Morfey1974/HVAC_CleanRoom_Project/Docs/WhatsApp Image 2026-07-08 at 12.15.31 (1).jpeg

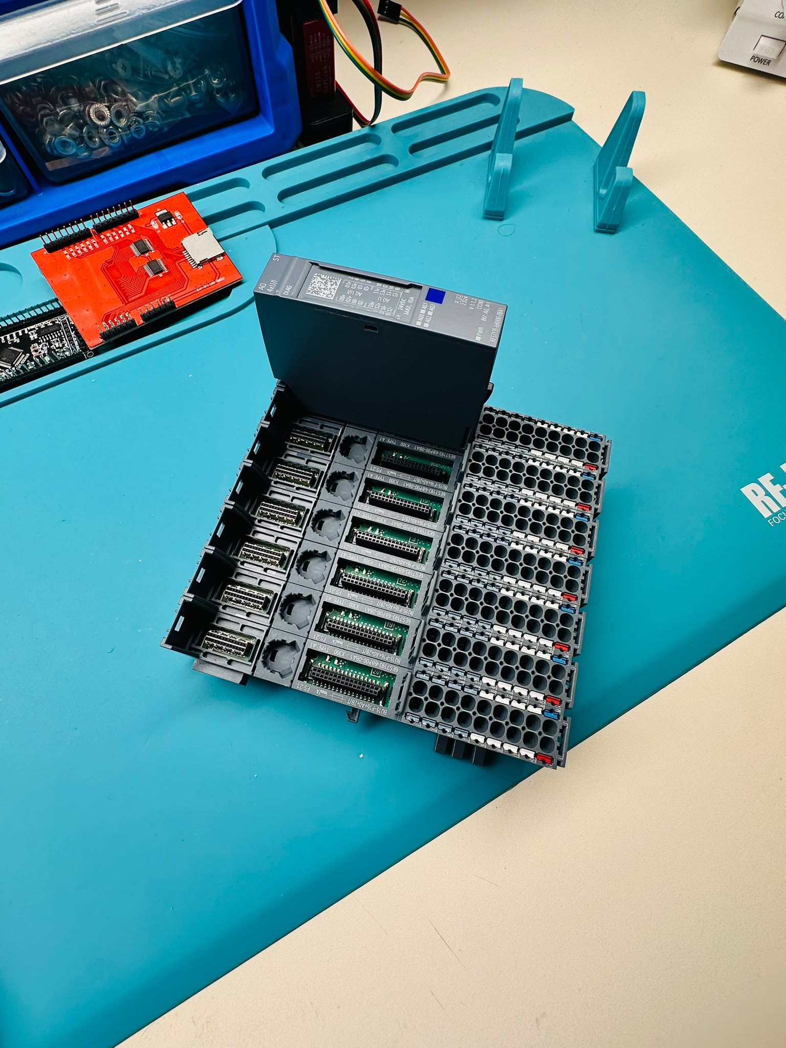
Docs/WhatsApp Image 2026-07-08 at 12.15.31 (1).jpeg
