Morfey1974/HVAC_CleanRoom_Project/Firmware_MainPLC/HANDOFF_модульная_система.md

# Резюме чата: модульная система I/O для HVAC / здания

**Дата:** 2025–2026 (чат в проекте Industrial Door PLC)  
**Цель документа:** передать контекст в новый проект модульной системы датчиков.

---

## 1. Общая идея

- **Головной PLC** — на базе платы контроллера дверей DCM (**STM32H723**, Ethernet RMII, CAN, RS-485, 24 V DC). Из схемы убрать всё, что связано с дверями (замки, светофоры, DI/DO дверей, ALARM). Остаётся «каркас» МК + связь.
- **Контроллер дверей** — отдельный узел, данные на головной PLC по **CAN** (уже есть в системе дверей).
- **Модули I/O** — **собственная разработка и бренд**, не Wago/Siemens.
- **Монтаж:** кабель с объекта (AWG22/24) **напрямую на клеммы модуля** на DIN-рейке — **без** промежуточных клеммников «модуль → ряд клемм на рейке» (как на фото шкафа Siemens S7-1500).
- **Модули в цепочке** («паровозик») на DIN, боковые разъёмы plug-and-play.
- **Пуск за 2–3 часа** техником без языков программирования — через **своё приложение** (визуальная карта, привязка модулей/комнат, уставки). На этапе схем это только **требования к железу** (discovery, один logical device на поезд).

---

## 2. Архитектура поезда

```
[ Головной PLC (STM32H723) ] ←—— 1 кабель на поезд ——→ [ M-GW Шлюз ]
                                                            │ внутр. RS-485
                                        [Slice]—[Slice]—…—[ M-END ]
                                         4 клеммы поля
```

- **M-GW (шлюз)** — единственная точка связи поезда с PLC; master внутренней шины; **без DIP-адресов** для техника.
- **M-SLC-* (slice)** — полевые клеммы + внутренняя шина; **не** Ethernet/Modbus наружу.
- **M-END** — конец поезда, терминатор 120 Ω, проход 24 V.
- До **~100 точек** на объект → несколько поездов (**8–12 slice** на поезд — ориентир).

---

## 3. Ключевое решение по модулям датчиков

### Не делаем M-SLC-AI8-420 (16 клемм на 4 датчика)

### Делаем: **один модуль — один полевой прибор** (4 провода)

Пример: **Rotronic HF13x** (T + RH):

| Клемма | Сигнал |
|---|---|
| 1 | +24 VDC |
| 2 | GND |
| 3 | OUT1 — влажность (4–20 mA) |
| 4 | OUT2 — температура (4–20 mA) |

- **2 аналоговых входа AI** на модуль (не 8 AI на 8 датчиков).
- **Правило монтажа:** **один провод — одна клемма**, без пучков и без нескольких жил в одном винте.
- Ширина корпуса — на усмотрение заказчика (~4 mm на клемму DIN); допускается **один ряд** или **двухэтажные клеммы** (2×2); опционально вариант на **2 датчика** в двухэтажном корпусе — габариты не в ТЗ на схемы.
- Базовое обозначение: **M-SLC-AI2-420** (или M-SLC-TH1).

---

## 4. Связь

### PLC ↔ шлюз (M-GW)

**Рекомендация:** **Ethernet, Modbus TCP** — один IP на поезд, один logical slave = весь поезд.  
При ~10 поездах на объект — предпочтительно Ethernet, а не 10 UART.

**Альтернатива:** RS-485 Modbus RTU, **один адрес на поезд**, RJ-45 с **задокументированной** распиновкой.

На **STM32H723** (CubeMX): **UART4** (PC10/11, DE PA15) и **USART3** (PD8/9) — для RS-485 это **2 независимые линии** (= 2 поезда). UART vs USART **не важно** — оба подходят для 8N1. В проекте дверей UART4 = IDP-485, USART3 = отладка — при HVAC переназначить.

### Внутри поезда (шлюз ↔ slice)

- **RS-485**, 115200, 8N1.
- Боковой разъём: +24V, GND, BUS+/BUS−, CHAIN (автонумерация слота).
- Slice: тип в EEPROM, **без** настройки адреса техником.

---

## 5. Электрика slice (для ТЗ на схемы)

- Гальваническая развязка поля (ориентир ≥1500 V RMS — уточнить в схеме).
- 4–20 mA: шунт / analog front-end, 16-bit ADC, обрыв / перегруз.
- Питание датчика +24 V с модуля — указать max ток.
- MCU на slice: опционально (может быть только front-end под управлением шлюза — решение фрилансера).

---

## 6. Номенклатура (этап 1 для фрилансера)

| Модуль | Назначение |
|---|---|
| **M-GW** | Шлюз поезда |
| **M-SLC-AI2-420** | 4 клеммы, 2×4–20 mA, 1 датчик T+RH |
| **M-END** | Конец шины |
| Позже | AI1-010, AO, DO, дисплей у комнаты |

---

## 7. ТЗ на схемы — что сдать фрилансеру

**В scope:** принципиальные схемы PDF + САПР, BOM, распиновка разъёмов, пояснительная записка, черновик карты регистров Modbus на поезд, расчёт 24 V.

**Вне scope:** PCB, корпуса, прошивка, приложение, головной PLC.

**Приёмка:** M-GW + M-SLC-AI2-420 + M-END полностью; единый боковой разъём; ERC чистый.

---

## 8. Отклонённые / уточнённые варианты

- ❌ Процессор + Modbus в **каждом** slice — дороже; для масштаба лучше **шлюз + slice**.
- ❌ AI8 с общими шинами +24/GND на одной клемме — **не по регламенту монтажа** заказчика.
- ❌ Сравнение с ET200/Wago как целевая продукция — только как референс идеи «клеммы на модуле»; настройка TIA неприемлема.
- ✅ Убрать провода PLC → клеммники → поле (как на фото шкафа Siemens).

---

## 9. Референсы в проекте дверей (Industrial Door PLC)

- Схема головного контроллера: `Documentation/Schematic_Industrial-door-controller-Master_2025-06-02.pdf`
- MCU: STM32H723
- RS-485 дверей (IDP-485): UART4, отдельный протокол от Modbus модулей I/O
- CAN: контроллер дверей

---

## 10. Открытые вопросы для нового чата

1. Ethernet vs RS-485 к шлюзам — финальный выбор.
2. MCU на slice или только analog front-end.
3. Распиновка RJ-45 (Ethernet vs полевой RS-485).
4. Карта регистров Modbus и протокол discovery.
5. Корпуса и точный тип клемм (заказчик).
6. Прошивка M-GW и приложение пуска.

---

## 11. Диаграмма целевой системы

```
        [ Ethernet / RS-485 вверх ]
                  │
        [ Головной PLC STM32H723 ]
           CAN          │ Modbus/Eth (несколько поездов)
              │         │
    [ PLC Doors ]   [ M-GW ]—[Slice]—[Slice]—[END]
                    [ M-GW ]—[Slice]—…
```

---

*Конец резюме. Продолжение: ТЗ для фрилансера, карта регистров, выбор Ethernet к шлюзам.*
