Morfey1974/HVAC_CleanRoom_Project/HANDOFF_HVAC.md

# HANDOFF: Проект HVAC_CleanRoom

**Актуализация:** 2026-10-02 (по фактическому состоянию репозитория).

## 1. Суть проекта
Распределенная система климат-контроля чистых помещений: Главный ПЛК, локомотивы (концентраторы), хаб дисплеев, вагоны (модули I/O), панели оператора. Связь — CAN/FDCAN.

## 2. Аппаратная часть (Analog_Modul_AI — вагон)
*   **МК:** STM32G0B1RBT6 (не F042 — устаревшая запись).
*   **CAN:** FDCAN2, 50 кбит/с, пины PC2 (RX), PC3 (TX).
*   **АЦП:** ADS1220 по SPI1 — PA5 SCK, PA6 MISO, PA7 MOSI; CS = PA4 (`STM_CS`); DRDY = PC4 (`STM_DRDY`, EXTI). SPI: 8 bit, CPHA = 2 Edge.
*   **Питание / поле:** 24 VDC, шина с CAN_H/CAN_L (детали в Docs / схемах Modul_AI).
*   **Статус:** проект CubeMX + HAL-каркас есть; драйвер ADS1220 и прикладной протокол CAN — впереди.

## 3. Остальные узлы (факт по репозиторию)
| Узел | МК | Статус |
|---|-----|---|
| Firmware_MainPLC | STM32H723ZGT6 | Есть: FreeRTOS, ETH+LwIP, FDCAN1–3, USB CDC, RS485-задачи |
| Firmware_Locomotive | STM32G0B1RBT6 | Каркас: FDCAN1+FDCAN2 @ 50 кбит/с |
| Firmware_HUB_Displays | STM32G0B1RBT6 | Каркас: FDCAN1+FDCAN2 @ 50 кбит/с |
| Firmware_Displays (TFT5) | STM32H723 | Legacy-панель SSD1963 |
| Analog_Modul_AO / DI / DO | — | Папки пустые |
| Shared_Libs | — | Пусто |
| Web_Interface | — | Пусто |

**Docs:** схемы HUB/AI/Main, `MainPLC_Hardware_Spec.md`, 3D (Modul HUB Display, Modul_AI, Modul_Lokomotiv), даташиты TFT 4.3" и 10.1", сметы.

## 4. Структура (Monorepo)
`Docs/`, `Shared_Libs/`, `Firmware_Wagons/`, `Firmware_Locomotive/`, `Firmware_HUB_Displays/`, `Firmware_MainPLC/`, `Firmware_Displays/`, `Web_Interface/`.

С 2026-10-04 у каждого модуля две части — два отдельных проекта CubeIDE: `<модуль>/Application` (основная прошивка) и `<модуль>/Bootloader` (загрузчик, пока пусто). Модули: `Firmware_MainPLC`, `Firmware_Locomotive`, `Firmware_HUB_Displays`, `Firmware_Displays/Display_TFT4.3` (проект «STM32H723ZGT6 with TFT5 SSD1963»), `Firmware_Wagons/Analog_Modul_AI|Analog_Modul_AO|Digital_Modul_DI|Digital_Modul_DO`. Имена проектов в CubeIDE не менялись. Общее для загрузчиков: `Shared_Libs/fwupd` (протокол обновления, заголовок прошивки, CRC32), `Shared_Libs/boot_core/stm32g0|stm32h7` (ядро загрузчика по типу чипа). Shared_Libs подключён в проектах как `${workspace_loc:/HVAC_CleanRoom_Project/Shared_Libs}` — от переноса не зависит.

CubeIDE: Hierarchical Presentation.

## 5. Следующие шаги
1. **`Shared_Libs/hvac_can.h`** — общий формат кадров (подключён в include paths Loco / AI / HUB / Displays). Сделано: кадр 0x301 «измерение AI» (влажность и температура ×0.01, байт статуса: обрыв/перегруз каналов, нет ответа АЦП, «нет связи» от локомотива; счётчик). Путь (с 2026-10-04): AI CAN2 → Loco CAN1 → Loco CAN2 → **MainPLC CAN1 → MainPLC CAN2** → HUB CAN2 → HUB CAN1 → дисплей CAN1. MainPLC: шлюз `plc_can.c` (пересылка 0x301, свой NO_LINK при молчании локомотива 2 с), веб-страница `plc_web.c` на http://192.168.1.50 (`/api/ai` — JSON). Двери (с 2026-10-04): MainPLC — Modbus RTU Master на RS-485 (UART4, DE=PA15, 115200 8N1), `plc_modbus.c` опрашивает DCM SuperPharm (адрес 1, ф-ция 0x02, адр. 0, кол-во 5, раз в 500 мс, таймаут 300 мс, 3 неответа → нет связи); кадр 0x310 (байт 0 — маска «закрыта», байт 1 — статус 0x80 «нет связи») раз в 500 мс в CAN2 → HUB → дисплей (блок «ДВЕРИ» в шапке справа). Временно на старой плате ПЛК — HSI вместо HSE (нет кварца). ETH-буферы — в D2 SRAM через `eth_dma_insert.ld` (второй -T для Debug, т.к. MMT-шаблон перегенерируется), куча lwIP с 0x30005000. Дальше — адресация и типы модулей.
2. **Analog_Modul_AI** — драйвер ADS1220 (SPI + DRDY), публикация измерений по CAN.
3. **Выровнять битрейт MainPLC FDCAN** с полевой сетью 50 кбит/с (сейчас в IOC номинал выглядит незавершённым).
4. **CAN-загрузчики (решения 2026-10-02; принцип и план обновления «одной кнопкой» приняты 2026-10-04 — `Docs/Firmware_Update_Concept.md`: главное хранилище — комп, на ПЛК копия текущих версий; сначала идентификация, потом обновление; новые/заменённые модули — автоматически, работающие — только по команде; молчание модуля не повод для прошивки; из OpenBLT — только идеи):**
   - Каждый модуль (Loco, HUB, AI/AO/DI/DO, дисплеи) заводски прошивается через ST-LINK **только загрузчиком**; экспериментальные прошивки модулей удаляются, в папке каждого модуля — свой загрузчик.
   - Загрузчик несёт данные модуля: **тип модуля** (зашит при сборке, у каждого вида платы свой), UID чипа, версию загрузчика, версию/CRC рабочей прошивки. Пины ID задают только позицию в цепочке, не тип.
   - Рабочие прошивки модулей хранит Главный ПЛК и рассылает по CAN (транзит через Loco/HUB) согласно типу и присвоенному ID.
   - Состояния модуля: «новый, без рабочей прошивки» и «есть прошивка, требуется обновление».
   - **Замена модуля:** ПЛК обнаруживает новый/заменённый модуль; пустому — заливает прошивку; если прошивка есть — проверяет версию и целостность (CRC), устаревшую или битую — перезаливает.
   - Эксперимент MainPLC (когда придёт плата): идентификация всех подключённых модулей → присвоение ID → рассылка прошивок → вывод T/RH с HF523 на дисплей.
   - Загрузчики, протокол идентификации/адресации и обновления, хранение прошивок в ПЛК — пишутся **сразу как боевые заготовки** (общие модули в Shared_Libs, без хаков), чтобы перейти в рабочий код без переделок. Экспериментальная часть — только прикладная логика T/RH.
   - **Этап 1 (код готов 2026-10-04, ждёт проверки на железе):** протокол `Shared_Libs/fwupd/` (fwupd_proto.h, fwupd_app.c — часть рабочей прошивки), ядро загрузчика G0 `Shared_Libs/boot_core/stm32g0/`. Локомотив: проект `Firmware_Locomotive/Bootloader` (16 КБ, 0x08000000, -Os), рабочая прошивка с 0x08004000 и заголовком HVFW на +0x100, метаданные 0x0801F800. MainPLC: `plc_fwupd.c` (перекличка и обновление по CAN1). Этап 1 проверен на железе 2026-10-04 (встроенный образ потом удалён).
   - **Обновление по Ethernet (код готов 2026-10-05, ждёт проверки на железе):** MainPLC: `plc_w25q.c` (W25Q128 по OCTOSPI1, одна линия), `plc_fwstore.c` (на тип модуля 1 МБ = два места по 512 КБ: дескриптор "FWST" 4 КБ + образ; роли текущая/новая/резервная; загрузка всегда в не-текущее место; перевод новая→текущая после удачного обновления всех модулей), `plc_fwupd.c` (авто — образом «текущая»; ручной запуск по типу — «новая», режимы «с другой версией» / «все»; журнал 32 события), `plc_web.c` (HTTP: `GET /api/fw/status?log=N`, `POST /api/fw/upload?size=&crc=` потоком в W25Q, `POST /api/fw/run?type=&mode=`, `POST /api/fw/cancel`). Приложение Web_Interface: таблица `FirmwareFiles` (миграция Firmware), разбор .bin/.elf (заголовок HVFW, дополнение до 8 байт 0xFF, CRC32), `FirmwareController` (/api/firmware, роли Engineer/Admin), `PlcFirmwareClient` (адрес из «Система → Общие → IP-адрес ПЛК», запросы к ПЛК по одному), `PlcFirmwareLogPoller` (журнал ПЛК → журнал действий, каждые 5 с), вкладка «Система → Прошивки». Отладка в CubeIDE: Live Expressions `g_plc_fwupd`.
   - **Будущее (после проверки Ethernet на MainPLC, вместе с веб-конфигуратором):** ID модулей должны совпадать с нумерацией в веб-конфигураторе. Конфигурация уходит в ПЛК, ПЛК обходит цепочку и присваивает ID по ней; несовпадения (тип не тот, модуля нет, лишний модуль, дубль номера) — сообщения с описанием проблемы в веб и на дисплей. Сейчас — только задел: формат ID и обход цепочки проектировать так, чтобы ID можно было брать из конфигурации, а не только по порядку.
5. Заполнить AO / DI / DO и Web_Interface по мере готовности железа.
6. **Web_Interface: реальные T/RH в комнатах (код готов 2026-10-05, ждёт проверки на стенде).** Библиотека: у датчиков список выходов (величина, сигнал, диапазон, ед.) — `LibraryItem.OutputsJson`, миграция SensorOutputs. Проект: канал модуля привязывается к оборудованию-датчику и номеру его выхода (`ModuleChannelDto.EquipmentId/Output`, редактор каналов в «Модулях» и на схеме). Источник данных «Система → Общие»: симулятор или «ПЛК по Ethernet» — `PlcLiveLink.cs` (`PlcLinkRouter`, `PlcLiveReader`: раз в 1 с `GET /api/ai`, раз в 5 с перечитывает режим и проводку активного на объекте проекта). Сейчас ПЛК отдаёт одно измерение AI: влажность → `<ID первого AI>.CH1`, температура → `.CH2`; аварии plcOffline/locoNoLink/aiNoAnswer/aiAdcFault/displayBusOff/channelBroken. «Мониторинг»: полоса состояния цепочки (ПЛК, локомотив, AI, измерение, передано на дисплей) и карточки комнат (значения датчиков комнаты против уставки/допуска; демо-мнемосхема только у DEMO-001). Дальше: редактор мнемосхем HMI, единые коды типов модулей приложения и прошивки.
7. **Конфигурация в ПЛК (код готов 2026-10-05, ждёт проверки на стенде).** Приложение собирает из проекта файл HCFG (модули + каналы с сигналом и диапазоном датчика) и заливает в ПЛК (раздел проекта «Выгрузка в ПЛК», только активный на объекте проект). ПЛК 1.1: plc_cfg.c — хранение в W25Q 0x0000–0x7FFF (две копии), рассылка 0x330 модулям, приём 0x331, проверка цепочки, /api/cfg, /api/cfg/status, события журнала 14–17. Локомотив 1.1 пересылает 0x330/0x331. AI 1.1 принимает тип сигнала (выкл / 4-20 / 0-20 мА) и диапазон канала, шлёт статус раз в 1 с; по умолчанию как раньше (CH1 0..100, CH2 0..50, 4-20 мА). Подробно — Docs/Firmware_Update_Concept.md, раздел 5.
8. **Загрузчики всех модулей, номера по цепочке, откат (код готов 2026-10-05, ждёт проверки на стенде).** Новые проекты CubeIDE: `Analog_Modul_AI_Bootloader`, `Firmware_HUB_Displays_Bootloader`, `Display_TFT4.3_Bootloader` (H7, без .ioc; ядро `Shared_Libs/boot_core/stm32h7`). Рабочие прошивки: AI (тип 5) и HUB (тип 3) с 0x08004000, дисплей (тип 4) с 0x08020000 (VTOR 0x08020400). ПЛК 1.2: обновление по обеим шинам (CAN1 — локомотив, CAN2 — HUB и дисплеи), `plc_id.c` — обход цепочки ID и номера из конфигурации, проверка мест в `plc_cfg.c` (нет / другой тип / лишний / вне цепочки), кадр 0x352 итога для дисплеев, `POST /api/id/walk`, `POST /api/fw/rollback?type=`. Локомотив 1.2 и HUB 1.1 пересылают кадры обновления и ID. Дисплей 1.1 показывает свой номер и первую проблему цепочки. Приложение: «Выгрузка в ПЛК» — колонка «Плата», лишние модули, кнопка «Найти модули»; «Прошивки» — кнопка «Откатить». Выходы ID считаются активными высоким уровнем — проверить на стенде. Подробно — Docs/Firmware_Update_Concept.md.
9. **Линия 3 на CAN3 и мастер дверей (ПЛК 1.4, 2026-10-06, прошит, стенд 1–2 линий в норме).** CAN3 (FDCAN3, настройки MX без изменений) — линия ID 3 (выход PE1 `MODUL_ID_OUT_BUS`): обход, номера, обновление прошивок, CFG_SET по линии модуля (`PlcCan_LineBus`). Кадры AI, 0x310 и 0x352 ПЛК шлёт в CAN2 и CAN3 (AI не возвращается в шину, откуда пришёл). Обмен с мастером дверей описан в `Shared_Libs/hvac_can.h`: 0x320 состояние (мастер → ПЛК, 500 мс), 0x321 команда, 0x322 ответ, 0x323 «ПЛК жив» (1 с). Пока приходит 0x320, двери для дисплеев берутся из него, иначе по Modbus. ПЛК: `GET /api/can3`, `POST /api/can3/send?id=&data=`, `POST /api/doors/cmd?cmd=&mask=`. Приложение: «Система → CAN3 и двери». Протокол мастера — предложение со стороны HVAC, сверить при подключении платы мастера. Повторная отправка CAN в MX выключена на всех трёх шинах (кадр без подтверждения теряется). Вагоны прямо на шине без головы конфигуратор пока не допускает; локомотив, у которого оба CAN на одной шине, зациклит кадры.
10. **Редактор HMI и ИИ-помощник (решения 2026-10-07, Docs/Web_Interface_Plan.md §5.7).** Плоский вид со склейкой секций установки, комнаты — плитки в ряд, 3D — отдельный просмотр позже. Отдельная библиотека HMI (черновик/утверждён, версии, копия в проекте), первое наполнение по NanoMotion. Облачный помощник (Gemini через ключ Google AI Studio, запасной — Cursor) разбирает документы в таблицу предложений; связь с редактором — общий словарь видов оборудования. Этапы 1–7 в плане. Этапы 1–2 сделаны (2026-10-07): таблицы HmiElements/HmiScreens (миграция Hmi), `HmiService`/`HmiController`, начальное наполнение в DbSeeder (14 элементов NanoMotion, экраны «AC-1» и «Комнаты» у неархивного DEMO-001); интерфейс — «Библиотека HMI» (`pages/Hmi`), «Экраны HMI» в проекте (`HmiScreensPage`, палитра, перетаскивание, привязка сигналов, обновление из библиотеки), показ в «Мониторинге» (`hmi/AhuView`, `hmi/RoomTiles`, `hmi/arts`). Дальше этап 3: приём документов и настройки ИИ (поле ключа Gemini).
