Morfey1974/HVAC_CleanRoom_Project/Docs/Сертификация/QAData_21CFR_Part11_RU.md

# FDA Title 21 CFR Part 11  
Электронные записи; электронные подписи

Источник: www.qadata.co.za  
Перевод презентации QAData (38 слайдов)

---

## Слайд 1. Введение

**FDA Title 21 CFR Part 11: Electronic Records; Electronic Signatures; Final Rule (1997)**

Первоначальный выпуск правила:

- громкие замечания по итогам аудитов;
- жалобы отрасли на лишние затраты и требования без практической пользы;
- путаница в смежных отраслях: изделия медицинского назначения, биологические препараты.

В итоге выпустили руководящий документ.

---

## Слайд 2. Введение

**Guidance for Industry, Part 11, Electronic Records; Electronic Signatures — Scope and Application (2003)**

Этого оказалось недостаточно, потому что:

- это руководство, а не закон;
- отражает лишь «текущую позицию» FDA;
- многим в отрасли, хотя и понравился более узкий охват, казалось, что в отдельных местах руководство 2003 года противоречит требованиям Окончательного правила 1997 года.

---

## Слайд 3. Введение

**Guidance for Industry Computerized Systems Used in Clinical Investigations (2007)**

Дополнительное руководство:

- дополняет предыдущие документы;
- определяет охват CFR Part 11 и случаи, когда оно применяется.

---

## Слайд 4. Предыстория

- 21 CFR Part 11 занимает 36 страниц, из них только 3 — сам текст правила, остальные 33 — преамбула с комментариями FDA на отзывы отрасли.
- В Part 11 всего 19 требований. Часть из них специфична именно для Part 11, остальные — более общие требования одного или нескольких правил FDA.
- В этой презентации перечислены самые важные требования и даны пояснения по внедрению.

---

## Слайд 5. Когда применяется? Новый, узкий охват

По новому узкому охвату руководства Part 11 применяется, если:

- запись требуется исходным правилом (predicate rule), например электронные протоколы серии по 21 CFR Part 211 и электронные записи обучения по 21 CFR Part 58;
- электронные записи используются, чтобы показать соответствие исходному правилу, например электронные записи обучения для соответствия 21 CFR Part 211.

*(Исходное правило = все остальные разделы 21 CFR.)*

---

## Слайд 6. Когда применяется?

1. Когда электронные записи используются вместо бумаги.
2. Когда люди делают распечатки, но по-прежнему опираются на электронные записи в компьютере, чтобы выполнять регулируемые действия.
3. Записи, подаваемые в FDA по исходным правилам (даже если такие записи прямо не названы в правилах ведомства) в электронном виде.
4. Электронные подписи, которые должны быть равнозначны рукописным подписям, инициалам и иным обычным подписаниям, требуемым исходными правилами.

---

## Слайд 7. Когда применяется?

Пункты 1, 3 и 4 очевидны; пояснения нужны к пункту 2.

«Когда люди делают распечатки, но по-прежнему опираются на электронные записи в компьютере, чтобы выполнять регулируемые действия.»

**Регулируемое действие** — любое действие, которое требуется правилом FDA.

---

## Слайд 8. Пошаговая схема

1. Проверить, требуется ли запись исходным правилом или используется, чтобы показать соответствие исходному правилу.
2. Затем определить, попадает ли запись под новый узкий охват.

Главный критерий: ведётся ли запись в электронном виде вместо бумаги, либо ведётся и в электронном виде, и на бумаге, но люди опираются на электронную запись, чтобы выполнять регулируемые действия.

---

## Слайд 9. Пошаговая схема

Правило действует на все шаги: от сбора данных до их оценки.

3. Наконец, оценить риск критичности записей Part 11 и зафиксировать результат.
4. По итогам внедрить соответствующие меры контроля Part 11.

---

## Слайд 10. Требования CFR Part 11 (1–19)

### Валидация системы — 11.10(a)

Валидация должна включать и функции конкретного приложения, и функции, связанные с Part 11: электронный журнал аудита и электронные подписи. Рекомендуемые проверки:

- **Ограниченный и разрешённый доступ к системе.** Вводить верные и неверные пароли и смотреть, ведёт ли система себя как задумано.
- **Ограниченный доступ к отдельным задачам и правам.** Пытаться получить доступ к задачам в рамках прав, выданных администратором, и проверять, что система ведёт себя по спецификации.
- **Журнал аудита, формируемый компьютером.** Выполнить действия, которые по спецификации должны попасть в электронный журнал. Записать действия вручную и сравнить с журналом, который сформировал компьютер.

---

## Слайд 11. Требования CFR Part 11 (1–19)

### Валидация системы — 11.10(a), продолжение

- **Точные и полные копии.** Посчитать результаты из исходных данных по заданному набору параметров оценки (например, события интегратора хроматограммы, таблицы калибровки и т. п.). Сохранить исходные данные, итоговые результаты и параметры оценки на носителе. Выключить компьютер. Включить снова и повторить те же действия по данным с носителя. Результаты должны совпасть с первоначальной оценкой.
- **Привязка подписей к записям.** Подписать файл данных электронной подписью. Проверить устройство системы и убедиться, что между электронной подписью и файлом есть явная связь. Например, в связи должны быть печатное имя или однозначная ссылка на подписавшего, дата и время, а также смысл подписи.

---

## Слайд 12. Требования CFR Part 11 (1–19)

### Точные и полные копии — 11.10(b) и 11.10(c)

«Должны быть процедуры, позволяющие получать точные и полные копии записей как в удобочитаемом для человека виде, так и в электронном виде, пригодном для проверки, просмотра и копирования ведомством. При вопросах о возможности ведомства выполнить такой просмотр и копирование электронных записей следует обращаться в ведомство.»

---

## Слайд 13. Требования CFR Part 11 (1–19)

### Точный и быстрый поиск — 11.10(c)

«Записи должны быть защищены так, чтобы их можно было точно и быстро извлечь на протяжении всего срока хранения.»

- Ведомство хочет иметь возможность проследить итоговые результаты до исходных данных теми же средствами, которыми пользовался оператор, когда эти данные создавались.

Учитывая, что в ряде случаев записи нужно хранить десять и более лет, а срок жизни компьютеров и программ гораздо короче, по этому пункту можно ожидать затруднений.

---

## Слайд 14. Требования CFR Part 11 (1–19)

### Ограниченный доступ — 11.10(d)

«Должны быть процедуры, ограничивающие доступ к системе только уполномоченными пользователями.»

- Ограниченный доступ обеспечивается физическими и/или логическими мерами защиты.
- У большинства компаний такие процедуры уже есть. Для логической защиты пользователи обычно входят в систему по идентификатору и паролю. Для зон высокого риска (например, центры обработки данных с сетевыми серверами и резервными копиями) дополнительно к логической защите рекомендуются физические меры: замки или пропуска. Эти процедуры должны быть хорошо описаны и провалидированы.

---

## Слайд 15. Требования CFR Part 11 (1–19)

### Независимый от пользователя компьютерный журнал аудита с меткой времени — 11.10(e)

«Должны быть процедуры применения защищённых, формируемых компьютером журналов аудита с меткой времени, чтобы независимо фиксировать дату и время действий оператора, которые создают, изменяют или удаляют электронные записи. Изменения не должны скрывать ранее записанную информацию. Такая документация журнала должна храниться не меньше, чем сами соответствующие электронные записи, и быть доступна ведомству для просмотра и копирования.»

Этот пункт вызывал много вопросов и обсуждений. Сложность в основном в том, как его внедрять, особенно какие подробности записывать.

---

## Слайд 16. Требования CFR Part 11 (1–19)

### Журнал аудита — 11.10(e), продолжение

- Главное слово — **«независимо»**: независимо от оператора. Цель — обеспечить и доказать целостность данных.
- Если данные изменены, компьютер должен записать, *что* изменено и *кто* это сделал. Функция журнала должна быть встроена в программу; она особенно важна для критичных компьютерных процессов с ручным участием оператора.

---

## Слайд 17. Требования CFR Part 11 (1–19)

### Операционные проверки системы — 11.10(f)

«Должны быть процедуры применения операционных проверок системы, чтобы при необходимости обеспечивать разрешённую последовательность шагов и событий.»

---

## Слайд 18. Требования CFR Part 11 (1–19)

### Проверки полномочий — 11.10(g)

«Должны быть процедуры применения проверок полномочий, чтобы только уполномоченные лица могли пользоваться системой, электронно подписывать запись, получать доступ к устройству ввода или вывода, изменять запись или выполнять текущую операцию.»

- Проверки полномочий нужны, чтобы обеспечить «подлинность, целостность и конфиденциальность» электронных записей и чтобы подписант не мог «легко отказаться от подписанной записи как от неподлинной».

---

## Слайд 19. Требования CFR Part 11 (1–19)

### Проверки полномочий — 11.10(g), продолжение

- Нужны и процедурные, и технические меры. Должны быть процедуры назначения доступа к системам и разрешённых задач конкретным лицам; система должна уметь проверить, что данное лицо вправе выполнить запрошенную функцию.
- Проверки полномочий применяются, когда человек пытается:
  - войти в систему;
  - выполнить выбранные разрешённые задачи;
  - изменить запись;
  - электронно подписать запись.

---

## Слайд 20. Требования CFR Part 11 (1–19)

### Проверки устройств — 11.10(h)

«Должны быть процедуры применения проверок устройств (например, терминала), чтобы при необходимости подтверждать достоверность источника ввода данных или операционной команды.»

- Требование относится к автоматическому определению идентификации и местоположения оборудования или другой компьютерной системы. Пример: система, управляющая прибором, должна автоматически распознать оборудование как допустимое устройство ввода по серийному номеру. Если номер не заведён в базе компьютера, прибор нельзя использовать как устройство ввода.
- Проверки устройств нужны не всегда, а только «где уместно».

---

## Слайд 21. Требования CFR Part 11 (1–19)

### Квалификация персонала — 11.10(i)

«Должны быть процедуры, подтверждающие, что лица, которые разрабатывают, сопровождают или используют системы электронных записей и электронных подписей, имеют образование, подготовку и опыт для своих задач.»

- Квалификация персонала — требование GxP, а не специфичное для Part 11. Нужны процедуры описания задач и квалификации, анализа пробелов и плана устранения тех пробелов, которые можно закрыть. Пункт относится и к пользователям, и к разработчикам систем, и к тем, кто поддерживает любые компьютерные системы, включая сетевую инфраструктуру.
- Также относится к третьим сторонам, например внешним подрядчикам, сопровождающим ИТ-инфраструктуру.

---

## Слайд 22. Требования CFR Part 11 (1–19)

### Персональная ответственность — 11.10(j)

«Должны быть процедуры установления и соблюдения письменных политик, по которым лица несут ответственность за действия, совершённые под их электронными подписями, чтобы удерживать от подделки записей и подписей.»

- Процедуры должны доводить до сотрудников, что электронная подпись означает то же, что рукописная. Содержание процедур следует доносить на обучении и контролировать.
- Рекомендуется, чтобы сотрудники подписывали заявление вроде: «Я понимаю, что электронные подписи имеют юридическую силу и равнозначны рукописным.»

---

## Слайд 23. Требования CFR Part 11 (1–19)

### Контроль документации на систему — 11.10(k)

«Должны быть процедуры надлежащего контроля документации на системы, включая: (1) достаточный контроль распространения, доступа и использования документации по эксплуатации и обслуживанию системы; (2) процедуры управления ревизиями и изменениями, чтобы вести журнал, фиксирующий во времени разработку и изменение документации на систему.»

---

## Слайд 24. Требования CFR Part 11 (1–19)

### Контроль документации на систему — 11.10(k), продолжение

- Документация на систему включает все документы жизненного цикла: планирование валидации, оценку поставщика, проектную документацию и спецификации, записи установки, процедуры и протоколы эксплуатации и испытаний, управление изменениями, процедуры обеспечения безопасности системы и подлинности оператора. Вся документация должна проходить утверждённое управление изменениями и контроль ревизий. Нужны меры, чтобы всегда использовалась самая свежая версия документа.

---

## Слайд 25. Требования CFR Part 11 (1–19)

### Цифровые подписи для открытых систем — 11.30

«Лица, которые используют открытые системы для создания, изменения, ведения или передачи электронных записей, должны применять процедуры и меры контроля, обеспечивающие подлинность, целостность и, где уместно, конфиденциальность электронных записей от момента создания до момента получения. Такие процедуры и меры должны включать, где уместно, те же, что для закрытых систем, а также дополнительные меры: шифрование документов и применение подходящих стандартов цифровой подписи, чтобы при необходимости обеспечить подлинность, целостность и конфиденциальность записи.»

---

## Слайд 26. Требования CFR Part 11 (1–19)

### Цифровые подписи для открытых систем — 11.30, продолжение

- Для этого нужна программа шифрования документов, а иногда — оборудование и программа для формирования цифровых подписей. Обычно компьютерные системы в фармацевтике — закрытые, цифровые подписи им не нужны. Пример открытой системы: аналитические данные контрактной лаборатории передаются заказчику через общественный интернет.
- Примеры использования открытых систем описаны в презентации 5.

---

## Слайд 27. Требования CFR Part 11 (1–19)

### Требования к подписанным электронным записям — 11.50

«(a) Подписанные электронные записи должны содержать сведения, связанные с подписанием, которые ясно указывают всё следующее:

(1) печатное имя подписавшего;  
(2) дату и время выполнения подписи;  
(3) смысл подписи (например, проверка, утверждение, ответственность или авторство).

(b) Сведения из пунктов (a)(1), (a)(2) и (a)(3) подлежат тем же мерам контроля, что и электронные записи, и должны входить в любой удобочитаемый вид электронной записи (экран или распечатка).»

---

## Слайд 28. Требования CFR Part 11 (1–19)

### Связь записей с подписями — 11.70

«Электронные подписи и рукописные подписи, поставленные к электронным записям, должны быть связаны с соответствующими электронными записями так, чтобы подписи нельзя было обычными средствами вырезать, скопировать или иначе перенести для подделки электронной записи.»

- Главная цель — связать электронные подписи с соответствующими электронными записями и с подписавшим.
- Система должна узнавать подписавшего по идентификатору и паролю; процедуры и технические меры должны обеспечивать уникальную идентификацию подписавшего.

---

## Слайд 29. Требования CFR Part 11 (1–19)

### Связь записей с подписями — 11.70, продолжение

- Нужны не только процедуры, но и изменение поведения при работе с идентификаторами и паролями.
- Табу на передачу пароля коллеге обычно слабее, чем на обучение подделывать рукописную подпись. По Part 11 последствия те же.
- Программа также должна распознавать любое изменение уже подписанной записи. Обычно это делается связью электронной подписи с электронным журналом аудита.

---

## Слайд 30. Требования CFR Part 11 (1–19)

### Общие требования к электронным подписям — 11.100

«(a) Каждая электронная подпись должна быть уникальна для одного лица и не должна повторно использоваться или передаваться кому-либо ещё.

(b) Прежде чем организация создаст, назначит, подтвердит или иным образом санкционирует электронную подпись лица или любой её элемент, организация должна проверить личность этого лица.

(c) Лица, использующие электронные подписи, должны до начала использования или в момент начала использования письменно подтвердить ведомству, что электронные подписи в их системе, применяемые 20 августа 1997 года или позднее, предназначены быть юридически равнозначными обычным рукописным подписям.

---

## Слайд 31. Требования CFR Part 11 (1–19)

### Общие требования к электронным подписям — 11.100, продолжение

(1) Подтверждение подаётся на бумаге и подписывается обычной рукописной подписью в Office of Regional Operations (HFC-100), 5600 Fishers Lane, Rockville, MD 20857.

(2) Лица, использующие электронные подписи, должны по запросу ведомства предоставить дополнительное подтверждение или показания, что конкретная электронная подпись юридически равнозначна рукописной подписи данного лица.»

---

## Слайд 32. Требования CFR Part 11 (1–19)

### Состав и контроль электронных подписей — 11.200

«(a) Электронные подписи, не основанные на биометрии, должны:

(1) использовать не менее двух различных компонентов идентификации, например код идентификации и пароль.

(i) Если лицо выполняет серию подписаний в течение одного непрерывного периода контролируемого доступа к системе, первое подписание выполняется всеми компонентами электронной подписи; последующие — не менее чем одним компонентом, который может выполнить и предназначен только для этого лица.

---

## Слайд 33. Требования CFR Part 11 (1–19)

### Состав и контроль электронных подписей — 11.200, продолжение

«…(ii) Если лицо выполняет одно или несколько подписаний не в течение одного непрерывного периода контролируемого доступа, каждое подписание выполняется всеми компонентами электронной подписи.

(2) Использоваться только подлинными владельцами; и

(3) Управляться и выполняться так, чтобы попытка использовать электронную подпись лица кем-либо, кроме подлинного владельца, требовала сговора двух или более лиц.

(b) Электронные подписи на основе биометрии должны быть устроены так, чтобы ими не мог воспользоваться никто, кроме подлинных владельцев.»

---

## Слайд 34. Требования CFR Part 11 (1–19)

### Контроль кодов идентификации и паролей — 11.300

Лица, использующие электронные подписи на основе кодов идентификации в сочетании с паролями, должны применять меры контроля их безопасности и целостности. Такие меры включают:

(a) поддержание уникальности каждой пары «код идентификации + пароль», чтобы ни у двух лиц не было одинаковой комбинации;

(b) периодическую проверку, отзыв или смену выданных кодов и паролей (например, при истечении срока пароля).

---

## Слайд 35. Требования CFR Part 11 (1–19)

### Контроль кодов идентификации и паролей — 11.300, продолжение

(c) процедуры действий при утрате: электронно отзывать утерянные, украденные, пропавшие или иным образом скомпрометированные токены, карты и другие устройства, которые несут или генерируют код идентификации или пароль, и выдавать временные или постоянные замены при строгом контроле;

(d) защитные меры транзакций, чтобы предотвращать несанкционированное использование паролей и/или кодов идентификации и немедленно, в срочном порядке сообщать о любых попытках такого использования службе безопасности системы и, где уместно, руководству организации.

---

## Слайд 36. Требования CFR Part 11 (1–19)

### Контроль кодов идентификации и паролей — 11.300, продолжение

(e) первоначальные и периодические испытания устройств (токенов, карт и т. п.), которые несут или генерируют код идентификации или пароль, чтобы убедиться, что они работают правильно и не изменены без разрешения.»

---

## Слайд 37. 21 CFR Part 11 — кратко

- Внедрение правила об электронных подписях и записях будет иметь серьёзные последствия.
- Рекомендуется идти по шагам, см. файл `CFR PART 11_stepbystep.pdf`.

---

## Слайд 38.

*(пустой / конец презентации)*
