Morfey1974/HVAC_CleanRoom_Project/.agent/rules/project-structure.md

---
trigger: always_on
---
# Структура проекта HVAC

Соблюдай следующую иерархию папок:
- `Firmware_MainPLC` — главный контроллер (ПЛК).
- `Firmware_Locomotive` — головной блок управления.
- `Firmware_Wagons` — модули и периферия (например, датчики).
- `Firmware_Displays` — экраны (панели оператора).
- `Shared_Libs` — общие библиотеки.
- `Web_Interface` — веб-часть.
- `Docs` — документация.

У каждого модуля две части: `<модуль>/Application` (основная прошивка) и `<модуль>/Bootloader` (загрузчик). Общее ядро загрузчика — `Shared_Libs/boot_core/<тип чипа>`, протокол обновления — `Shared_Libs/fwupd`.

Строго размещай изменения только в нужной папке.
