Morfey1974/HVAC_CleanRoom_Project/Docs/ТЗ.docx

ПОЖАЛУЙСТА НАПИШИТЕ МНЕ НА

ЭЛЕКТРОННАЯ ПОЧТА

didodmytro@ukr.net

ОБЩИЕ ТРЕБОВАНИЯ К СИСТЕМЕ

Система предназначена для приема данных от первичных преобразователей аналоговых сигналов, их обработки и передачи в систему управления более высокого уровня. Кроме того, система должна обеспечивать минимально достаточный интерфейс человек-машина для работы, что обеспечит работу базовых функций системы (отображая значения входных значений каждого из основных преобразователей в реальном времени) без участия системы управления более высокого уровня.

Система должна включать:

- Главный контроллер

- аналоговые входные модули

- Модуль интерфейса человек-машина.

Система должна поддерживать работу до 32 аналоговых входных модулей.

ТРЕБОВАНИЯ К АНАЛОГОВЫМ ВХОДНЫМ МОДУЛЯМ

Каждый из аналоговых входных модулей должен быть независимым функциональным устройством с собственным микроконтроллером и обеспечивать приём, нормализацию, преобразование аналоговых сигналов в цифровую форму, обработку полученных данных и передачу результатов измерений на главный контроллер.

Каждый из аналоговых входных модулей должен выполнять следующие функции:

- обработка сигналов от первичных измерительных преобразователей со стандартизированными выходными сигналами тока (4...20 мА) и напряжения (0...10 В), а также от термопар типов K и J и сопротивляющих термометров Pt100, Pt1000 и 50M;

- измерения с основной сниженной ошибкой для всех аналоговых входов не более ±0,5 % от верхнего предела диапазона измерений;

- обмен данными с главным контроллером через гальванически изолированный интерфейс CAN.

Каждый аналоговый входный модуль должен питаться от главного контроллера.

Выбор типа входного сигнала должен осуществляться с установкой перемычек конфигурации на плате модуля.

ТРЕБОВАНИЯ К ГЛАВНОМУ КОНТРОЛЛЕРУ

Главный контроллер должен выполнять следующие функции:

- Питание всех аналоговых входных модулей, входящих в систему, с гальванической изоляцией от основных силовых цепей главного контроллера.

- обмен данными со всеми аналоговыми входными модулями, включёнными в систему, через гальванически изолированный интерфейс CAN.

- Обмен данными с системой управления более высокого уровня с использованием гальванически изолированного интерфейса RS485 (аппаратный уровень).

- обмен данными с интерфейсом человек-машина.

Главный контроллер должен питаться от внешнего питания постоянного тока с номинальным значением 24 В. Главный контроллер должен оставаться в рабочем состоянии при изменении напряжения питания в диапазоне от 18 до 36 В без ухудшения нормализованных технических характеристик. Необходимо обеспечить защиту от переключения полярности и защиту от перенапряжения в цепи питания.

Аппаратное обеспечение главного контроллера не должно создавать дополнительные ошибки в результатах измерений аналоговых входных модулей.

ТРЕБОВАНИЯ К ПРОЕКТУ

- проект должен быть выполнен с использованием EasyEDA CAD.

- проект должен быть оптимизирован для производства печатной платы и её последующего монтажа в компании https://jlcpcb.com

- все компоненты, используемые в проекте, должны быть доступны для покупки на/или https://jlcpcb.com и /или https://www.lcsc.com

- Все компоненты, используемые в проекте, должны иметь баланс на складе поставщика не менее 5000 единиц на момент завершения проекта.
