Morfey1974/HVAC_CleanRoom_Project/Docs/Display TFT10.1/1.png

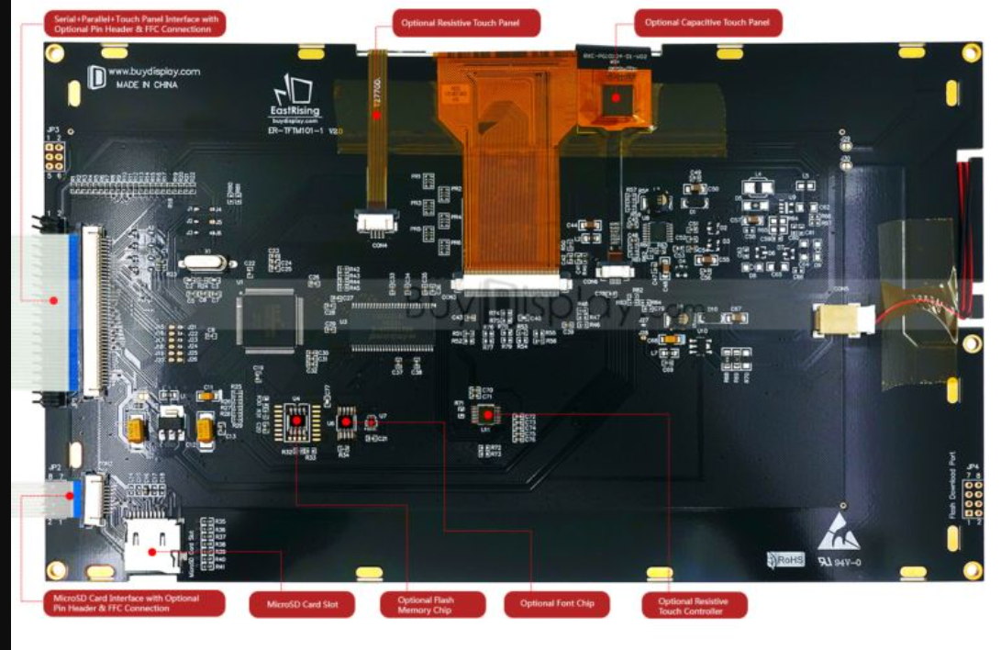
Docs/Display TFT10.1/1.png
