Morfey1974/HVAC_CleanRoom_Project/Docs/Display TFT10.1/_con40_p0.png

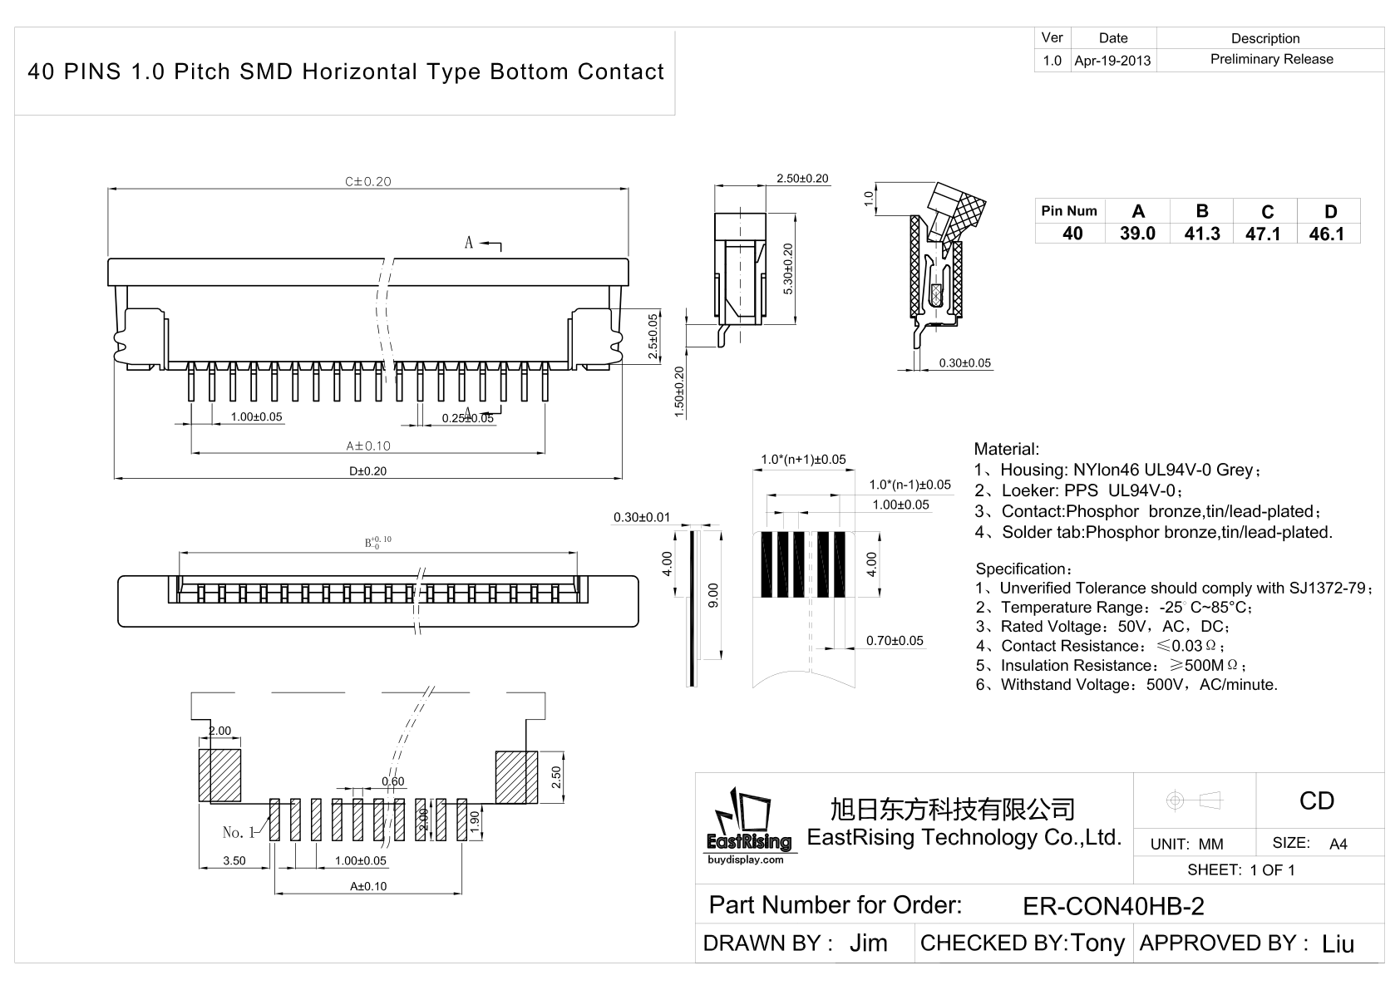
Docs/Display TFT10.1/_con40_p0.png
