Morfey1974/HVAC_CleanRoom_Project/Docs/page-1.jpg

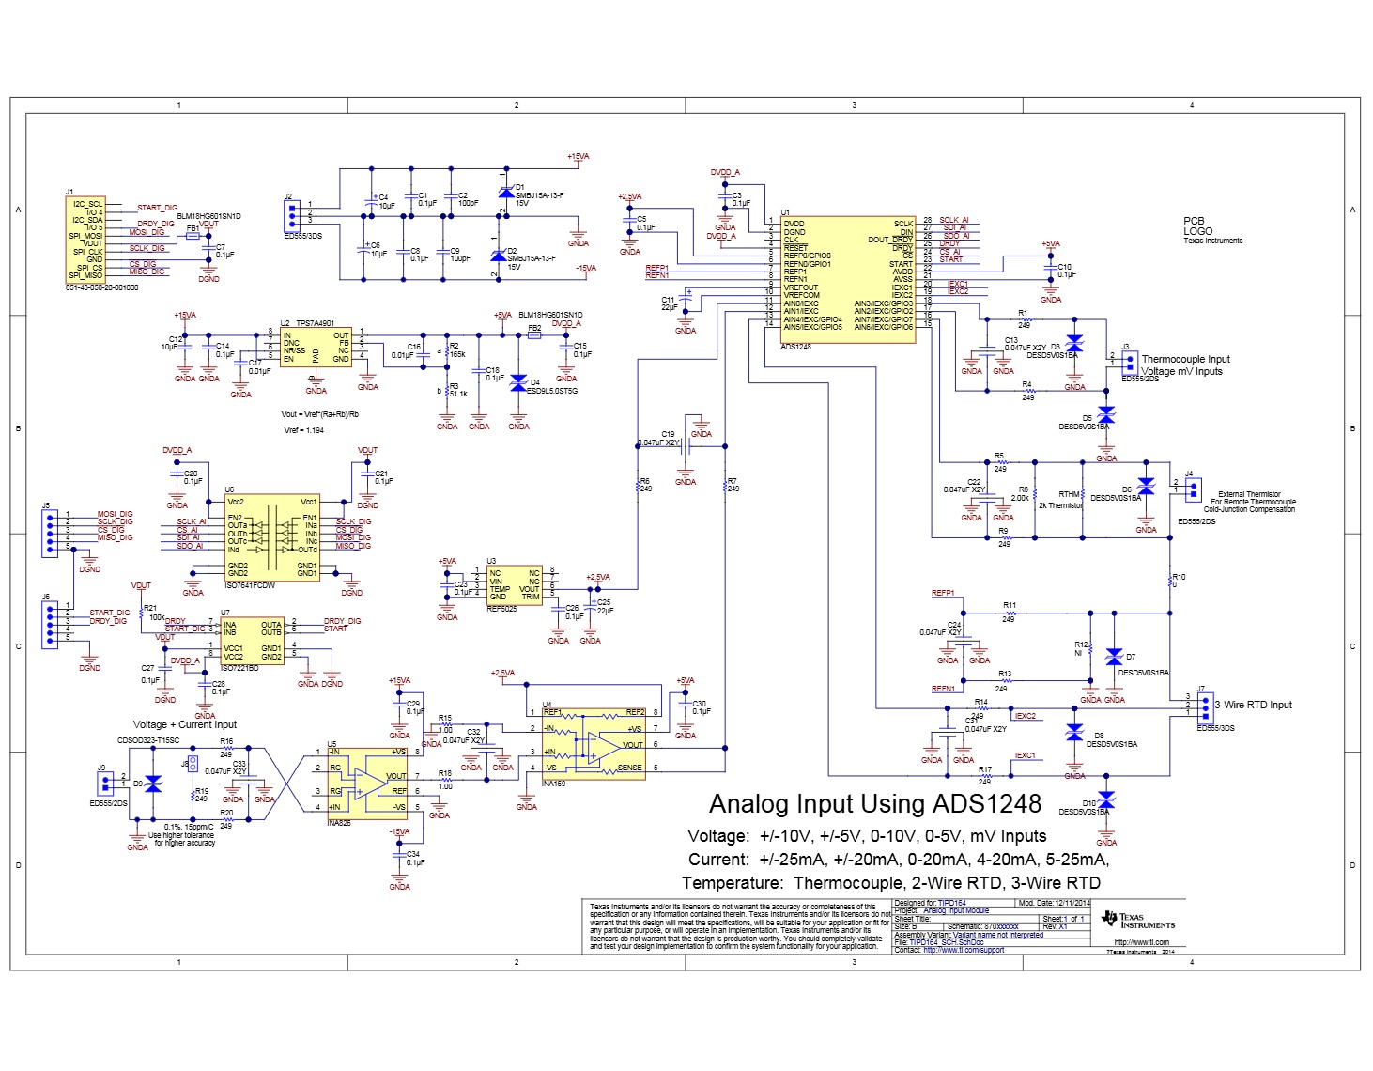
Docs/page-1.jpg
