Morfey1974/HVAC_CleanRoom_Project/Docs/PLC modul block schema.jpg

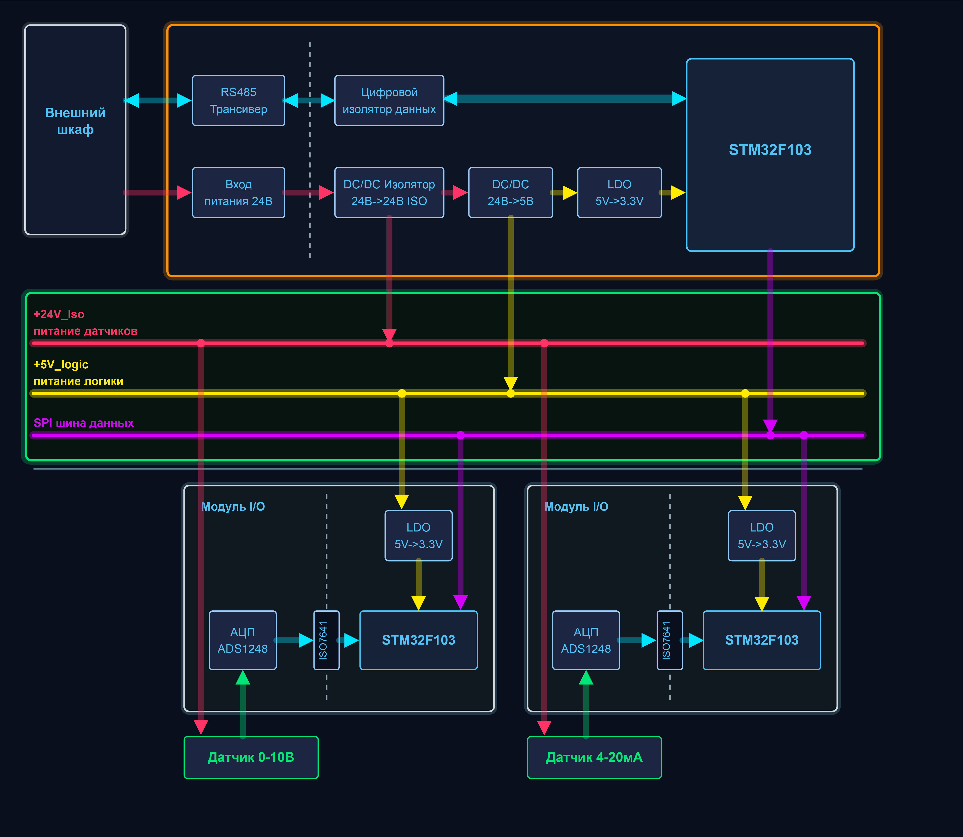
Docs/PLC modul block schema.jpg
