Morfey1974/HVAC_CleanRoom_Project/Docs/RTC_FRTC8900S_schematic.png

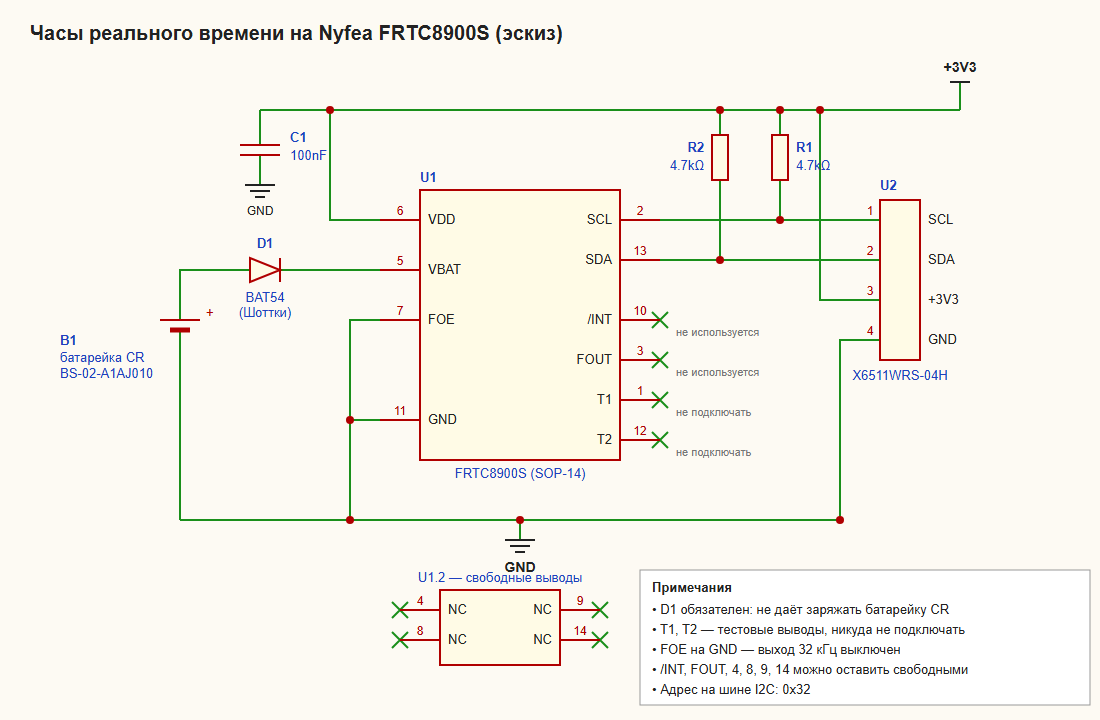
Docs/RTC_FRTC8900S_schematic.png
