Morfey1974/HVAC_CleanRoom_Project/Docs/SCH_Plata STM32H723 for display 4.3 TFT.png

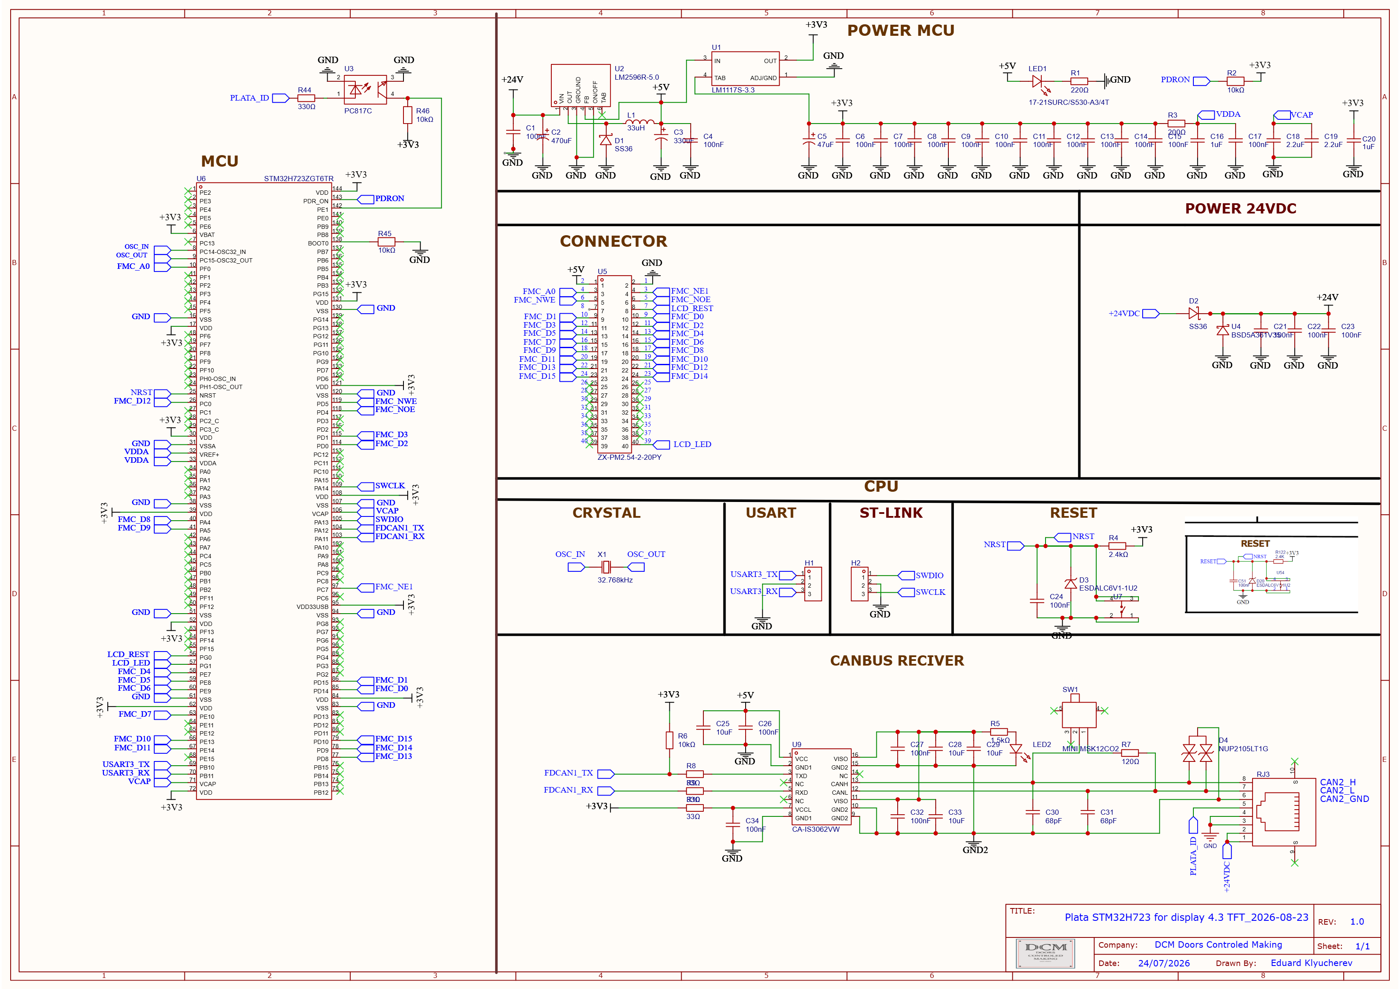
Docs/SCH_Plata STM32H723 for display 4.3 TFT.png
