Morfey1974/HVAC_CleanRoom_Project/Docs/SCH_SCH_HUB_Displays_TFT4.3_1-P_1_2026-08-25.png

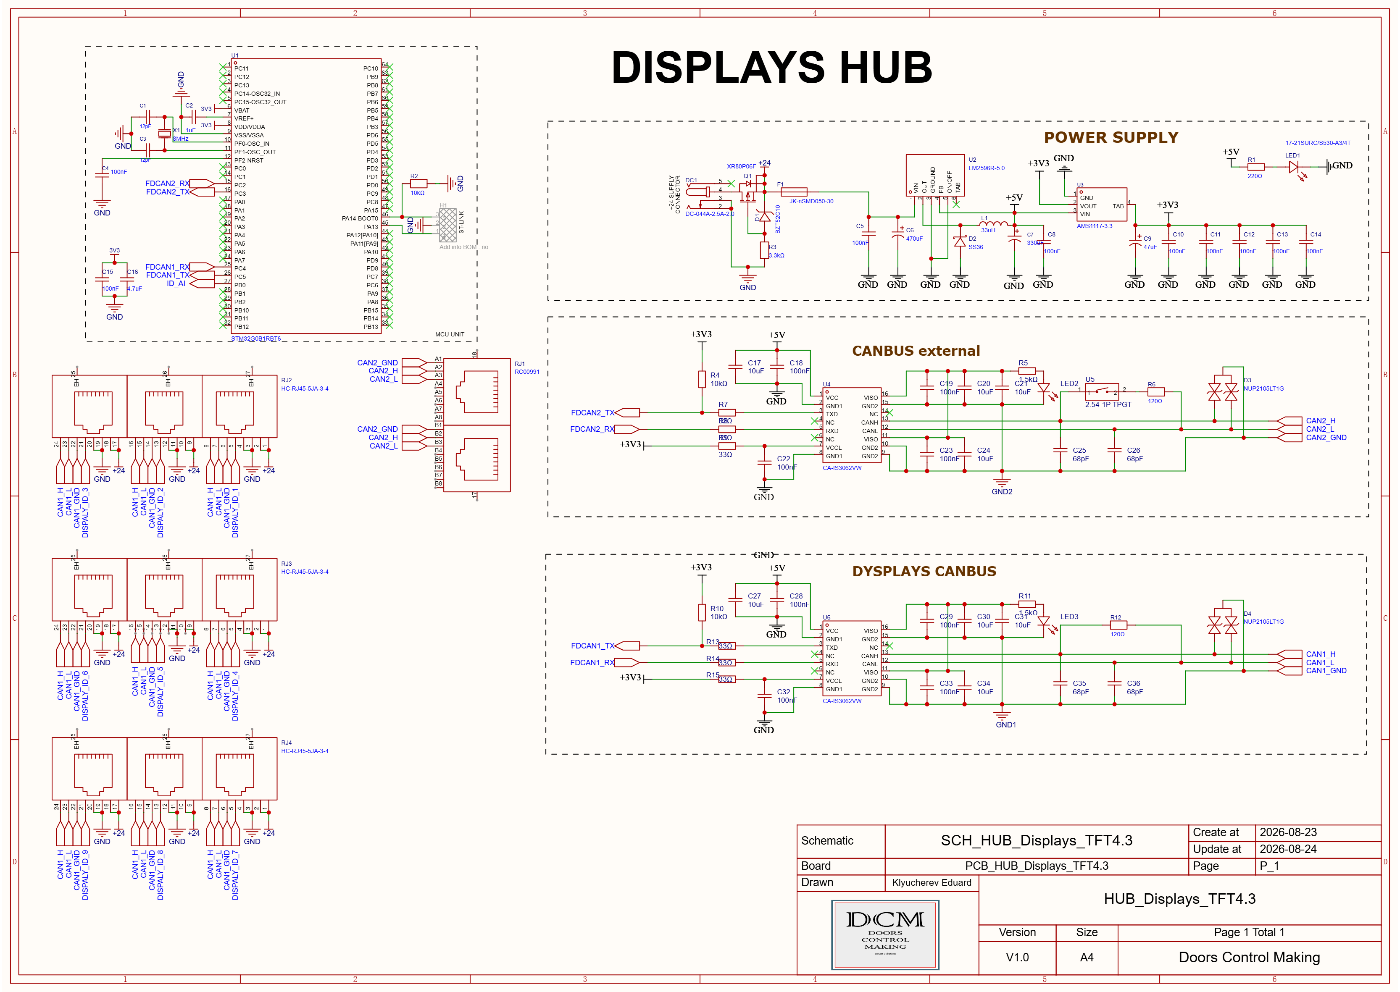
Docs/SCH_SCH_HUB_Displays_TFT4.3_1-P_1_2026-08-25.png
