Morfey1974/HVAC_CleanRoom_Project/Docs/SCH_Schema_Modul_AI_1-P1_2026-08-16.png

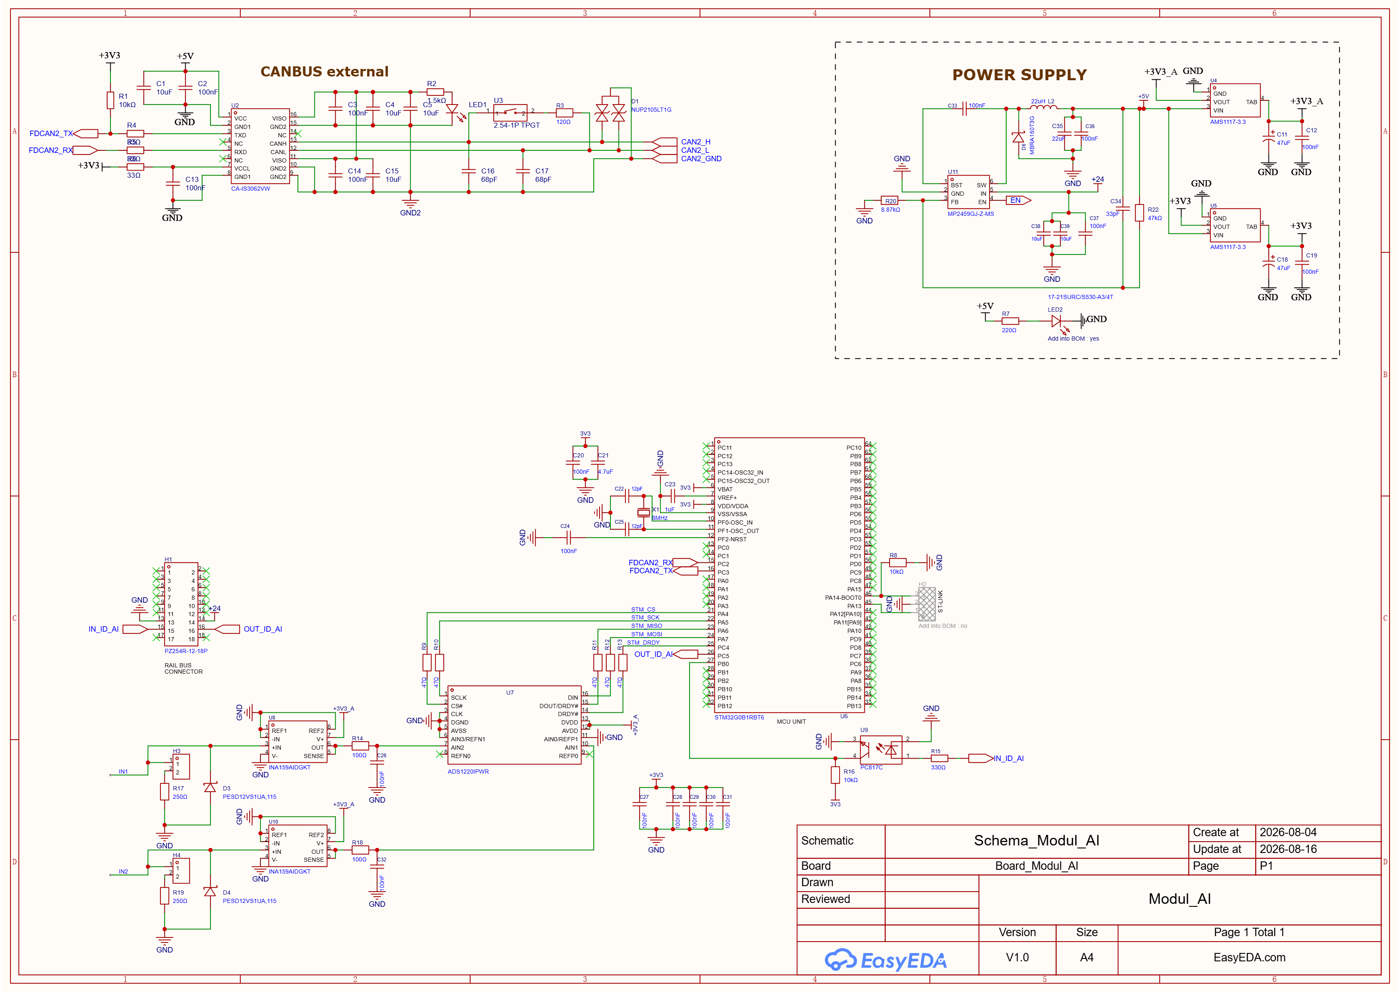
Docs/SCH_Schema_Modul_AI_1-P1_2026-08-16.png
