Morfey1974/HVAC_CleanRoom_Project/Docs/SCH_Schematic1_1-P1_2026-08-02.png

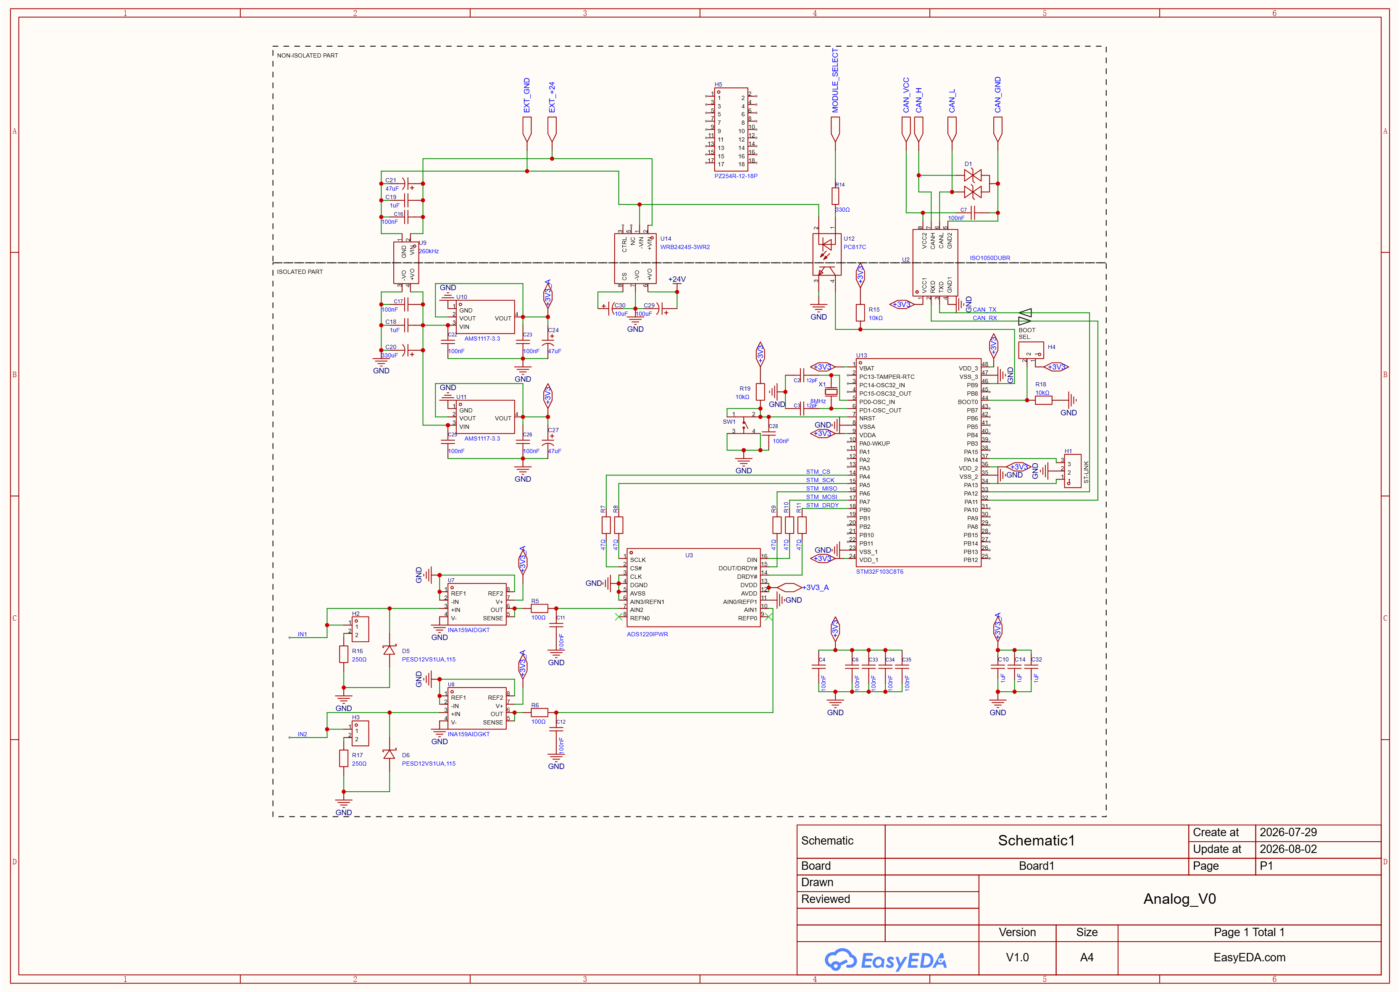
Docs/SCH_Schematic1_1-P1_2026-08-02.png
