Morfey1974/HVAC_CleanRoom_Project/Docs/Schematic_Схема-HVAC_2026-07-08.png

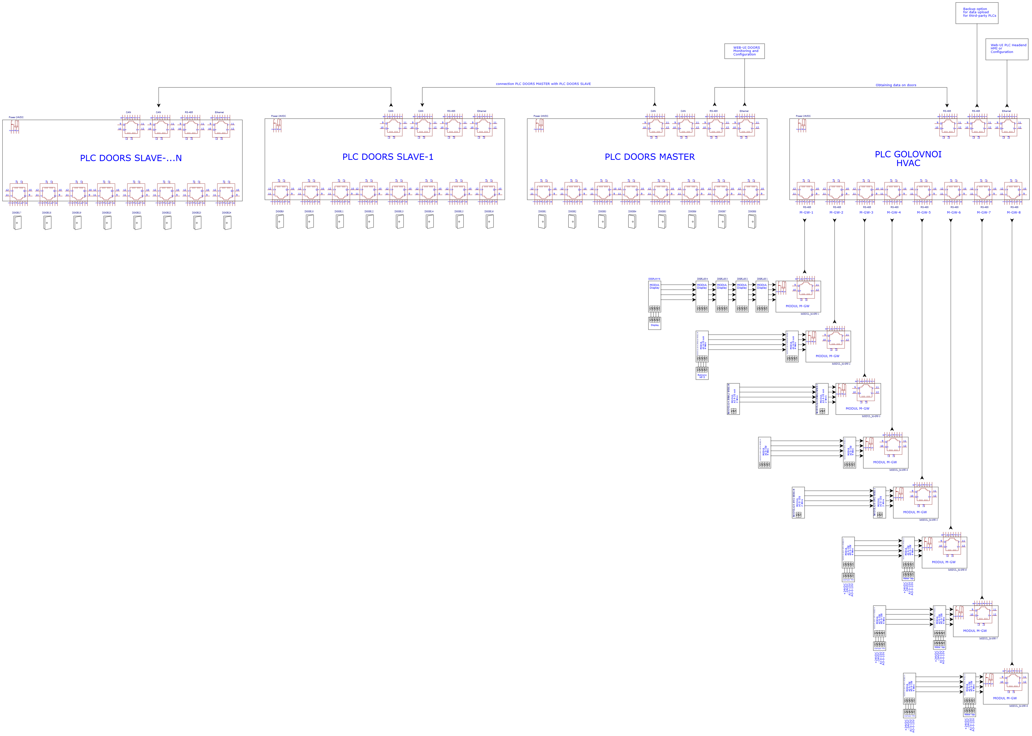
Docs/Schematic_Схема-HVAC_2026-07-08.png
