Morfey1974/HVAC_CleanRoom_Project/Docs/Shema PLC-Modules.png

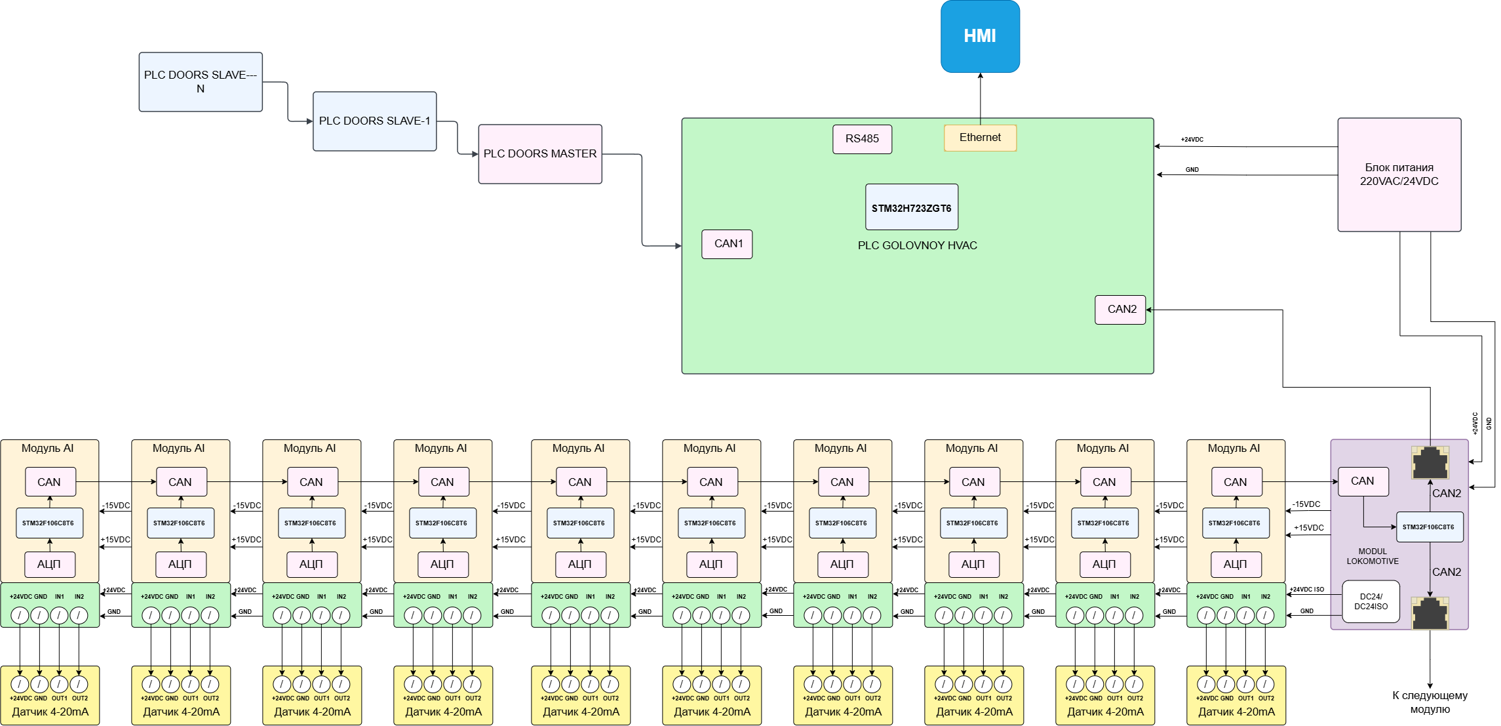
Docs/Shema PLC-Modules.png
