Morfey1974/HVAC_CleanRoom_Project/Firmware_Displays/Display_TFT10.1_HMI/Application/Core/Src/ahu_snap.png

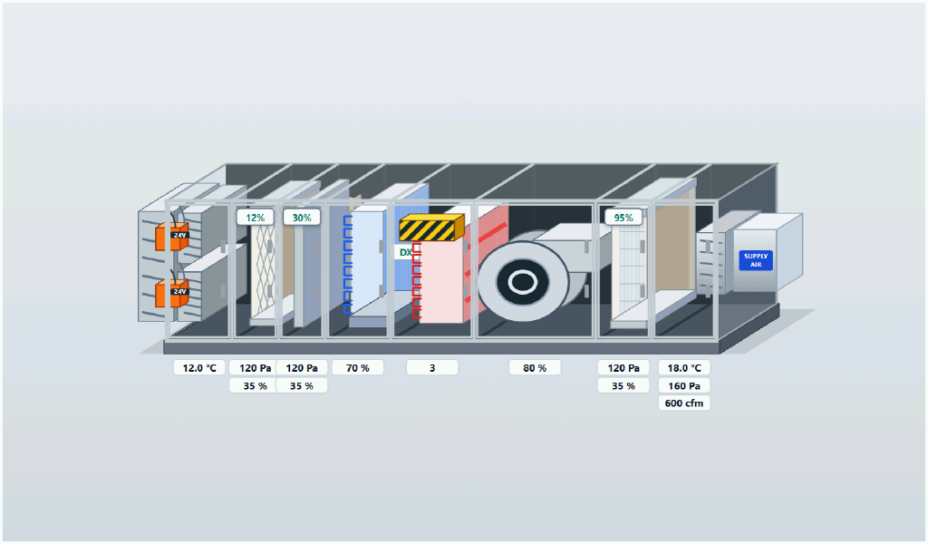
Firmware_Displays/Display_TFT10.1_HMI/Application/Core/Src/ahu_snap.png
