Morfey1974/HVAC_CleanRoom_Project/Firmware_Displays/Display_TFT10.1_HMI/Application/Tools/fan_crop.png

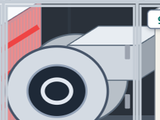
Firmware_Displays/Display_TFT10.1_HMI/Application/Tools/fan_crop.png
