Morfey1974/HVAC_CleanRoom_Project/Docs/Analog Devices/Output/CN0321-DesignSupport/CN0321-DesignSupport/EVAL-CN0321-SDPZ_BOM_Rev0.xlsx

Analog Bill Of Materials for EV-IND-OUT-002SDZ_A.pcb on 1/16/2013 5:05:12 PM
Name | Part Description | Value | Tolerance | PCB Decal | SMD | Layer Name | PART DESC | MFG #1 | Part Number | STOCK CODE
C1 | CAP | 3.9nF | 5% | C0603 | Yes | Top | 100V C0G Ceramic Capacitor | Kemet | C0603C392J1GACTU | FEC 1865513
C2 | CAP | 100nF | 10% | C0603 | Yes | Top | 50V X7R Ceramic Capacitor | MURATA | GRM188R71H104KA93D | FEC 8820023
C3 | CAP | DNI |  | C0603 | Yes | Top |  |  |  | Not Inserted
C4 | CAP | 100nF | 10% | C0603 | Yes | Top | 50V X7R Ceramic Capacitor | MURATA | GRM188R71H104KA93D | FEC 8820023
C5 | CAP+ | 10uF | 10% | RTAJ_C | Yes | Top | Tantalum Capacitor, 10UF, 35V | KEMET | T491C106K035AT | FEC 1457464
C6 | CAP+ | 10uF | 10% | RTAJ_C | Yes | Top | Tantalum Capacitor, 10UF, 35V | KEMET | T491C106K035AT | FEC 1457464
C7 | CAP | 100nF | 10% | C0603 | Yes | Top | 50V X7R Ceramic Capacitor | MURATA | GRM188R71H104KA93D | FEC 8820023
C8 | CAP | 100nF | 10% | C0603 | Yes | Top | 50V X7R Ceramic Capacitor | MURATA | GRM188R71H104KA93D | FEC 8820023
C9 | CAP0603_NI | DNI |  | C0603 | Yes | Top |  |  |  | Not Inserted
C10 | 7_5MM_330PF_3KV | DNI |  | CAP-7.5MM | No | Top | 150pF, 3kV |  |  | PADs to be kept free of solder
C11 | C0603_NP | 330pF |  | 603 | Yes | Top | 50V X7R Ceramic Capacitor | KEMET | C0603C331J5GAC | FEC 2070417
C12 | 7_5MM_330PF_3KV | DNI |  | CAP-7.5MM | No | Top | 150pF, 3kV |  |  | PADs to be kept free of solder
C13 | C0603_0.1UF50V_GRM188R71E104KA01D_MURATA | 100nF | 10% | 603 | Yes | Top | 50V X7R Ceramic Capacitor | MURATA | GRM188R71H104KA93D | FEC 8820023
C14 | CAP+ | 47uF |  | CAP\TAJ_D | Yes | Top | Tantalum Capacitor, 47UF, 35V | KEMET | T495X476K035ATE200 | FEC 1702715
C15 | C0603_0.1UF50V_GRM188R71E104KA01D_MURATA | 100nF | 10% | 603 | Yes | Top | 50V X7R Ceramic Capacitor | MURATA | GRM188R71H104KA93D | FEC 8820023
C16 | CAP | 100pF |  | 1206 | Yes | Top | 2000V, X7R Ceramic Capacitor | MULTICOMP | 1206GC101KAT2A | FEC 1301848
C17 | C0603_NP | 330pF |  | 603 | Yes | Top | 50V X7R Ceramic Capacitor | KEMET | C0603C331J5GAC | FEC 2070417
C18 | C1210_47UF_10V_GRM32ER71A476KE15L_MURATA | 47uF |  | 1210 | Yes | Top | Tantalum Capacitor, 47UF, 10V | MURATA | GRM32ER71A476KE15L | FEC 1797018
C19 | CAP+ | 10uF | 10% | RTAJ_A | Yes | Top | Tantalum Capacitor, 10UF, 10V | KEMET | T491A106K010AT | FEC 1457413RL
C20 | CAP+ | 47uF |  | CAP\TAJ_D | Yes | Top | Tantalum Capacitor, 47UF, 35V | KEMET | T495X476K035ATE200 | FEC 1702715
C21 | CAP | 10uF |  | 1206 | Yes | Top | 25V X6S Ceramic Capacitor | MURATA | GRM31CC8YA106KA12L | FEC 1889298RL
C22 | CAP | 1nF | 10% | C0603 | Yes | Top | 100V X7R Ceramic Capacitor | AVX | 06031C102K4Z2A | FEC 130 1714
C23 | CAP | 1nF | 10% | C0603 | Yes | Top | 100V X7R Ceramic Capacitor | AVX | 06031C102K4Z2A | FEC 130 1714
C24 | CAP | 100pF |  | 1206 | Yes | Top | 2000V, X7R Ceramic Capacitor | MULTICOMP | 1206GC101KAT2A | FEC 1301848
C25 | CAP | 2.2nF | ±10% | C0603 | Yes | Top | 50V X7R Ceramic Capacitor | TDK | C1608X7R2A222K | FEC 1907321
C27 | CAP | 10uF |  | 1206 | Yes | Top | 25V X6S Ceramic Capacitor | MURATA | GRM31CC8YA106KA12L | FEC 1889298RL
C28 | CAP | DNI |  | C0603 | Yes | Top |  |  |  | Not Inserted
C29 | CAP | 100nF | 10% | C0603 | Yes | Top | 50V X7R Ceramic Capacitor | MURATA | GRM188R71H104KA93D | FEC 8820023
C30 | CAP | 100nF | 10% | C0603 | Yes | Top | 50V X7R Ceramic Capacitor | MURATA | GRM188R71H104KA93D | FEC 8820023
C31 | C0603_0.1UF50V_GRM188R71E104KA01D_MURATA | 100nF | 10% | 603 | Yes | Top | 50V X7R Ceramic Capacitor | MURATA | GRM188R71E104KA01D | FEC 8820023
C32 | CAP | DNI |  | C0603 | Yes | Top |  |  |  | Not Inserted
C33 | CAP | 100nF | 10% | C0603 | Yes | Top | 50V X7R Ceramic Capacitor | MURATA | GRM188R71H104KA93D | FEC 8820023
C34 | CAP | 100nF | 10% | C0603 | Yes | Top | 50V X7R Ceramic Capacitor | MURATA | GRM188R71H104KA93D | FEC 8820023
C35 | CAP | 10uF |  | C0805 | Yes | Top | 10V X7R Ceramic Capacitor | AVX | 0805ZC106KAT2A | FEC 2094042
C36 | CAP | DNI | 10% | C0603 | Yes | Top | 2.2uF, Capacitor ceramic, 35V, X5R | TDK | C1608X5R1V225K (FEC 2211185RL) | Not Inserted
C37 | CAP | 10uF |  | C0805 | Yes | Top | 10V X7R Ceramic Capacitor | AVX | 0805ZC106KAT2A | FEC 2094042
C38 | CAP+ | 10uF | 10% | RTAJ_C | Yes | Top | Tantalum Capacitor, 10UF, 35V | KEMET | T491C106K035AT | FEC 1457464
C39 | CAP+ | 10uF | 10% | RTAJ_A | Yes | Top | Tantalum Capacitor, 10UF, 10V | KEMET | T491A106K010AT | FEC 1457413RL
C40 | CAP | 100nF | 10% | C0603 | Yes | Top | 50V X7R Ceramic Capacitor | MURATA | GRM188R71H104KA93D | FEC 8820023
C41 | CAP | 100nF | 10% | C0603 | Yes | Top | 50V X7R Ceramic Capacitor | MURATA | GRM188R71H104KA93D | FEC 8820023
C42 | CAP | 10uF |  | C0805 | Yes | Top | 10V X7R Ceramic Capacitor | AVX | 0805ZC106KAT2A | FEC 2094042
C43 | CAP | 100nF | 10% | C0603 | Yes | Top | 50V X7R Ceramic Capacitor | MURATA | GRM188R71H104KA93D | FEC 8820023
C44 | CAP | 10uF |  | C0805 | Yes | Top | 10V X7R Ceramic Capacitor | AVX | 0805ZC106KAT2A | FEC 2094042
C45 | CAP | 300PF | ± 5% | C0603 | Yes | Top | 50V C0G Ceramic Capacitor | Murata | GRM1885C1H301JA01D | Digikey 490-1438-1-ND
C46 | CAP | 150pF | ± 5% | C0603 | Yes | Top | 100V C0G Ceramic Capacitor | AXA | 06031A151JAT2A | FEC 1740606
C47 | CAP | 100nF | 10% | C0603 | Yes | Top | 50V X7R Ceramic Capacitor | MURATA | GRM188R71H104KA93D | FEC 8820023
C48 | CAP | 470nF | 10% | 805 | Yes | Top | 50V X7R Ceramic Capacitor | Taiyo Yuden | UMK212B7474KG-T | FEC 2112758
C49 | CAP | 470nF | 10% | 805 | Yes | Top | 50V X7R Ceramic Capacitor | Taiyo Yuden | UMK212B7474KG-T | FEC 2112758
C52 | CAP | 22nF | ±10% | C0603 | Yes | Top | 50V X7R Ceramic Capacitor | TDK | MC0603B223M500CT | FEC 1907316RL
C53 | CAP | 2.2uF | ±10% | 1206 | Yes | Top | 50V X7R Ceramic Capacitor | MURATA | GRM31CR71H225KA88L | FEC 1797017RL
C68 | CAP | 1uF | ±15% | C0603 | Yes | Top | 16V X7R Ceramic Capacitor | Murata | C0603C105K4RACTU | FEC 1828826
C69 | CAP | 1uF | ±15% | C0603 | Yes | Top | 16V X7R Ceramic Capacitor | Murata | C0603C105K4RACTU | FEC 1828826
C77 | CAP | DNI | 10% | C0603 | Yes | Top | 2.2uF, Capacitor ceramic, 35V, X5R | TDK | C1608X5R1V225K (FEC 2211185RL) | Not Inserted
C78 | CAP+5MM | 330uF | 20% | CAP_ELEK_5MM | No | Top | Aluminum Electrolytic Capacitors, 330uF, 50V | PANASONIC | ECA1HHG331 | FEC 9692983
C79 | CAP | 100nF | 10% | C0603 | Yes | Top | 50V X7R Ceramic Capacitor | MURATA | GRM188R71H104KA93D | FEC 8820023
C80 | CAP | 100nF | 10% | C0603 | Yes | Top | 50V X7R Ceramic Capacitor | MURATA | GRM188R71H104KA93D | FEC 8820023
C81 | CAP | 10nF | 10% | C0603 | Yes | Bottom | 50V X7R Ceramic Capacitor | AVX | 06035C103K4Z2A | FEC 1833842
C82 | CAP | 10nF | 10% | C0603 | Yes | Top | 50V X7R Ceramic Capacitor | AVX | 06035C103K4Z2A | FEC 1833842
C83 | CAP | 100nF | 10% | C0805 | Yes | Top | 50V X7R Ceramic Capacitor | AVX | 06035C103K4Z2A | FEC 1301717
C85 | CAP | 10uF | 10% | 1206 | Yes | Top | 50V X5R Ceramic Capacitor | MURATA | GRM31CR61H106KA12L | FEC 1845762RL
C86 | CAP | 22uF | 10% | 1210 | Yes | Top | 25V X7R Ceramic Capacitor | MURATA | GRM32ER71E226KE15L | FEC 1797019
C87 | CAP | 10uF | 10% | 1210 | Yes | Top | 25V X7R Ceramic Capacitor | MURATA | GRM32DR71E106KA12L | FEC 1828840
C88 | CAP | 180pF | 10% | C0603 | Yes | Top | 50V X7R Ceramic Capacitor | YAGEO | CC0603KRX7R9BB181 | FEC 3019615RL
C104 | CAP | 15nF | ±10pct 275V | CAP\MR04 | No | Top | 275V X7R Ceramic Capacitor | AVX | SR211C153KTR | FEC 1100526
C105 | CAP | 15nF | ±10pct 275V | CAP\MR04 | No | Top | 275V X7R Ceramic Capacitor | AVX | SR211C153KTR | FEC 1100526
C107 | CAP | 15nF | ±10pct 275V | CAP\MR04 | No | Top | 275V X7R Ceramic Capacitor | AVX | SR211C153KTR | FEC 1100526
D1 | SCHOTTKY_MBR0540-TP_0.5A_ONSEMI | MBR0540-TP |  | SOD-123 | Yes | Top | SCHOTTKY Diode, 0.5A, 40V | ON Semi | MBR0540T1G | FEC 9556923
D2 | SCHOTTKY_MBR0540-TP_0.5A_ONSEMI | MBR0540-TP |  | SOD-123 | Yes | Top | SCHOTTKY Diode, 0.5A, 40V | ON Semi | MBR0540T1G | FEC 9556923
D3 | LED |  |  | LED_R0805-RED | Yes | Top | Red SMD LED | Avago | HSMH-C170 | FEC 5790840
D4 | DIODE-SMCJ60CA | 26V Stand-Off |  | DO-214AA | Yes | Top | TVS Diode, 30.4Vbr, 600W | STMICROELECTRONICS | SMBJ26CA | FEC 1749366RL
D5 | DIODE-SMCJ60CA | 26V Stand-Off |  | DO-214AA | Yes | Top | TVS Diode, 30.4Vbr, 600W | STMICROELECTRONICS | SMBJ26CA | FEC 1749366RL
D6 | DIODE-BAV199LT1G |  |  | SOT23 | Yes | Top | DUAL-DIODE, SCHOTTKY, 70V, SOT-23 | STMICROELECTRONICS | BAS70-04FILM | FEC 9801405
D7 | DIODE-BAV199LT1G |  |  | SOT23 | Yes | Top | DUAL-DIODE, SCHOTTKY, 70V, SOT-23 | STMICROELECTRONICS | BAS70-04FILM | FEC 9801405
D8 | DIODE-BAV199LT1G |  |  | SOT23 | Yes | Top | BAS70-04FILM; DUAL-DIODE, SCHOTTKY, 70V, SOT-23 | STMICROELECTRONICS | BAS70-04FILM | FEC 9801405
D9 | DIODE-BAV199LT1G | DNI |  | SOT23 | Yes | Top | DUAL-DIODE, SCHOTTKY, 70V, SOT-23 | STMICROELECTRONICS | BAS70-04FILM | Not Inserted
D10 | ZENER-SOD-123 | 25V |  | SOD-123 | Yes | Top | 25V ZENER, SOD123 | FAIRCHILD SEMICONDUCTOR | MMSZ5253B | FEC 1700857RL
D11 | LED |  |  | LED_R0805-RED | Yes | Top | Green SMD LED | Avago | HSMG-C170 | FEC 5790852
D13 | SCHOTTKY_MBR0540-TP_0.5A_ONSEMI | MBR0540-TP |  | SOD-123 | Yes | Top | SCHOTTKY Diode, 0.5A, 40V | ON Semi | MBR0540T1G | FEC 9556923
D14 | SCHOTTKY_MBR0540-TP_0.5A_ONSEMI | MBR0540-TP |  | SOD-123 | Yes | Top | SCHOTTKY Diode, 0.5A, 40V | ON Semi | MBR0540T1G | FEC 9556923
D43 | DIODE |  |  | MELF1 | Yes | Top | GENERIC DIODE W ALTERNATE | FAIRCHILD SEMICONDUCTOR | S1M | FEC 9843841
EN1 | TESTPOINTS | DNI |  | TESTPOINT-SMALL | No | Top | Test point, not inserted, keep hole clear of solder | n/a | n/a | Do Not Insert. Keep clear of solder.
J1 | CON/POWER3_3.81MM_HEADER+PLUG |  |  | CON\POWER3(3_81PITCH) | No | Top | Header, R/A, 3.81MM, 2WAY (Add PLUG also) | Phoenix Contact | MC 1,5/ 3-G-3,81and IMP PRECISION CONTROLS - plug | FEC 3704737and FEC 9632743
J2 | CON/POWER3_3.81MM_HEADER+PLUG |  |  | CON\POWER3(3_81PITCH) | No | Top | Header, R/A, 3.81MM, 2WAY (Add PLUG also) | Phoenix Contact | MC 1,5/ 3-G-3,81and IMP PRECISION CONTROLS - plug | FEC 3704737and FEC 9632743
J3 | SDP-STANDARD-CONN |  |  | CON-120/FX8-120S-SV | No | Top | 120-way connector, 0.6mm pitch | Hirose | FX8-120S-SV(21) | FEC 1324660
J4 | CON/POWER3_3.81MM_HEADER+PLUG | DNI |  | CON\POWER3(3_81PITCH) | No | Top | Header, R/A, 3.81MM, 2WAY (Add PLUG also) | Phoenix Contact | MC 1,5/ 3-G-3,81and IMP PRECISION CONTROLS - plug | Not Inserted
J6 | CON_HEADER_PMOD | PMOD Connector |  | HEADER12 | No | Top | Standard dual-row header (6*2 pins)
L1 | TRAN_64UH_JA4631-BL_COILCRAFT | KA4976-AL |  | COILCRAFT_KA4976-AL | Yes | Top | Transformer, 64uH, 1:5 turns ratio | Coilcraft | KA4976-AL | Coilcraft
L2 | IND | 600ohm |  | 805 | Yes | Top | Ferrite Bead | WUERTH ELEKTRONIK | 74279204 | FEC 163 5719
L3 | IND | 600ohm |  | 805 | Yes | Top | Ferrite Bead | WUERTH ELEKTRONIK | 74279204 | FEC 163 5719
L4 | INDUCTOR_47UH_LQH3NPN470MM0_MURATA | 47uH | ±20% | IND5 | Yes | Top | 47uH, INDUCTOR | Murata | LQH32CN470K23L | FEC 952-2212
L11 | INDUCTOR_47UH_LQH3NPN470MM0_MURATA | 47uH | ±20% | IND5 | Yes | Top | 47uH, INDUCTOR | Murata | LQH32CN470K23L | FEC 952-2212
L12 | IND-SLF7045T-220M1R3-H | 18µH | ±20% | IND-SLF7045T | Yes | Top | 18uH 1,45A 20% | WURTH ELEKTRONIK | 744774118 | FEC 2082625
L13 | IND | 280mA 2R1 | ±10% | IND | No | Top | INDUCTOR CHOKE 1MH | PANASONIC | ELC09D102F | FEC 8094772
L14 | IND | 280mA 2R1 | ±10% | IND | No | Top | INDUCTOR CHOKE 1MH | PANASONIC | ELC09D102F | FEC 8094772
L19 | IND | 600ohm |  | 1206 | Yes | Top | Ferrite Bead | VISHAY DALE | ILB1206ER601V | FEC 1651733
PGOOD | TESTPOINT | DNI |  | TESTPOINT | No | Top | Testpoint | Vero |  | Not Inserted
PTC-1 | MULTIFUSE_R13_P5MM_1.1A |  |  | MULTIFUSE_RADIAL_1.1A | No | Top | RES-VARI PTC | BOURNS | MF-RX110/72-0 | FEC 9350128
Q1 | PBSS8110Z | DNI |  | SOT223 | Yes | Top | General Purpose NPN Transistor | Philips | PBSS8110Z (FEC-8736677) | Not Inserted
R1 | RES | 10k | 1% | R0603 | Yes | Top | 10k, SMD Resistor | VISHAY DRALORIC | CRCW060310K0FKEA | FEC 1469748
R1-PIEZO | RES-VARISTOR2.3J_RADIAL |  |  | 2.5J_35VAC_5MMPITCH | No | Top | RES-VARISTOR 2.3J RADIAL | LITTELFUSE | V56ZA3P | FEC 1057174
R2 | RES | 0R |  | 603 | Yes | Top | 0R, SMD Resistor | Multicomp | MC 0.063W 0603 0R | FEC 9331662
R2-PIEZO | RES-VARISTOR2.3J_RADIAL |  |  | 2.5J_35VAC_5MMPITCH | No | Top | RES-VARISTOR 2.3J RADIAL | LITTELFUSE | V56ZA3P | FEC 1057174
R3 | RES | 10k | 1% | 603 | Yes | Top | 10k, SMD Resistor | VISHAY DRALORIC | CRCW060310K0FKEA | FEC 1469748
R3-PIEZO | RES-VARISTOR2.3J_RADIAL |  |  | 2.5J_35VAC_5MMPITCH | No | Top | RES-VARISTOR 2.3J RADIAL | LITTELFUSE | V56ZA3P | FEC 1057174
R4 | RES | DNI |  | R0603 | Yes | Top | 0R, SMD Resistor | Multicomp | MC 0.063W 0603 0R | Not Inserted
R4-PIEZO | RES-VARISTOR2.3J_RADIAL |  |  | 2.5J_35VAC_5MMPITCH | No | Top | RES-VARISTOR 2.3J RADIAL | LITTELFUSE | V56ZA3P | FEC 1057174
R5 | RES | 0R |  | R0603 | Yes | Top | 0R, SMD Resistor | Multicomp | MC 0.063W 0603 0R | FEC 9331662
R6 | R0603_100K_1%_ERJ-3EKF1003V_PANASONIC | 100k | 1% | 603 | Yes | Top | 100k, SMD Resistor | Multicomp | MC 0.063W 0603 1% 100K | FEC 9330402
R7 | RES | 100k | 1% | R0603 | Yes | Top | 100k, SMD Resistor | Multicomp | MC 0.063W 0603 1% 100K | FEC 9330402
R8 | RES | 100k | 1% | R0603 | Yes | Top | 100k, SMD Resistor | Multicomp | MC 0.063W 0603 1% 100K | FEC 9330402
R9 | R0603_0R_5%_ERJ-3GEY0R00V_PANASONIC | 0R |  | 603 | Yes | Top | 0R, SMD Resistor | Multicomp | MC 0.063W 0603 0R | FEC 9331662
R10 | RES | 1k | 1% | R0603 | Yes | Top | 1k, SMD Resistor | Multicomp | MC 0.063W 0603 1% 1K | FEC 9330380
R11 | RES_DUAL_FOOTPRINT | DNI | 0.1%, 5ppm/°C | 0805_THRU-HOLE | No | Top | 15kohm, SMD Resistor (Precision) | welwyn | PCF0805-13-15K-B-T1. | Not Inserted
R12 | RES | DNI |  | R0603 | Yes | Top |  |  |  | Not Inserted
R13 | RES | 18R | ±1% | R0805 | Yes | Top | 18R, SMD Resistor, 330mW | VISHAY DRALORIC | CRCW080518R0FKEAHP | FEC 1738935RL
R14 | RES | 100R | 1% | R0603 | Yes | Top | 100R, SMD Resistor, 250mW | VISHAY DRALORIC | CRCW0805100RFKEAHP | FEC 1738946RL
R15 | RES | 0R |  | R0603 | Yes | Top | 0R, SMD Resistor | Multicomp | MC 0.063W 0603 0R | FEC 9331662
R16 | R0603_10K_5%_ERJ-3GEYJ103V_PANASONIC | 10k | 1% | 603 | Yes | Top | 10k, SMD Resistor | VISHAY DRALORIC | CRCW060310K0FKEA | FEC 1469748
R17 | RES | 0R |  | R0603 | Yes | Top | 0R, SMD Resistor | Multicomp | MC 0.063W 0603 0R | FEC 9331662
R18 | RES | 1.2M | 1% | R0603 | Yes | Top | 1.2M, SMD Resistor | Multicomp | MCHP03W8F1204T5E | FEC 1576326RL
R19 | RES | 1.2M | 1% | R0603 | Yes | Top | 1.2M, SMD Resistor | Multicomp | MCHP03W8F1204T5E | FEC 1576326RL
R20 | RES | DNI |  | R0603 | Yes | Top |  |  |  | Not Inserted
R21 | RES | DNI |  | R0603 | Yes | Top | 0R, SMD Resistor | Multicomp | MC 0.063W 0603 0R | Not Inserted
R22 | RES | 0R |  | R0603 | Yes | Top | 0R, SMD Resistor | Multicomp | MC 0.063W 0603 0R | Not Inserted
R23 | RES | DNI |  | R0603 | Yes | Top | 0R, SMD Resistor | Multicomp | MC 0.063W 0603 0R | FEC 9331662
R24 | RES | DNI |  | R0603 | Yes | Top | 0R, SMD Resistor | Multicomp | MC 0.063W 0603 0R | Not Inserted
R25 | RES | 0R |  | R0603 | Yes | Top | 0R, SMD Resistor | Multicomp | MC 0.063W 0603 0R | FEC 9331662
R26 | RES | 22R | 1% | R0603 | Yes | Top | 22R, SMD restistor | PANASONIC | ERJP03F22R0V | FEC 1750650RL
R27 | RES | 22R | 1% | R0603 | Yes | Top | 22R, SMD restistor | PANASONIC | ERJP03F22R0V | FEC 1750650RL
R28 | RES | 0R |  | 603 | Yes | Top | 0R, SMD Resistor | Multicomp | MC 0.063W 0603 0R | FEC 9331662
R29 | RES | DNI |  | R0603 | Yes | Top | 0R, SMD Resistor | Multicomp | MC 0.063W 0603 0R | Not Inserted
R30 | RES | 499R |  | R0603 | Yes | Top | 499R, SMD Resistor | MULTICOMP | MC 0.063W 0603 1% 499R | FEC 1170758
R31 | R0603_1%_NP | 14.7ohm | 1% | 603 | Yes | Top | 15.7R, SMD Resistor | MULTICOMP | MC 0.063W 0603 1% 14R7 | FEC 1170607
R32 | R0603_1%_NP | 14.7ohm | 1% | 603 | Yes | Top | 15.7R, SMD Resistor | MULTICOMP | MC 0.063W 0603 1% 14R7 | FEC 1170607
R33 | R0603_11K3_1%_ERJ-3EKF1132V_PANASONIC | 8.06kohm | 1% | 603 | Yes | Top | 8.06k, SMD Resistor | MULTICOMP | MC 0.063W 0603 1% 8K06 | FEC 1170881
R34 | R0603_34K_1%_CRCW060333R0FKEA_VASHAY | 93.1kohm | 1% | 603 | Yes | Top | 93.1k, SMD Resistor | MULTICOMP | MC 0.063W 0603 1% 93K1 | FEC 1170984RL
R35 | RES | 150k | 1% | R0603 | Yes | Top | 150k, SMD Resistor | MULTICOMP | MC 0.063W 0603 1% 150K | FEC 9330623RL
R36 | RES | 0R |  | R0603 | Yes | Top | 0R, SMD Resistor | Multicomp | MC 0.063W 0603 0R | FEC 9331662
R37 | RES | DNI |  | R0603 | Yes | Top | 10k, SMD Resistor, 250mW | VISHAY DRALORIC | CRCW060310K0FKEAHP (FEC 1738918RL) | Not Inserted
R38 | RES | DNI |  | R0603 | Yes | Top | 0R, SMD Resistor | Multicomp | MC 0.063W 0603 0R | Not Inserted
R39 | RES | 0R |  | R0603 | Yes | Top | 0R, SMD Resistor | Multicomp | MC 0.063W 0603 0R | FEC 9331662
R40 | RES | 0R |  | R0603 | Yes | Top | 0R, SMD Resistor | Multicomp | MC 0.063W 0603 0R | FEC 9331662
R41 | RES | 0R |  | R0603 | Yes | Top | 0R, SMD Resistor | Multicomp | MC 0.063W 0603 0R | FEC 9331662
R42 | RES | 0R |  | R0603 | Yes | Top | 0R, SMD Resistor | Multicomp | MC 0.063W 0603 0R | FEC 9331662
R43 | RES | 0R |  | R0603 | Yes | Top | 0R, SMD Resistor | Multicomp | MC 0.063W 0603 0R | FEC 9331662
R44 | RES | 0R |  | R0603 | Yes | Top | 0R, SMD Resistor | Multicomp | MC 0.063W 0603 0R | FEC 9331662
R45 | RES | DNI |  | R0603 | Yes | Top | 0R, SMD Resistor | Multicomp | MC 0.063W 0603 0R | Not Inserted
R46 | R0603_33_1%_CRCW060333R0FKEA_VASHAY | 33R | 1% | 603 | Yes | Top | 33ohm, SMD Resistor | VISHAY DRALORIC | CRCW060333R0FKEA | FEC 1469802
R47 | R0603_33_1%_CRCW060333R0FKEA_VASHAY | 33R | 1% | 603 | Yes | Top | 33ohm, SMD Resistor | VISHAY DRALORIC | CRCW060333R0FKEA | FEC 1469802
R48 | R0603_33_1%_CRCW060333R0FKEA_VASHAY | 33R | 1% | 603 | Yes | Top | 33ohm, SMD Resistor | VISHAY DRALORIC | CRCW060333R0FKEA | FEC 1469802
R49 | R0603_33_1%_CRCW060333R0FKEA_VASHAY | 33R | 1% | 603 | Yes | Top | 33ohm, SMD Resistor | VISHAY DRALORIC | CRCW060333R0FKEA | FEC 1469802
R50 | R0603_33_1%_CRCW060333R0FKEA_VASHAY | 33R | 1% | 603 | Yes | Top | 33ohm, SMD Resistor | VISHAY DRALORIC | CRCW060333R0FKEA | FEC 1469802
R51 | R0603_33_1%_CRCW060333R0FKEA_VASHAY | 33R | 1% | 603 | Yes | Top | 33ohm, SMD Resistor | VISHAY DRALORIC | CRCW060333R0FKEA | FEC 1469802
R52 | R0603_33_1%_CRCW060333R0FKEA_VASHAY | 33R | 1% | 603 | Yes | Top | 33ohm, SMD Resistor | VISHAY DRALORIC | CRCW060333R0FKEA | FEC 1469802
R53 | R0603_33_1%_CRCW060333R0FKEA_VASHAY | 33R | 1% | 603 | Yes | Top | 33ohm, SMD Resistor | VISHAY DRALORIC | CRCW060333R0FKEA | FEC 1469802
R54 | R0603_33_1%_CRCW060333R0FKEA_VASHAY | 33R | 1% | 603 | Yes | Top | 33ohm, SMD Resistor | VISHAY DRALORIC | CRCW060333R0FKEA | FEC 1469802
R55 | R0603_33_1%_CRCW060333R0FKEA_VASHAY | 33R | 1% | 603 | Yes | Top | 33ohm, SMD Resistor | VISHAY DRALORIC | CRCW060333R0FKEA | FEC 1469802
R56 | R0603_33_1%_CRCW060333R0FKEA_VASHAY | 33R | 1% | 603 | Yes | Top | 33ohm, SMD Resistor | VISHAY DRALORIC | CRCW060333R0FKEA | FEC 1469802
R57 | RES | DNI |  | R0603 | Yes | Top | 0R, SMD Resistor | Multicomp | MC 0.063W 0603 0R | Not Inserted
R58 | R0603_33_1%_CRCW060333R0FKEA_VASHAY | 33R | 1% | 603 | Yes | Top | 33ohm, SMD Resistor | VISHAY DRALORIC | CRCW060333R0FKEA | FEC 1469802
R59 | RES | DNI |  | R0603 | Yes | Top |  |  |  | Not Inserted
R60 | RES | DNI |  | R0603 | Yes | Top | 0R, SMD Resistor | Multicomp | MC 0.063W 0603 0R | Not Inserted
R61 | RES | DNI |  | R0603 | Yes | Top | 0R, SMD Resistor | Multicomp | MC 0.063W 0603 0R | Not Inserted
R63 | RES | 133K | 1% | R0603 | Yes | Top | 133k, SMD Resistor | VISHAY DALE | CRCW0603133KFKEA | FEC 1151687
R64 | RES | 118K | 1% | R0603 | Yes | Top | 118k, SMD Resistor | VISHAY DALE | CRCW0603118KFKEA | FEC 1151662
R68 | RES | 73.3k | 1% | R0603 | Yes | Top | 73.3k, SMD Resistor | PANASONIC | ERJ3EKF7322V | FEC 2059485
R69 | RES | 10k | 1% | R0603 | Yes | Top | 10k, SMD Resistor | VISHAY DRALORIC | CRCW060310K0FKEA | FEC 1469748
R91 | R0603_33_1%_CRCW060333R0FKEA_VASHAY | 33R | 1% | 603 | Yes | Top | 33ohm, SMD Resistor | VISHAY DRALORIC | CRCW060333R0FKEA | FEC 1469802
R92 | R0603_33_1%_CRCW060333R0FKEA_VASHAY | 33R | 1% | 603 | Yes | Top | 33ohm, SMD Resistor | VISHAY DRALORIC | CRCW060333R0FKEA | FEC 1469802
R93 | R0603_33_1%_CRCW060333R0FKEA_VASHAY | 33R | 1% | 603 | Yes | Top | 33ohm, SMD Resistor | VISHAY DRALORIC | CRCW060333R0FKEA | FEC 1469802
R94 | R0603_33_1%_CRCW060333R0FKEA_VASHAY | 33R | 1% | 603 | Yes | Top | 33ohm, SMD Resistor | VISHAY DRALORIC | CRCW060333R0FKEA | FEC 1469802
R96 | RES | DNI | 1% | R0603 | Yes | Top | 11.3k, SMD Resistor | MultiComp | MC 0.0625W 0603 1% 11K3 | Not Inserted
R97 | RES | DNI | 1% | R0603 | Yes | Top | 1k, SMD Resistor | Multicomp | MC 0.063W 0603 1% 1K (FEC 9330380) | Not Inserted
R106 | RES | DNI |  | R0603 | Yes | Top | 0R, SMD Resistor | Multicomp | MC 0.063W 0603 0R | Not Inserted
R115 | RES | 0R | 1% | R0603 | Yes | Top | 0R, SMD Resistor | Multicomp | MC 0.063W 0603 0R | FEC 9331662
SCREW1 | SCREW_M3X16 |  |  | SCREW_M3X16 | No | Top | SCREW, CHEESE, NYLON, M3X16, PK100 | ALLTHREAD | 119030016 | FEC 7070615
SCREW2 | SCREW_M3X16 |  |  | SCREW_M3X16 | No | Top | SCREW, CHEESE, NYLON, M3X16, PK100 | ALLTHREAD | 119030016 | FEC 7070615
U1 | AD5422_LFCSP |  |  | LFCSP-40 | Yes | Top | 16-Bit DAC | Analog Devices | AD5422BCPZ | AD5422BCPZ
U2 | AD5700-1 |  |  | LFCSP-24 | Yes | Top | Hart Modem | Analog Devices | AD5700-1BCPZ | AD5700-1BCPZ
U3 | IC_ADUM3471CRSZ_ADI | ADUM3471CRSZ |  | SSOP20 | Yes | Top | ISOLATED SWITCHING REGULATORS | Analog Devices | ADUM3471CRSZ | ADUM3471CRSZ
U4 | ADUM3482 |  |  | SSOP20 | Yes | Top | Digital isolator | Analog Devices | ADUM3482BRSZ | ADUM3482BRSZ
U5 | ADP2441 |  |  | LFCSP-12-3MM | Yes | Top | DC-DC converter | Analog Devices | ADP2441 | ADP2441ACPZ-R7
U6 | ADP7182-ADJ | DNI |  | TSOT-5 | Yes | Top | -30V Low Noise LDO | Analog Devices | ADP7182 | Not Inserted
U7 | ADR02-SOIC8 |  |  | SO8NB | Yes | Top | 5V Reference | Analog Devices | ADR02BRZ | ADR02BRZ
U8 | OP1177 |  |  | SO8NB | Yes | Top | Precision, Low Loise, Single OP Amp | Analog Devices | OP1177ARZ | OP1177ARZ
U9 | 24LC32 |  |  | MSO8 | Yes | Top | 32K I2C Serial EEPROM | Microchip | 24LC32A-I/MS | FEC1331330
U10 | IC_SN74LVC1G125DCKR_SOT353_TI |  |  | SOT353 | Yes | Top | LOGIC, BUFFER, SINGLE | DIODES INC. | 74LVC1G125SE-7 | FEC 1893827RL
