Morfey1974/HVAC_CleanRoom_Project/Docs/3D Models/Modul_AI/Старый корпус/PhoenixContact_1/PHOENIX_CONTACT_Cart_Export_2026-08-17.xlsx

Item number | GTIN | Type | Item description | Productkey | Availability (as of 2026-08-17) | Shipping date (as of 2026-08-17) | Quantity in cart | Minimum order quantity | Packing unit | Unit | Break packing
2896102 | 4046356096638 | BC 17,8 DKL S TRANS | Housing cover | ACHBAB | In stock | 2026-08-19 | 10 | 1 | 10 | Piece | Not allowed
2278432 | 4046356293051 | MKDSO 1,5/ 4-L-3,5 KMGY | PCB terminal block | ACHADA | In stock | 2026-08-19 | 50 | 1 | 50 | Piece | Allowed
2854115 | 4017918458997 | ME B-17,5 MKDSO KMGY | Filler plug | ACHAAZ | In stock | 2026-08-19 | 10 | 10 | 10 | Piece | Not allowed
2278173 | 4046356286206 | HBUS-B SET BK | Protective cap | ACHBBZ | In stock | 2026-08-19 | 10 | 1 | 10 | Piece | Not allowed
