Morfey1974/HVAC_CleanRoom_Project/Docs/Project_Costs.xlsx

Sheet: Заказы
Номер заказа | Дата | Поставщик | Сумма без НДС (ILS) | НДС (ILS) | Итого с НДС (ILS) | Доставка (ILS) | Растаможка (ILS) | Курс шекеля
183295 | 02/08/2026 | Phoenix Contact | ₪1815.80 | ₪326.84 | ₪2142.64 | ₪0.00 | ₪0.00 | #VALUE! | ₪3.0773
183969 | 18/08/2026 | Phoenix Contact | ₪825.96 | ₪148.67 | ₪974.63 | ₪0.00 | ₪0.00 | #VALUE! | ₪3.43
2140357A | 24/08/2026 | JLCPCB | ₪480.27 | ₪0.00 | ₪480.27 | ₪77.82 | ₪0.00
440482 | 08/09/2026 | Phoenix Contact | ₪488.98 | ₪88.02 | ₪577.00 | ₪0.00 | ₪0.00 | 3.5015

Sheet: Детали
Номер заказа | Артикул | Описание | Тип (РУС) | Количество | Цена за шт (EUR/DOL) | Итого (ILS)
183295 | 2896241 | BC 17,8 UT HBUS BK | Нижняя часть корпуса | 10 | 2.72 | 95.72
183295 | 2896144 | BC 17,8 DKL R KMGY | Крышка корпуса | 10 | 1.22 | 42.93
183295 | 2896322 | HBUS 53,6-16P-3S BK | Шинный соединитель на DIN-рейку | 10 | 16.83 | 592.25
183295 | 1534550 | FKDSO 1,5/4-L KMGY | Клеммный блок на плату | 50 | 1.94 | 341.34
183295 | 1534556 | BC 17,8 BS FKDSO KMGY | Заглушка клеммника | 50 | 0.56 | 98.53
183295 | 2200701 | PSTD 0,65X0,65/9-H 2,54 | Штыревой разъем (гребенка) | 50 | 1.09 | 191.79
183295 | 2279732 | BC 17,8 OTU MKDSO KMGY | Верхняя часть корпуса | 10 | 1.81 | 63.69
183295 | 2896283 | HBUS 35,6-16P-1S BK | Шинный соединитель на DIN-рейку | 10 | 11.07 | 389.55
183969, 440482 | 2896102 | BC 17,8 DKL S TRANS | Прозрачная крышка корпуса | 20 | 1.5 | 103.8
183969, 440482 | 2278432 | MKDSO 1,5/ 4-L-3,5 KMGY | Клеммный блок на плату | 100 | 1.57 | 543.24
183969, 440482 | 2854115 | ME B-17,5 MKDSO KMGY | Заглушка | 60 | 0.43 | 89.27
183969, 440482 | 2278173 | HBUS-B SET BK | Заглушка для шины (комплект) | 20 | 1.71 | 118.34
183969 | 2896199 | BC 17,6 BS U22 KMGY | Заглушка корпуса | 50 | 2.04 | 348.71
183969, 440482 | 2896115 | BC 35,6 DKL S TRANS | Прозрачная крышка корпуса | 20 | 1.61 | 111.41
2140357A | SMT026082260698-Y214 | Rigid Populated printed circuit board (Modul_AI) | Печатная плата в сборе | 2 | 265.93 | 531.82

Sheet: Modul_AI
№ | Артикул | Наименование | Цена партии | Кол-во в партии | Цена за ед. | Доставка | Кол-во на модуль | Сумма
Корпус
1 | 2896241 | Нижняя часть корпуса (BC 17,8 UT HBUS BK) | ₪122.42 | 10 | ₪12.24 | ₪0.00 | 1 | ₪12.24
2 | 2279732 | Верхняя часть корпуса (BC 17,8 OTU MKDSO KMGY) | ₪63.69 | 10 | ₪6.37 | ₪0.00 | 1 | ₪6.37
3 | 2278432 | Клеммный блок на плату (MKDSO 1,5/ 4-L-3,5 KMGY) | ₪268.37 | 50 | ₪5.37 | ₪0.00 | 1 | ₪5.37
4 | 2854115 | Заглушка (ME B-17,5 MKDSO KMGY) | ₪44.10 | 30 | ₪1.47 | ₪0.00 | 3 | ₪4.41
5 | 2896102 | Прозрачная крышка корпуса (BC 17,8 DKL S TRANS) | ₪51.28 | 10 | ₪5.13 | ₪0.00 | 1 | ₪5.13
6 | 2896322 | Шинный соединитель на DIN-рейку (HBUS 53,6-16P-3S BK) | ₪592.25 | 10 | ₪59.23 | ₪0.00 | 0.33 | ₪19.54 | Идет один на ри модуля
Итого корпус |  |  |  |  |  |  |  | ₪53.06
Плата
№ | Артикул | Наименование | Цена партии, $ | Кол-во в партии | Цена за ед.$ | Доставка,$ | Кол-во на модуль | Налоги,Шек | Сумма, Шек
1 | W2026092021060492 | Печатная плата в сборе Modul_AI | 301.95 | 10 | 30.195 | 28.14 | 1 | 414 | ₪142.98
Итого плата |  |  |  |  |  |  |  |  | ₪142.98
Всего модуль |  |  |  |  |  |  |  |  | ₪196.04

Sheet: Modul_Lokomotiv
№ | Артикул | Наименование | Цена партии | Кол-во в партии | Цена за ед. | Доставка | Кол-во на модуль | Сумма
Корпус
1 | 2896254 | BC 35,6 UT HBUS BK - Нижняя часть корпуса |  | 10 | ₪0.00 | ₪0.00 | 1 | ₪0.00
2 | 2896047 | BC 35,6 OT U22 KMGY - Верхняя часть корпуса |  | 10 | ₪0.00 | ₪0.00 | 1 | ₪0.00
4 | 2896199 | BC 17,6 BS U22 KMGY - Заглушка | ₪348.71 | 50 | ₪6.97 | ₪0.00 | 1 | ₪6.97
5 | 2896115 | BC 35,6 DKL S TRANS - Крышка корпуса | ₪55.04 | 10 | ₪5.50 | ₪0.00 | 1 | ₪5.50
6 | 2896283 | HBUS 35,6-16P-1S BK - Шинный соединитель для установки на монтажную рейку | ₪389.55 | 10 | ₪38.95 | ₪0.00 | 1 | ₪38.95
Итого корпус |  |  |  |  |  |  |  | ₪51.43
Плата
№ | Артикул | Наименование | Цена партии, $ | Кол-во в партии | Цена за ед.$ | Доставка,$ | Кол-во на модуль | Налоги,Шек | Сумма, Шек
1 | W2026092021170698 | Печатная плата в сборе Modul_Lokomotiv | $167.54 | 25 | $6.70 | $56.39 | 1 | ₪356.00 | ₪41.80
2 | W2026092617531478 | Плата CAN_With MINIPower | $274.17 | 50 | $5.48 | $43.72 | 1 | ₪407.00 | ₪27.70
3 | W2026092022272339 | Плата CAN | $283.99 | 50 | $56.39 | $43.72 | 1 | ₪419.00 | ₪184.60
Итого плата |  |  |  |  |  |  |  |  | ₪254.11
Всего модуль |  |  |  |  |  |  |  |  | ₪305.54

Sheet: Modul_HUB_Displays
№ | Артикул | Наименование | Цена партии | Кол-во в партии | Цена за ед. | Доставка | Кол-во на модуль | Сумма
Корпус
1 | 2896270 | BC 107,6 UT HBUS BK - Нижняя часть корпуса | ₪122.42 | 10 | ₪12.24 | 0 | 1 | ₪12.24
2 | 2896089 | BC 107,6 OT U22 KMGY - Верхняя часть корпуса | ₪91.30 | 10 | ₪9.13 | 0 | 1 | ₪9.13
3 | 2896131 | BC 107,6 DKL S TRANS - Крышка корпуса | ₪72.62 | 10 | ₪7.26 | 0 | 1 | ₪7.26
4 | 2896306 | HBUS 107,6-16P-1S BK - Шинный соединитель для установки на монтажную рейку | ₪540.88 | 10 | ₪54.09 | 0 | 1 | ₪54.09
Итого корпус |  |  |  |  |  |  |  | ₪82.72
Плата
№ | Артикул | Наименование | Цена партии, $ | Кол-во в партии | Цена за ед.$ | Доставка,$ | Кол-во на модуль | Налоги,Шек | Сумма, Шек
1 | W2026083101061515 | Печатная плата в сборе Modul_HUB_Display | $138.32 | 5 | $27.66 | $60.17 | 1 | ₪340.00 | ₪190.16
2 | W2026092617531478 | Плата CAN_With MINIPower | $274.17 | 50 | $5.48 | $43.72 | 1 | ₪407.00 | ₪27.70
3 | W2026092022272339 | Плата CAN | $283.99 | 50 | $56.39 | $43.72 | 1 | ₪419.00 | ₪184.60
Итого плата |  |  |  |  |  |  |  |  | ₪402.47
Всего модуль |  |  |  |  |  |  |  |  | ₪485.19

Sheet: Modul_Main_PLC
№ | Артикул | Наименование | Цена партии, Шек | Кол-во в партии | Цена за ед.Шек | Доставка | Кол-во на модуль | Сумма, Шек
Корпус
1 | 2896270 | BC 107,6 UT HBUS BK - Нижняя часть корпуса | ₪122.42 | 10 | ₪12.24 | 0 | 1 | ₪12.24
2 | 2896089 | BC 107,6 OT U22 KMGY - Верхняя часть корпуса | ₪91.30 | 10 | ₪9.13 | 0 | 1 | ₪9.13
3 | 2896238 | BC 53,6 BS U22 KMGY - Заглушка | ₪430.56 | 50 | ₪8.61 | 0 | 1 | ₪8.61
4 | 2896131 | BC 107,6 DKL S TRANS - Крышка корпуса | ₪72.62 | 10 | ₪7.26 | 0 | 1 | ₪7.26
5 | 2896306 | HBUS 107,6-16P-1S BK - Шинный соединитель для установки на монтажную рейку | ₪540.88 | 10 | ₪54.09 | 0 | 1 | ₪54.09
6 | 2896199 | BC 17,6 BS U22 KMGY - Заглушка | ₪348.71 | 50 | ₪6.97 | 0 | 2 | ₪13.95
Итого корпус |  |  |  |  |  |  |  | ₪105.28
Плата
№ | Артикул | Наименование | Цена партии, $ | Кол-во в партии | Цена за ед.$ | Доставка,$ | Кол-во на модуль | Налоги,Шек | Сумма, Шек
1 | W2026092617361097 | Печатная плата Modul_Main_PLC | $297.18 | 5 | $59.44 | $43.72 | 1 | ₪420.00 | ₪293.81
2 | W2026092620013720 | Плата часов RTC | $117.31 | 50 | $2.35 | $43.72 | 1 | ₪322.00 | ₪16.35
3 | W2026092617531478 | Плата CAN_With MINIPower | $274.17 | 50 | $5.48 | $43.72 | 1 | ₪407.00 | ₪27.70
4 | W2026092022272339 | Плата CAN | $283.99 | 50 | $56.39 | $43.72 | 1 | ₪419.00 | ₪184.60
Итого плата |  |  |  |  |  |  |  |  | ₪522.47
Всего модуль |  |  |  |  |  |  |  |  | ₪627.75

Sheet: Modul_Display
№ | Артикул | Наименование | Цена партии, Шек | Кол-во в партии | Цена за ед.Шек | Доставка | Кол-во на модуль | Сумма, Шек
Корпус
1 |  | Верхняя крышка басис на 3D принтере | ₪30.00 | 1 | ₪30.00 | 0 | 1 | ₪30.00
2 |  | Верхняя крышка лицевая на 3D принтере | ₪30.00 | 1 | ₪30.00 | 0 | 1 | ₪30.00
3 |  | Задняя крышка на 3D принтере | ₪30.00 | 1 | ₪30.00 | 0 | 1 | ₪30.00
Итого корпус |  |  |  |  |  |  |  | ₪60.00
Плата
№ | Артикул | Наименование | Цена партии, $ | Кол-во в партии | Цена за ед.$ | Доставка,$ | Кол-во на модуль | Налоги,Шек | Сумма, Шек
1 | W2026092617361097 | Печатная плата Modul_Main_PLC | $210.42 | 5 | $42.08 | $32.67 | 1 | ₪367.00 | ₪223.01
Итого плата |  |  |  |  |  |  |  |  | ₪223.01
Всего модуль |  |  |  |  |  |  |  |  | ₪283.01
