Morfey1974/HVAC_CleanRoom_Project/Docs/3D Models/Modul HUB Display/PhoenixContact/PhoenixContact_1.stp

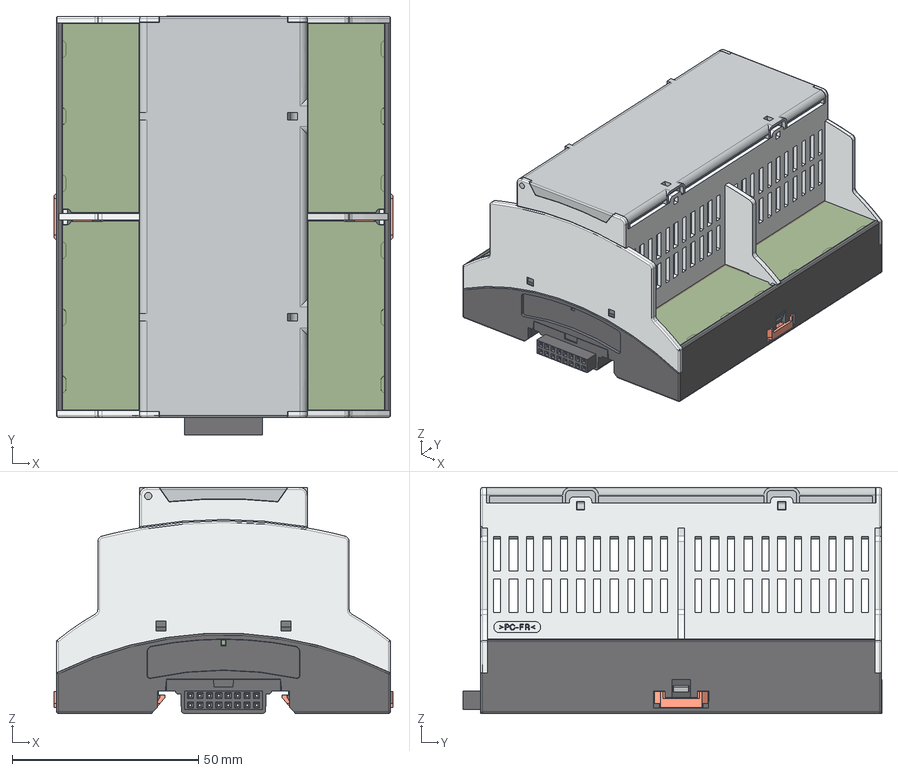
[picture p22: CAD file, 2026-08-30]
Docs/3D Models/Modul HUB Display/PhoenixContact/PhoenixContact_1.stp
91.0 x 112.4 x 60.7 mm
