Morfey1974/HVAC_CleanRoom_Project/Docs/3D Models/Modul_AI/Корпус с шурупным клемником/PhoenixContact_1/PhoenixContact_1.stp

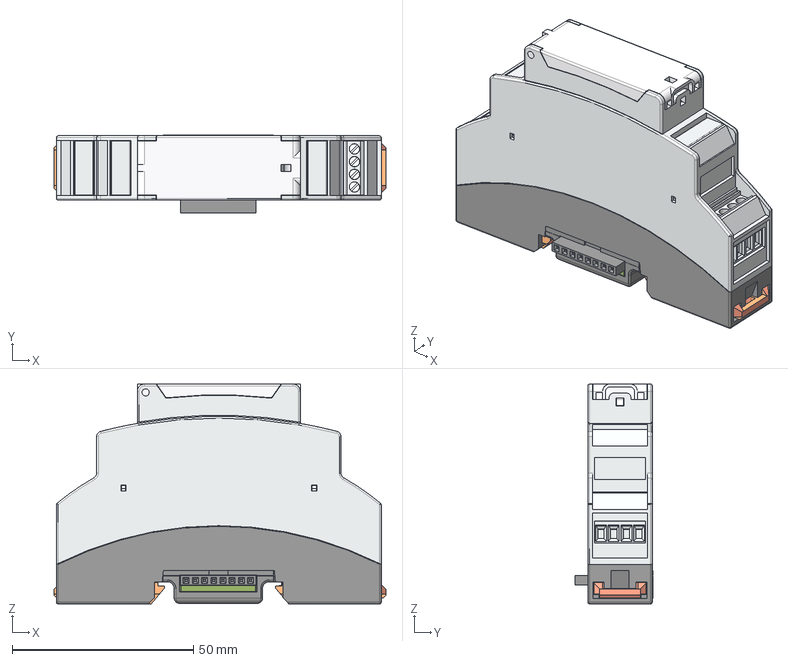
[picture p23: CAD file, 2026-10-04]
Docs/3D Models/Modul_AI/Корпус с шурупным клемником/PhoenixContact_1/PhoenixContact_1.stp
91.7 x 21.4 x 60.7 mm
