Morfey1974/HVAC_CleanRoom_Project/Docs/3D Models/Modul_AI/Новый корпус/PhoenixContact_1 (7)/PhoenixContact_1.stp

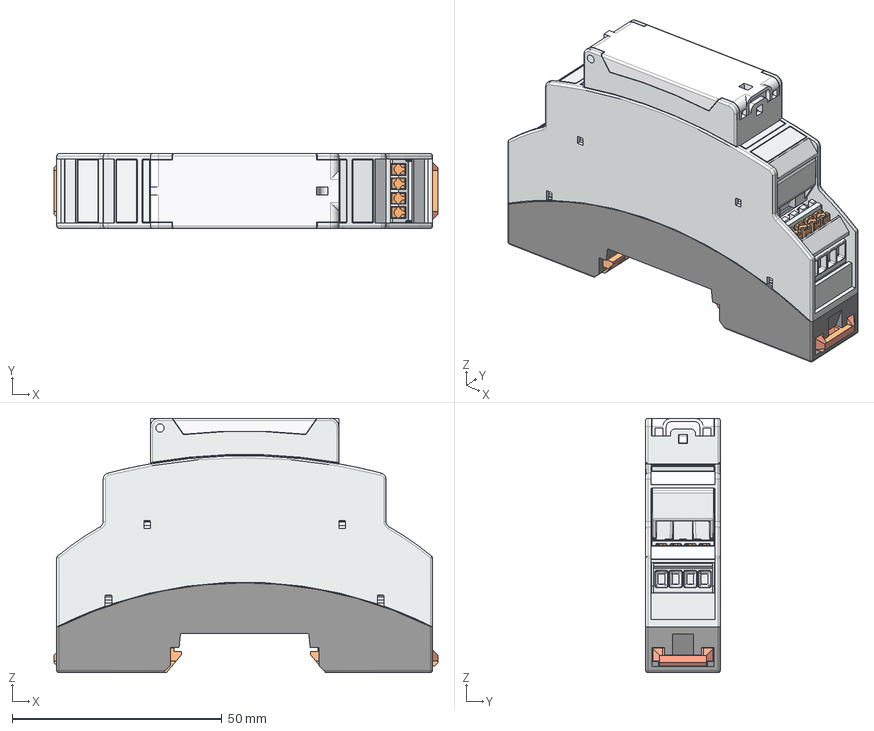
[picture p24: CAD file, 2026-08-30]
Docs/3D Models/Modul_AI/Новый корпус/PhoenixContact_1 (7)/PhoenixContact_1.stp
91.7 x 17.8 x 60.7 mm
