Morfey1974/HVAC_CleanRoom_Project/Docs/3D Models/Modul_Lokomotiv/PhoenixContact_2/PhoenixContact_2.stp

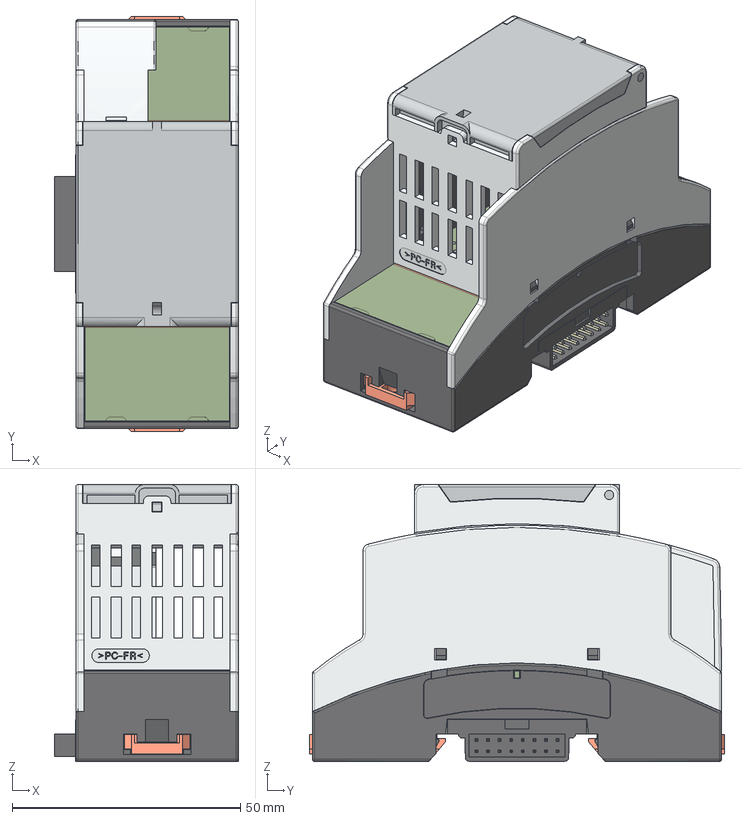
[picture p25: CAD file, 2026-08-30]
Docs/3D Models/Modul_Lokomotiv/PhoenixContact_2/PhoenixContact_2.stp
40.4 x 91.0 x 60.7 mm
