Morfey1974/HVAC_CleanRoom_Project/Docs/3D Models/Modul_AI/Старый корпус/PhoenixContact_1/PhoenixContact_1.stp

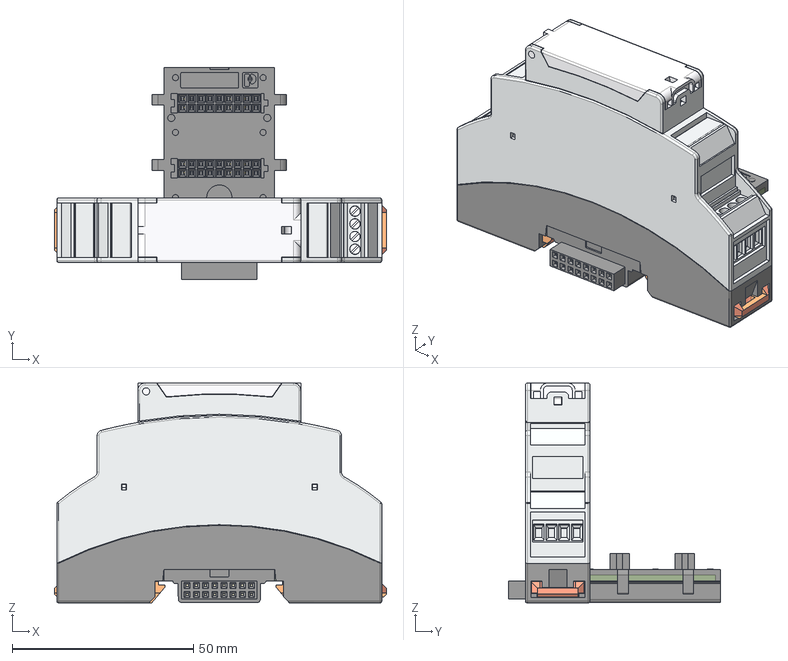
[picture p26: CAD file, 2026-08-30]
Docs/3D Models/Modul_AI/Старый корпус/PhoenixContact_1/PhoenixContact_1.stp
91.7 x 58.5 x 60.7 mm
