Morfey1974/HVAC_CleanRoom_Project/(list of files, cad)

Other CAD files:
Docs/3D Models/Modul_AI/Старый корпус/PhoenixContact_1/2026_08_17_12_07 _20_0242 _ 2026_08_17_12_07_20_0243.dxf
Docs/3D Models/Modul HUB Display/PhoenixContact/Plata.dxf
Docs/3D Models/Modul_AI/Старый корпус/PhoenixContact_1/2026_08_17_12_07 _20_0542 _ 2026_08_17_12_07_20_0542.dxf
