Morfey1974/HVAC_CleanRoom_Project/Docs/Schematic_PLC-Modbus_2026-07-01.pdf

# CONNECTORS

TRANSCEIVERS | POWER 24VDC

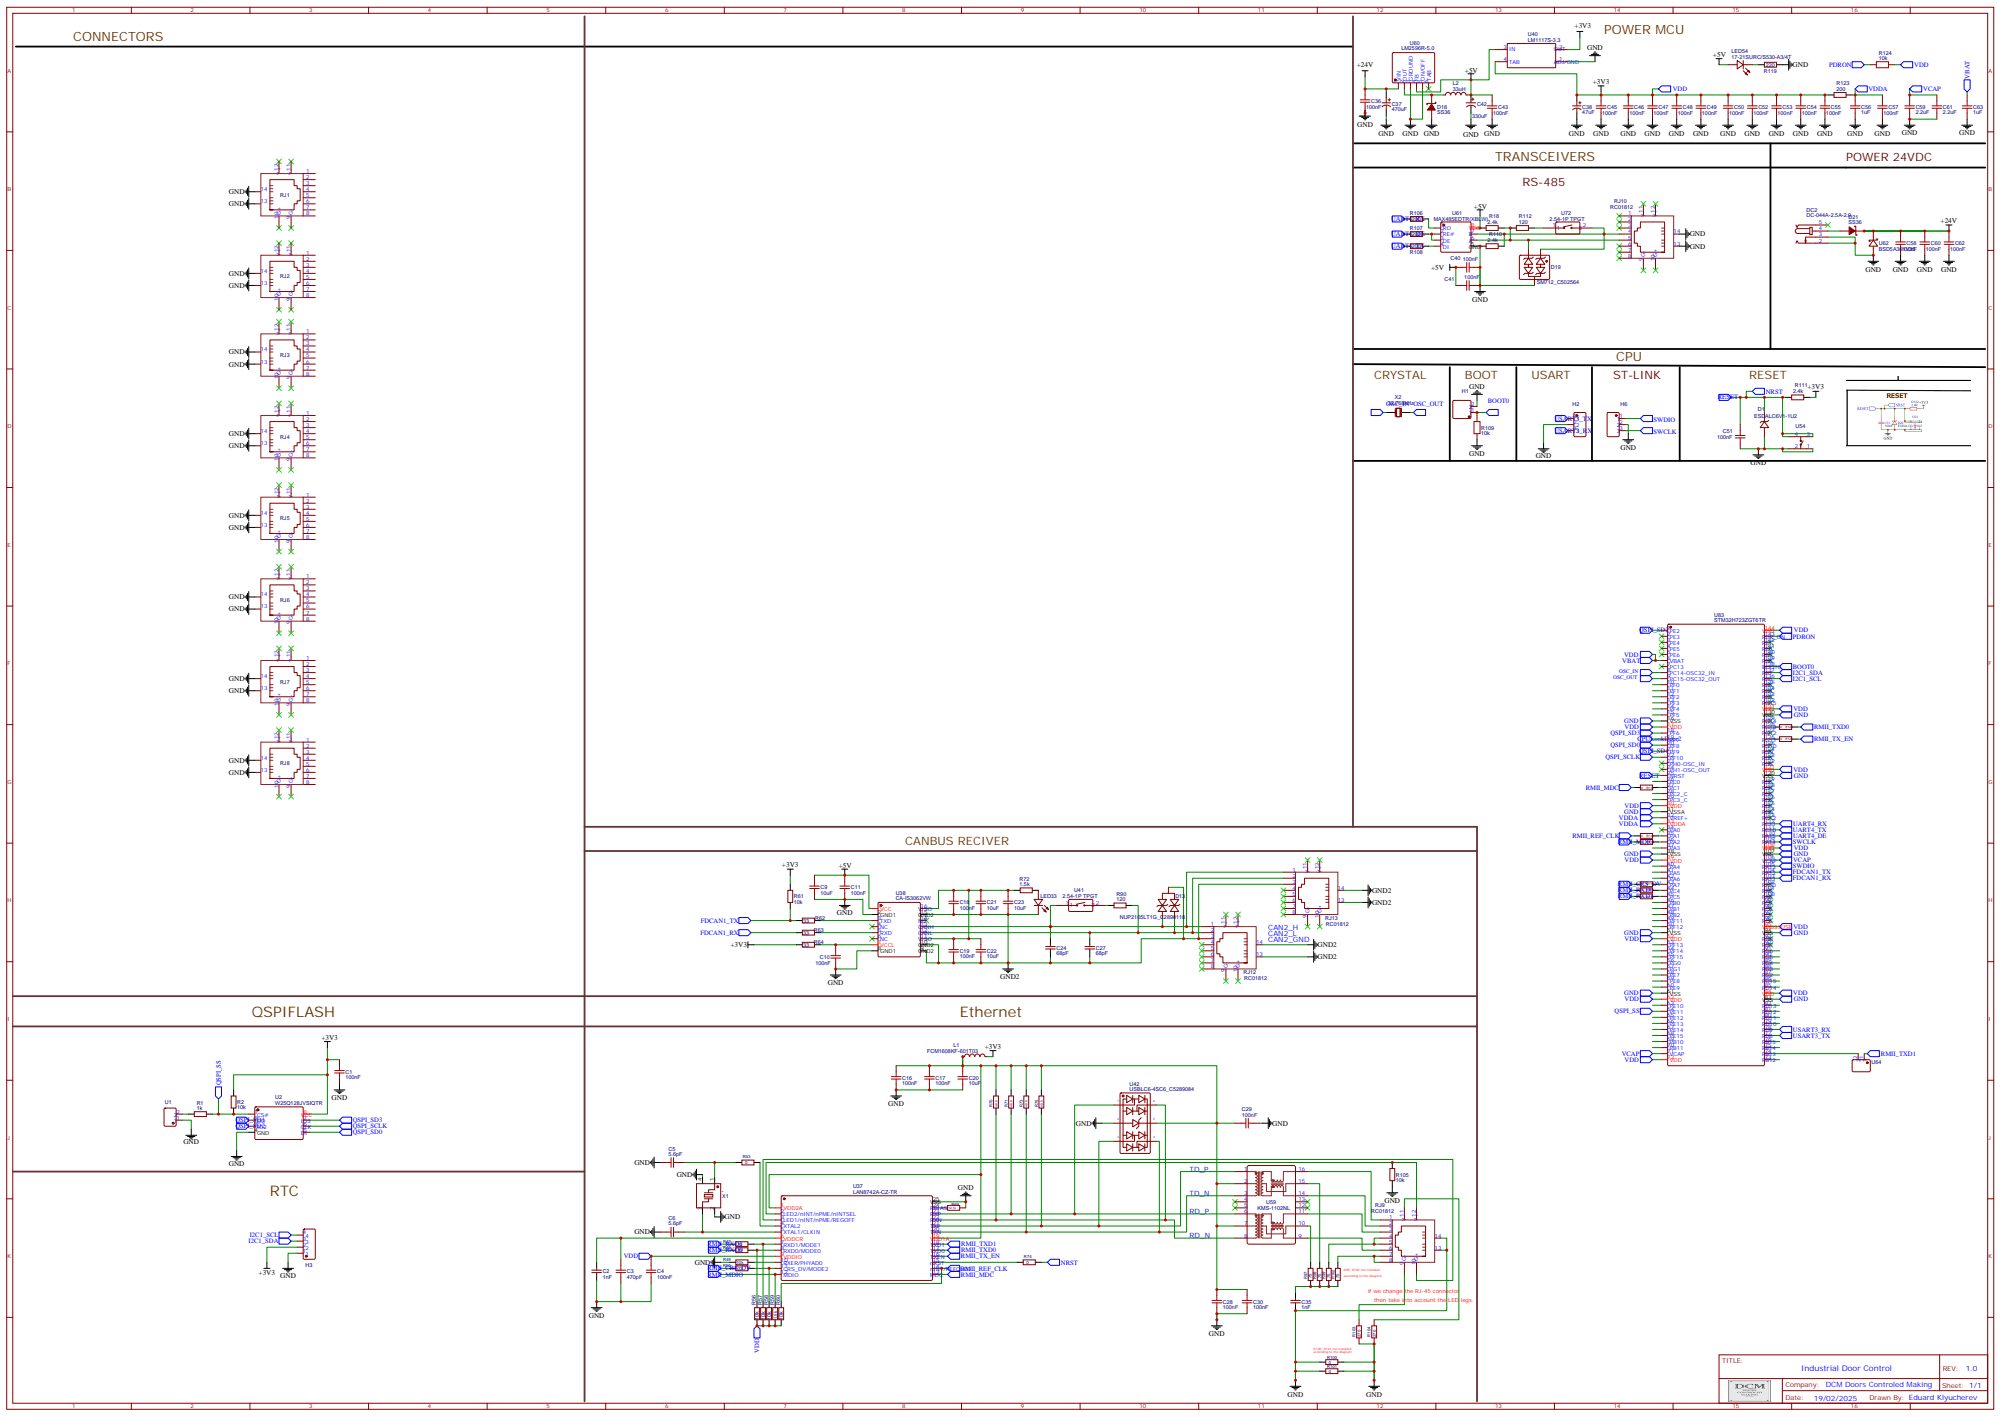
[picture p27: page 1]

R99, R102 not installed
according to the diagram

if we change the RJ-45 connector
then take into account the LED legs.

Company: DCM Doors Controled Making

Drawn By: Eduard Klyucherev
