Morfey1974/HVAC_CleanRoom_Project/Docs/NanoMoution-HVAC-W-PID.pdf

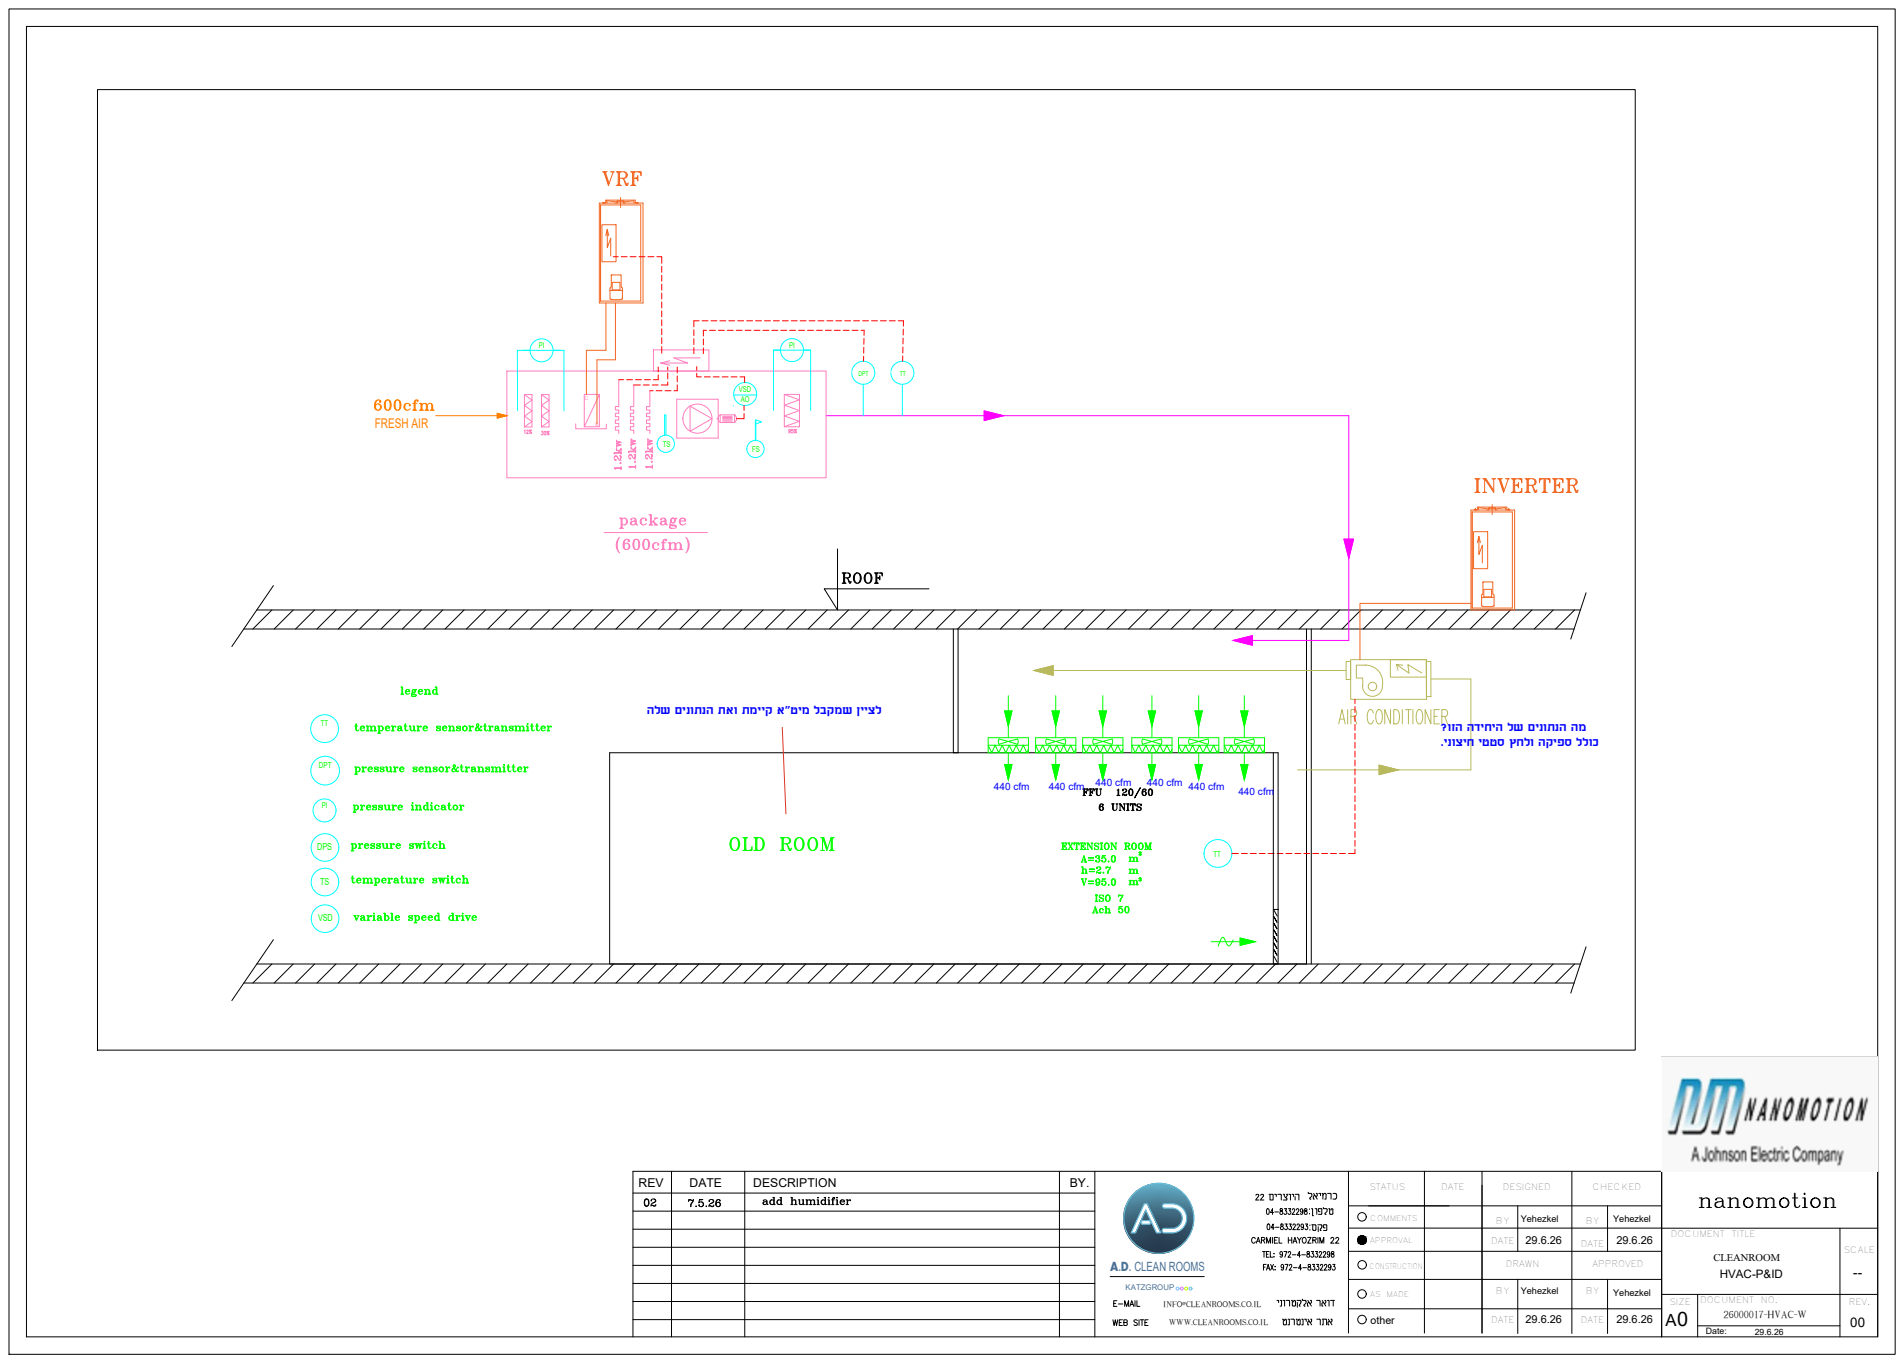
[picture p28: page 1]
TT DPT PI DPS VSD; C FRESH AIR; AO VSD; DPT; COMMENTS APPROVAL CONSTRUCTION AS MADE; Date: DOCUMENT NO.; REV. SCALE SIZE DOCUMENT TITLE A REV; DATE; DESCRIPTION; DRAWN; APPROVED DESIGNED; CHECKED BY DATE BY DATE; BY DATE BY DATE STATUS; DATE A.D. CLEAN ROOMS KATZGROUPINFO@CLEANROOMS.CO.IL WWW.CLEANROOMS.CO.IL; 00 26000017-HVAC-W HVAC-P&ID CLEANROOM Yehezkel 29.6.26 29.6.26; 29.6.26 29.6.26 Yehezkel Yehezkel; Yehezkel other 440 cfm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
