Morfey1974/HVAC_CleanRoom_Project/(list of files, drawings)

Other design files:
Docs/Analog Devices/Output/CN0321-DesignSupport/CN0321-DesignSupport/EVAL-CN0321-SDPZ_Layout_Rev0.pcb
Docs/Texas Instruments/Input/tidc825/PCB/TIPD164_Altium_and_GERBERs_revA/DAC8760-PCPLIB.PcbLib
Docs/Texas Instruments/Input/tidc825/PCB/TIPD164_Altium_and_GERBERs_revA/TIPD164.PrjPcb
Docs/Texas Instruments/Input/tidc825/PCB/TIPD164_Altium_and_GERBERs_revA/TIPD164_PCB.PcbDoc
Docs/Texas Instruments/Input/tidc825/PCB/TIPD164_Altium_and_GERBERs_revA/TIPD164_SCH.SchDoc
Docs/Texas Instruments/Input/TIPD164_PCB.PcbDoc
Docs/Texas Instruments/Input/TIPD164_SCH.SchDoc
