Morfey1974/HVAC_CleanRoom_Project/Firmware_Displays/Display_TFT10.1_HMI/Application/Core/Src/main.c

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
/* Includes ------------------------------------------------------------------*/
#include "main.h"
#include "fdcan.h"
#include "i2c.h"
#include "tim.h"
#include "usart.h"
#include "gpio.h"
#include "fmc.h"

/* USER CODE BEGIN Includes */
#include "ssd1963.h"
#include "room_ui.h"
#include "gt9271.h"
#include "hmi_menu.h"
/* USER CODE END Includes */


/* USER CODE BEGIN PV */
static RoomUi_Values g_room_values;
static uint8_t g_doors_mask = 0x1FU;
static uint8_t g_link = 1U;
static uint8_t g_sim_on = 1U;
static HmiMenu_Ctx g_menu;
/* USER CODE END PV */

void SystemClock_Config(void);
static void MPU_Config(void);
/**
  * @brief  The application entry point.
  * @retval int
  */
int main(void)
{

  /* USER CODE BEGIN 1 */
  SCB_EnableICache();
  /* USER CODE END 1 */

  /* MPU Configuration--------------------------------------------------------*/
  MPU_Config();

  /* MCU Configuration--------------------------------------------------------*/

  /* Reset of all peripherals, Initializes the Flash interface and the Systick. */
  HAL_Init();

  /* Configure the system clock */
  SystemClock_Config();

  /* USER CODE BEGIN SysInit */
  /* FMC Bank1 @0x60000000: open MPU (Region0 otherwise blocks it) */
  {
    MPU_Region_InitTypeDef MPU_InitStruct = {0};

    HAL_MPU_Disable();

    MPU_InitStruct.Enable = MPU_REGION_ENABLE;
    MPU_InitStruct.Number = MPU_REGION_NUMBER0;
    MPU_InitStruct.BaseAddress = 0x0;
    MPU_InitStruct.Size = MPU_REGION_SIZE_4GB;
    MPU_InitStruct.SubRegionDisable = 0x8F;
    MPU_InitStruct.TypeExtField = MPU_TEX_LEVEL0;
    MPU_InitStruct.AccessPermission = MPU_REGION_NO_ACCESS;
    MPU_InitStruct.DisableExec = MPU_INSTRUCTION_ACCESS_DISABLE;
    MPU_InitStruct.IsShareable = MPU_ACCESS_SHAREABLE;
    MPU_InitStruct.IsCacheable = MPU_ACCESS_NOT_CACHEABLE;
    MPU_InitStruct.IsBufferable = MPU_ACCESS_NOT_BUFFERABLE;
    HAL_MPU_ConfigRegion(&MPU_InitStruct);

    MPU_InitStruct.Number = MPU_REGION_NUMBER1;
    MPU_InitStruct.BaseAddress = 0x60000000;
    MPU_InitStruct.Size = MPU_REGION_SIZE_64MB;
    MPU_InitStruct.SubRegionDisable = 0x00;
    MPU_InitStruct.AccessPermission = MPU_REGION_FULL_ACCESS;
    MPU_InitStruct.IsCacheable = MPU_ACCESS_NOT_CACHEABLE;
    MPU_InitStruct.IsBufferable = MPU_ACCESS_NOT_BUFFERABLE;
    HAL_MPU_ConfigRegion(&MPU_InitStruct);

    HAL_MPU_Enable(MPU_PRIVILEGED_DEFAULT);
  }
  /* USER CODE END SysInit */

  /* Initialize all configured peripherals */
  MX_GPIO_Init();
  MX_TIM2_Init();
  MX_USART3_UART_Init();
  MX_TIM3_Init();
  MX_TIM4_Init();
  MX_FMC_Init();
  MX_FDCAN1_Init();
  MX_I2C1_Init();
  /* USER CODE BEGIN 2 */
  LT7683_Init();

  g_room_values.temperature_c = 22.4f;
  g_room_values.humidity_pct = 45.0f;
  g_room_values.pressure_pa = 20.0f;
  g_room_values.t_set = 22.0f;
  g_room_values.fan_speed = 80.0f;
  g_room_values.fault_mask = 0U;

  RoomUi_Init("Clean Room");
  RoomUi_Update(&g_room_values);
  RoomUi_UpdateDoors(g_doors_mask, g_link);

  (void)GT9271_Init();
  g_menu.values = &g_room_values;
  g_menu.doors_mask = &g_doors_mask;
  g_menu.link = &g_link;
  g_menu.sim_on = &g_sim_on;
  HmiMenu_Init(&g_menu);
  /* USER CODE END 2 */

  /* Infinite loop */
  /* USER CODE BEGIN WHILE */
  while (1)
  {
    /* USER CODE END WHILE */

    /* USER CODE BEGIN 3 */
    {
      uint16_t tx = 0U;
      uint16_t ty = 0U;
      uint8_t down = GT9271_Poll(&tx, &ty);
      HmiMenu_Poll(down, tx, ty);
    }
    if (HmiMenu_IsOpen() == 0U)
    {
      if (g_sim_on != 0U)
      {
        RoomUi_SimulateStep(&g_room_values, HAL_GetTick());
      }
      RoomUi_Update(&g_room_values);
    }
    HAL_Delay(20);
  }
  /* USER CODE END 3 */
}

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
 /* MPU Configuration */

void MPU_Config(void)
{
  MPU_Region_InitTypeDef MPU_InitStruct = {0};

  /* Disables the MPU */
  HAL_MPU_Disable();

  /** Initializes and configures the Region and the memory to be protected
  */
  MPU_InitStruct.Enable = MPU_REGION_ENABLE;
  MPU_InitStruct.Number = MPU_REGION_NUMBER0;
  MPU_InitStruct.BaseAddress = 0x0;
  MPU_InitStruct.Size = MPU_REGION_SIZE_4GB;
  MPU_InitStruct.SubRegionDisable = 0x8F;
  MPU_InitStruct.TypeExtField = MPU_TEX_LEVEL0;
  MPU_InitStruct.AccessPermission = MPU_REGION_NO_ACCESS;
  MPU_InitStruct.DisableExec = MPU_INSTRUCTION_ACCESS_DISABLE;
  MPU_InitStruct.IsShareable = MPU_ACCESS_SHAREABLE;
  MPU_InitStruct.IsCacheable = MPU_ACCESS_NOT_CACHEABLE;
  MPU_InitStruct.IsBufferable = MPU_ACCESS_NOT_BUFFERABLE;

  HAL_MPU_ConfigRegion(&MPU_InitStruct);

  /** Initializes and configures the Region and the memory to be protected
  */
  MPU_InitStruct.Number = MPU_REGION_NUMBER1;
  MPU_InitStruct.BaseAddress = 0x60000000;
  MPU_InitStruct.Size = MPU_REGION_SIZE_64B;
  MPU_InitStruct.SubRegionDisable = 0x0;
  MPU_InitStruct.AccessPermission = MPU_REGION_FULL_ACCESS;
  MPU_InitStruct.IsBufferable = MPU_ACCESS_BUFFERABLE;

  HAL_MPU_ConfigRegion(&MPU_InitStruct);
  /* Enables the MPU */
  HAL_MPU_Enable(MPU_PRIVILEGED_DEFAULT);

}

/**
  * @brief  This function is executed in case of error occurrence.
  * @retval None
  */
void Error_Handler(void)
{
  /* USER CODE BEGIN Error_Handler_Debug */
  /* User can add his own implementation to report the HAL error return state */
  __disable_irq();
  while (1)
  {
  }
  /* USER CODE END Error_Handler_Debug */
}
#ifdef USE_FULL_ASSERT
/**
  * @brief  Reports the name of the source file and the source line number
  *         where the assert_param error has occurred.
  * @param  file: pointer to the source file name
  * @param  line: assert_param error line source number
  * @retval None
  */
void assert_failed(uint8_t *file, uint32_t line)
{
  /* USER CODE BEGIN 6 */
  /* User can add his own implementation to report the file name and line number,
     ex: printf("Wrong parameters value: file %s on line %d\r\n", file, line) */
  /* USER CODE END 6 */
}
#endif /* USE_FULL_ASSERT */
