Morfey1974/HVAC_CleanRoom_Project/Firmware_MainPLC/Application/Firmware_MainPLC.ioc

Mcu.UserName=STM32H723ZGTx
PA1.GPIO_Label=RMII_REF_CLK
PA1.Signal=ETH_REF_CLK
PA11.Signal=USB_OTG_HS_DM
PA12.Signal=USB_OTG_HS_DP
PA13(JTMS/SWDIO).GPIO_Label=SWDIO
PA13(JTMS/SWDIO).Signal=DEBUG_JTMS-SWDIO
PA14(JTCK/SWCLK).GPIO_Label=SWCLK
PA14(JTCK/SWCLK).Signal=DEBUG_JTCK-SWCLK
PA15(JTDI).Signal=UART4_DE
PA2.GPIO_Label=RMII_MDIO
PA2.Signal=ETH_MDIO
PA7.GPIO_Label=RMII_CRS_DV
PA7.Signal=ETH_CRS_DV
PA9.Signal=USB_OTG_HS_VBUS
PB12.Signal=FDCAN2_RX
PB13.GPIO_Label=RMII_TXD1
PB13.Signal=ETH_TXD1
PB14.Signal=USART3_DE
PB6.Signal=FDCAN2_TX
PB7.Signal=I2C1_SDA
PB8.Signal=I2C1_SCL
PC0.GPIO_Label=ETH_NRST
PC0.Signal=GPIO_Output
PC1.GPIO_Label=RMII_MDC
PC1.Signal=ETH_MDC
PC10.Signal=UART4_TX
PC11.Signal=UART4_RX
PC4.GPIO_Label=RMII_RXD0
PC4.Signal=ETH_RXD0
PC5.GPIO_Label=RMII_RXD1
PC5.Signal=ETH_RXD1
PD0.Signal=FDCAN1_RX
PD1.Signal=FDCAN1_TX
PD12.Signal=FDCAN3_RX
PD8.GPIO_Label=USART3_TX
PD8.Signal=USART3_TX
PD9.GPIO_Label=USART3_RX
PD9.Signal=USART3_RX
PE1.GPIO_Label=MODUL_ID_OUT_BUS
PE1.Signal=GPIO_Output
PE11.GPIO_Label=QSPI_NCS
PE11.Signal=OCTOSPIM_P1_NCS
PE2.GPIO_Label=QSPI_IO2
PE2.Signal=OCTOSPIM_P1_IO2
PE3.GPIO_Label=MCU_MODUL_ID_OUT_AI
PE3.Signal=GPIO_Output
PE4.GPIO_Label=MCU_MODUL_ID_OUT_DISPLAY
PE4.Signal=GPIO_Output
PF0.GPIO_Label=I2C2_SDA_EEPROM
PF0.Signal=I2C2_SDA
PF1.GPIO_Label=I2C2_SCL_EEPROM
PF1.Signal=I2C2_SCL
PF10.GPIO_Label=QSPI_CLK
PF10.Signal=OCTOSPIM_P1_CLK
PF6.GPIO_Label=QSPI_IO3
PF6.Signal=OCTOSPIM_P1_IO3
PF7.Signal=FDCAN3_TX
PF8.GPIO_Label=QSPI_IO0
PF8.Signal=OCTOSPIM_P1_IO0
PF9.GPIO_Label=QSPI_IO1
PF9.Signal=OCTOSPIM_P1_IO1
PG11.GPIO_Label=RMII_TX_EN
PG11.Signal=ETH_TX_EN
PG13.GPIO_Label=RMII_TXD0
PG13.Signal=ETH_TXD0
PG2.GPIO_Label=LED_STATUS
PG2.Signal=GPIO_Output
