Morfey1974/HVAC_CleanRoom_Project/Firmware_Displays/Display_TFT10.1_HMI/Application/Core/Src/ahu_motion.c

#include "ahu_motion.h"

const uint16_t AhuFlow_LeftBg[4608] = {
  0xE73DU, 0xE73DU, 0xE73DU, 0xE73DU, 0xE73DU, 0xE73DU, 0xE73DU, 0xE73DU, 0xE73DU, 0xE73DU, 0xE73DU, 0xE73DU,
  0xE73DU, 0xE73DU, 0xE73DU, 0xE73DU, 0xE73DU, 0xE73DU, 0xE73DU, 0xE73DU, 0xE73DU, 0xE73DU, 0xE73DU, 0xE73DU,
  0xE73DU, 0xE73DU, 0xE73DU, 0xE73DU, 0xE73DU, 0xE73DU, 0xE73DU, 0xE73DU, 0xE73DU, 0xE73DU, 0xE73DU, 0xE73DU,
  0xE73DU, 0xE73DU, 0xE73DU, 0xE73DU, 0xE73DU, 0xE73DU, 0xE73DU, 0xE73DU, 0xE73DU, 0xE73DU, 0xE73DU, 0xE73DU,
  0xE73DU, 0xE73DU, 0xE73DU, 0xE73DU, 0xE73DU, 0xE73DU, 0xE73DU, 0xE73DU, 0xE73DU, 0xE73DU, 0xE73DU, 0xE73DU,
  0xE73DU, 0xE73DU, 0xE73DU, 0xE73DU, 0xE73DU, 0xE73DU, 0xE73DU, 0xE73DU, 0xE73DU, 0xE73DU, 0xE73DU, 0xE73DU,
  0xE73DU, 0xE73DU, 0xE73DU, 0xE73DU, 0xE73DU, 0xE73DU, 0xE73DU, 0xE73DU, 0xE73DU, 0xE73DU, 0xE73DU, 0xE73DU,
  0xE73DU, 0xE73DU, 0xE73DU, 0xE73DU, 0xE73DU, 0xE73DU, 0xE73DU, 0xE73DU, 0xE73DU, 0xE73DU, 0xE73DU, 0xE73DU,
  0xE73DU, 0xE73DU, 0xE73DU, 0xE73DU, 0xE73DU, 0xE73DU, 0xE73DU, 0xE73DU, 0xE73DU, 0xE73DU, 0xE73DU, 0xE73DU,
  0xE73DU, 0xE73DU, 0xE73DU, 0xE73DU, 0xE73DU, 0xE73DU, 0xE73DU, 0xE73DU, 0xE73DU, 0xE73DU, 0xE73DU, 0xE73DU,
  0xE73DU, 0xE73DU, 0xE73DU, 0xE73DU, 0xE73DU, 0xE73DU, 0xE73DU, 0xE73DU, 0xE73DU, 0xE73DU, 0xE73DU, 0xE73DU,
  0xE73DU, 0xE73DU, 0xE73DU, 0xE73DU, 0xE73DU, 0xE73DU, 0xE73DU, 0xE73DU, 0xE73DU, 0xE73DU, 0xE73DU, 0xE73DU,
  0xE73DU, 0xE73DU, 0xE73DU, 0xE73DU, 0xE73DU, 0xE73DU, 0xE73DU, 0xE73DU, 0xE73DU, 0xE73DU, 0xE73DU, 0xE73DU,
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
  0xD6DCU, 0xD6DCU, 0xD6DCU, 0xD6DCU, 0xD6DCU, 0xD6DCU, 0xD6DCU, 0xD6DCU, 0xD6DCU, 0xD6DCU, 0xD6DCU, 0xD6DCU,
  0xD6DCU, 0xD6DCU, 0xD6DCU, 0xD6DCU, 0xD6DCU, 0xD6DCU, 0xD6DCU, 0xD6DCU, 0xD6DCU, 0xD6DCU, 0xD6DCU, 0xD6DCU,
  0xD6DCU, 0xD6DCU, 0xD6DCU, 0xD6DCU, 0xD6DCU, 0xD6DCU, 0xD6DCU, 0xD6DCU, 0xD6DCU, 0xD6DCU, 0xD6DCU, 0xD6DCU,
  0xD6DCU, 0xD6DCU, 0xD6DCU, 0xD6DCU, 0xD6DCU, 0xD6DCU, 0xD6DCU, 0xD6DCU, 0xD6DCU, 0xD6DCU, 0xD6DCU, 0xD6DCU,
  0xD6DCU, 0xD6DCU, 0xD6DCU, 0xD6DCU, 0xD6DCU, 0xD6DCU, 0xD6DCU, 0xD6DCU, 0xD6DCU, 0xD6BCU, 0xC67BU, 0xBE3AU,
  0xB619U, 0xB5F9U, 0xADD9U, 0xADB8U, 0xADB8U, 0xADB8U, 0xADB8U, 0xADD9U, 0xB5F9U, 0xB619U, 0xBE3AU, 0xC67BU,
  0xCEBBU, 0xD6FCU, 0xD6DCU, 0xD6DCU, 0xD6DCU, 0xD6DCU, 0xD6DCU, 0xD6DCU, 0xD6DCU, 0xD6DCU, 0xD6DCU, 0xD6DCU,
  0xD6DCU, 0xD6DCU, 0xD6DCU, 0xD6DCU, 0xD6DCU, 0xD6DCU, 0xD6DCU, 0xD6DCU, 0xD6DCU, 0xD6DCU, 0xD6DCU, 0xD6DCU,
  0xD6DCU, 0xD6DCU, 0xD6DCU, 0xD6DCU, 0xD6DCU, 0xD6DCU, 0xD6DCU, 0xD6DCU, 0xD6DCU, 0xD6DCU, 0xD6DCU, 0xD6DCU,
  0xD6DCU, 0xD6DCU, 0xD6DCU, 0xD6DCU, 0xD6DCU, 0xD6DCU, 0xD6DCU, 0xD6DCU, 0xD6DCU, 0xD6FCU, 0xCEBBU, 0xB5F9U,
  0x9D57U, 0x9516U, 0x9517U, 0x9517U, 0x9517U, 0x9517U, 0x9517U, 0x9517U, 0x9517U, 0x9517U, 0x9517U, 0x9517U,
  0x9517U, 0x9517U, 0x9517U, 0x9517U, 0x9537U, 0xA578U, 0xB5F9U, 0xCEBBU, 0xD6DCU, 0xD6DCU, 0xD6DCU, 0xD6DCU,
  0xD6DCU, 0xD6DCU, 0xD6DCU, 0xD6DCU, 0xD6DCU, 0xD6DCU, 0xD6DCU, 0xD6DCU, 0xD6DCU, 0xD6DCU, 0xD6DCU, 0xD6DCU,
  0xD6DCU, 0xD6DCU, 0xD6DCU, 0xD6DCU, 0xD6DCU, 0xD6DCU, 0xD6DCU, 0xD6DCU, 0xD6DCU, 0xD6DCU, 0xD6DCU, 0xD6DCU,
  0xD6DCU, 0xD6DCU, 0xD6DCU, 0xD6DCU, 0xD6DCU, 0xD6DCU, 0xD6DCU, 0xD6DCU, 0xD6DCU, 0xD6DCU, 0xD6DCU, 0xC67AU,
  0xB619U, 0xA598U, 0x9537U, 0x9517U, 0x9516U, 0x8CD5U, 0x7433U, 0x63B0U, 0x5B2EU, 0x4ACDU, 0x428CU, 0x426BU,
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
};
