Morfey1974/HVAC_CleanRoom_Project/Firmware_Displays/Display_TFT10.1_HMI/Application/Core/Src/author_photo.c

#include "author_photo.h"

const uint16_t AuthorPhoto_RGB565[AUTHOR_PHOTO_W * AUTHOR_PHOTO_H] = {
  0x7BABU, 0x7BABU, 0x83ABU, 0x7BABU, 0x7BABU, 0x7BABU, 0x7B8BU, 0x7B8BU, 0x7B8BU, 0x7B8BU, 0x7B8BU, 0x7B6BU,
  0x7B6BU, 0x7B6BU, 0x7B6BU, 0x7B6BU, 0x7B6BU, 0x7B6BU, 0x7B6BU, 0x736BU, 0x734AU, 0x734BU, 0x734BU, 0x734AU,
  0x734AU, 0x732AU, 0x732AU, 0x732AU, 0x732AU, 0x732AU, 0x734AU, 0x732AU, 0x732AU, 0x732AU, 0x6B0AU, 0x6B0AU,
  0x6AEAU, 0x6AE9U, 0x6AE9U, 0x6AE9U, 0x6AE9U, 0x6AE9U, 0x6AE9U, 0x62C9U, 0x62C9U, 0x62C9U, 0x62C9U, 0x62C9U,
  0x62C9U, 0x62C9U, 0x62C9U, 0x62C9U, 0x62C9U, 0x62C9U, 0x62C9U, 0x62C9U, 0x62C9U, 0x62C8U, 0x62C8U, 0x62C8U,
  0x62C8U, 0x62C8U, 0x62C8U, 0x62A8U, 0x62C8U, 0x62C8U, 0x62C8U, 0x5AA8U, 0x5AA8U, 0x5AA8U, 0x5AA8U, 0x5AA8U,
  0x5AA8U, 0x5AA8U, 0x5AA8U, 0x5A88U, 0x5A88U, 0x5A88U, 0x5A88U, 0x5A88U, 0x5A88U, 0x5A87U, 0x5A87U, 0x5A87U,
  0x5A87U, 0x5A87U, 0x5267U, 0x5287U, 0x5288U, 0x5288U, 0x5288U, 0x5288U, 0x5AA8U, 0x5AA8U, 0x5AC9U, 0x5AC9U,
  0x5AE9U, 0x62E9U, 0x62EAU, 0x630AU, 0x6B2BU, 0x6B4BU, 0x6B6BU, 0x738CU, 0x73ACU, 0x73CDU, 0x7BCDU, 0x7BEDU,
  0x7BEDU, 0x7BEEU, 0x7C0EU, 0x7C0EU, 0x7C0EU, 0x7C0EU, 0x840EU, 0x840EU, 0x840EU, 0x840EU, 0x840EU, 0x842EU,
  0x7C0EU, 0x7C0EU, 0x7BEEU, 0x7BEEU, 0x7BEEU, 0x7BCDU, 0x73CDU, 0x73CDU, 0x73ADU, 0x6B8CU, 0x6B6CU, 0x6B6CU,
  0x6B6CU, 0x634BU, 0x632BU, 0x632BU, 0x5B0BU, 0x5AEAU, 0x52CAU, 0x52A9U, 0x4A89U, 0x4A68U, 0x4247U, 0x3A06U,
  0x31C6U, 0x3185U, 0x2964U, 0x2123U, 0x18E3U, 0x18C2U, 0x18C2U, 0x18E2U, 0x20E3U, 0x2103U, 0x2924U, 0x2924U,
  0x2103U, 0x2103U, 0x18E3U, 0x18C2U, 0x18C2U, 0x18C2U, 0x18C2U, 0x18C2U, 0x18C2U, 0x18C2U, 0x18C2U, 0x10C2U,
  0x10A2U, 0x10A2U, 0x1081U, 0x1081U, 0x1082U, 0x1082U, 0x1082U, 0x10A2U, 0x10A2U, 0x10A2U, 0x10A2U, 0x10A2U,
  0x10A2U, 0x10A2U, 0x7B8BU, 0x7BABU, 0x7B8BU, 0x7B8BU, 0x7B8BU, 0x7B8BU, 0x7B8BU, 0x7B8BU, 0x7B8BU, 0x7B8BU,
  0x7B6BU, 0x7B6BU, 0x7B6BU, 0x7B6BU, 0x7B6BU, 0x7B6BU, 0x736BU, 0x736BU, 0x734BU, 0x734BU, 0x734AU, 0x734AU,
  0x734AU, 0x734AU, 0x732AU, 0x732AU, 0x732AU, 0x732AU, 0x732AU, 0x732AU, 0x732AU, 0x6B2AU, 0x6B0AU, 0x6B0AU,
  0x6B0AU, 0x6B09U, 0x6AE9U, 0x6AE9U, 0x6AE9U, 0x6AE9U, 0x6AE9U, 0x6AE9U, 0x62C9U, 0x62C9U, 0x62C9U, 0x62C9U,
  0x62C9U, 0x62C9U, 0x62C9U, 0x62C9U, 0x62C9U, 0x62C9U, 0x62C9U, 0x62C9U, 0x62C9U, 0x62C9U, 0x62C9U, 0x62C8U,
  0x62C8U, 0x62C8U, 0x62C8U, 0x62C8U, 0x62C8U, 0x62C8U, 0x62C8U, 0x62C8U, 0x62C8U, 0x5AA8U, 0x5AA8U, 0x5AA8U,
  0x5AA8U, 0x5AA8U, 0x5AA8U, 0x5AA8U, 0x5AA8U, 0x5AA8U, 0x5AA8U, 0x5A88U, 0x5A88U, 0x5A88U, 0x5AA8U, 0x5AA8U,
  0x5AA8U, 0x5AA8U, 0x5AA8U, 0x5AA8U, 0x5AC8U, 0x5AC9U, 0x62C9U, 0x62E9U, 0x630AU, 0x630AU, 0x6B2AU, 0x6B4BU,
  0x6B6BU, 0x738CU, 0x73ACU, 0x7BACU, 0x7BCDU, 0x7BCDU, 0x7BEDU, 0x7BEEU, 0x7C0EU, 0x840EU, 0x840EU, 0x840EU,
  0x840EU, 0x842EU, 0x840EU, 0x840EU, 0x842EU, 0x840EU, 0x840EU, 0x840EU, 0x840EU, 0x7C0EU, 0x7C0EU, 0x7BEEU,
  0x7BEDU, 0x7BEDU, 0x73CDU, 0x73ADU, 0x73ACU, 0x6B8CU, 0x6B6CU, 0x634BU, 0x634BU, 0x632BU, 0x5B0BU, 0x5AEAU,
  0x52C9U, 0x52A9U, 0x4A68U, 0x4248U, 0x4227U, 0x39E6U, 0x31C6U, 0x2985U, 0x2944U, 0x2124U, 0x2103U, 0x18C2U,
  0x10A2U, 0x1081U, 0x0861U, 0x0861U, 0x0840U, 0x0040U, 0x0020U, 0x0040U, 0x0840U, 0x10A2U, 0x18E3U, 0x2103U,
  0x2924U, 0x2924U, 0x2124U, 0x2103U, 0x18E3U, 0x18E3U, 0x18C2U, 0x18C2U, 0x18C2U, 0x18C2U, 0x18C2U, 0x18C3U,
  0x18C2U, 0x18C2U, 0x10A2U, 0x10A2U, 0x1082U, 0x1082U, 0x1082U, 0x1082U, 0x1082U, 0x1082U, 0x10A2U, 0x10A2U,
  0x10A2U, 0x10A2U, 0x10A2U, 0x10A2U, 0x7B8BU, 0x7B8BU, 0x7B8BU, 0x7B8BU, 0x7B8BU, 0x7B8BU, 0x7B8BU, 0x7B6BU,
  0x7B6BU, 0x7B6BU, 0x7B6BU, 0x7B6BU, 0x7B6BU, 0x7B6BU, 0x7B6BU, 0x736BU, 0x734AU, 0x734AU, 0x734BU, 0x734BU,
  0x734AU, 0x734AU, 0x734AU, 0x732AU, 0x732AU, 0x734AU, 0x732AU, 0x732AU, 0x732AU, 0x6B2AU, 0x6B2AU, 0x6B0AU,
  0x6B0AU, 0x6B0AU, 0x6AEAU, 0x6AE9U, 0x6AE9U, 0x6AE9U, 0x6AE9U, 0x6AE9U, 0x62C9U, 0x62C9U, 0x62C9U, 0x62C9U,
  0x62C9U, 0x62C9U, 0x62C9U, 0x62C9U, 0x62C9U, 0x62C9U, 0x62C9U, 0x62C9U, 0x62C9U, 0x62C9U, 0x62C9U, 0x62C9U,
  0x62C9U, 0x62C9U, 0x62C9U, 0x62C9U, 0x62C8U, 0x62C8U, 0x62C8U, 0x62C8U, 0x62C8U, 0x62C8U, 0x62C8U, 0x5AA8U,
  0x5AA8U, 0x5AA8U, 0x5AA8U, 0x5AA8U, 0x5AA8U, 0x5AA8U, 0x5AA8U, 0x5AA8U, 0x5AA8U, 0x62A8U, 0x62C9U, 0x62C9U,
  0x62E9U, 0x62E9U, 0x630AU, 0x632AU, 0x6B4AU, 0x6B4BU, 0x736BU, 0x738CU, 0x73ACU, 0x7BADU, 0x7BCDU, 0x7BEDU,
  0x83EDU, 0x840EU, 0x840EU, 0x840EU, 0x840EU, 0x842EU, 0x840EU, 0x840EU, 0x840EU, 0x840EU, 0x842EU, 0x842EU,
  0x840EU, 0x842EU, 0x840EU, 0x840EU, 0x7C0EU, 0x7C0EU, 0x7BEEU, 0x7BEEU, 0x7BCEU, 0x73CEU, 0x73ADU, 0x738DU,
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
};
