Morfey1974/HVAC_CleanRoom_Project/Firmware_MainPLC/Application/Core/Src/plc_web.c

/*
 * plc_web.c — Main PLC HTTP server: sensor page, JSON API, firmware store API.
 *
 *   GET  /                 sensor page
 *   GET  /api/ai           sensor JSON, PLC clock ("rtc", UTC)
 *   POST /api/rtc/set?t=YYYYMMDDhhmmss  sets the PLC clock (UTC)
 *   GET  /api/fw/status?log=N   store, roll call, update run, log entries with id > N
 *   POST /api/fw/upload?size=N&crc=HEX   body = module .bin (size multiple of 8) -> NEW slot
 *   POST /api/fw/run?type=T&mode=M      update run (PLC_FWUPD_MODE_*)
 *   POST /api/fw/cancel
 *   POST /api/fw/rollback?type=T        BACKUP image to every node of the type that runs another version
 *   POST /api/id/walk                   identification walk (plc_id)
 *   POST /api/cfg?size=N&crc=HEX        body = configuration file (hvac_cfg.h) -> stored and applied
 *   GET  /api/cfg/status                configuration, module check
 *   GET  /api/can3                      CAN3 state, doors master, last received frames
 *   POST /api/can3/send?id=HEX&data=HEX standard frame on CAN3 (bench check)
 *   POST /api/doors/cmd?cmd=N&mask=HEX  command to the doors master (HVAC_DM_CMD_*)
 */
#include "plc_web.h"

#include <stdarg.h>
#include <stdio.h>
#include <stdlib.h>
#include <string.h>
#include "lwip/api.h"
#include "lwip/ip.h"
#include "lwip/tcp.h"
#include "cmsis_os2.h"
#include "main.h"
#include "plc_can.h"
#include "plc_fwupd.h"
#include "plc_fwstore.h"
#include "plc_w25q.h"
#include "plc_cfg.h"
#include "plc_rtc.h"

#define PLC_WEB_PORT        80u
#define PLC_WEB_RX_TMO_MS   5000
#define PLC_WEB_HDR_MAX     1024u
#define PLC_WEB_JSON_MAX    16384u

static const char s_page[] =
  "<!doctype html><html lang=\"ru\"><head><meta charset=\"utf-8\">"
  "<meta name=\"viewport\" content=\"width=device-width,initial-scale=1\">"
  "<title>HVAC ПЛК</title><style>"
  "body{font-family:Segoe UI,Arial,sans-serif;background:#14181f;color:#e8e8e8;margin:24px}"
  ".row{margin:12px 0}.v{font-size:56px;font-weight:600}.u{font-size:24px;color:#9aa}"
  ".bad{color:#ff5a5a}.ok{color:#5ad17a}#d{color:#889;font-size:13px}"
  "</style></head><body>"
  "<h3>Главный ПЛК — датчик Rotronic HF523</h3>"
  "<div class=\"row\">Температура<br><span class=\"v\" id=\"t\">--</span> <span class=\"u\">&deg;C</span></div>"
  "<div class=\"row\">Влажность<br><span class=\"v\" id=\"h\">--</span> <span class=\"u\">%RH</span></div>"
  "<div class=\"row\" id=\"s\">Ожидание данных…</div><pre id=\"d\"></pre>"
  "<script>"
  "function f(v,bad){return bad?'--':v.toFixed(2);}"
  "function u(){fetch('/api/ai',{cache:'no-store'}).then(r=>r.json()).then(j=>{"
  "var nl=!j.link||(j.st&0x84);"
  "t.textContent=f(j.t,nl||(j.st&2));h.textContent=f(j.h,nl||(j.st&1));"
  "t.className='v'+((nl||(j.st&2))?' bad':'');h.className='v'+((nl||(j.st&1))?' bad':'');"
  "var m=[];"
  "m.push(j.link?'<span class=ok>Связь с локомотивом: есть</span>':'<span class=bad>Связь с локомотивом: нет</span>');"
  "if(j.st&0x80)m.push('<span class=bad>Модуль AI не отвечает локомотиву</span>');"
  "if(j.st&4)m.push('<span class=bad>АЦП модуля AI не отвечает</span>');"
  "if(j.st&2)m.push('<span class=bad>Обрыв канала температуры</span>');"
  "if(j.st&1)m.push('<span class=bad>Обрыв канала влажности</span>');"
  "if(!j.init)m.push('<span class=bad>CAN ПЛК не запустился</span>');"
  "s.innerHTML=m.join('<br>');"
  "d.textContent='счётчик AI '+j.cnt+' | возраст '+j.age+' мс | CAN1 принято '+j.rx_loco+"
  "' | CAN2 отправлено '+j.tx_hub+' ошибок '+j.tx_err+' принято '+j.rx_hub+"
  "' | потеряно '+j.drop+' | bus-off '+j.boff1+'/'+j.boff2;"
  "}).catch(()=>{s.innerHTML='<span class=bad>Нет ответа от ПЛК</span>';});}"
  "setInterval(u,1000);u();"
  "</script></body></html>";

static const char s_hdr_html[] =
  "HTTP/1.1 200 OK\r\nContent-Type: text/html; charset=utf-8\r\n"
  "Cache-Control: no-store\r\nConnection: close\r\n\r\n";

static const char s_hdr_json[] =
  "HTTP/1.1 200 OK\r\nContent-Type: application/json\r\n"
  "Cache-Control: no-store\r\nConnection: close\r\n\r\n";

static const char s_404[] =
  "HTTP/1.1 404 Not Found\r\nContent-Type: text/plain\r\nConnection: close\r\n\r\nNot found";

static const char s_400[] =
  "HTTP/1.1 400 Bad Request\r\nContent-Type: text/plain\r\nConnection: close\r\n\r\nBad request";

typedef struct
{
  char     method[8];
  char     path[48];
  char     query[96];
  uint32_t content_length;
} WebReq;

static char s_hdr[PLC_WEB_HDR_MAX + 1u];
static char s_json[PLC_WEB_JSON_MAX];
static uint32_t s_json_len;
static uint32_t s_boot_key;

/* ---------- helpers ---------- */

static void Json_Add(const char *fmt, ...) __attribute__((format(printf, 1, 2)));
static void Json_Add(const char *fmt, ...)
{
  va_list ap;
  int n;

  if (s_json_len >= sizeof(s_json) - 1u) return;
  va_start(ap, fmt);
  n = vsnprintf(&s_json[s_json_len], sizeof(s_json) - s_json_len, fmt, ap);
  va_end(ap);
  if (n > 0) s_json_len += (uint32_t)n;
  if (s_json_len > sizeof(s_json) - 1u) s_json_len = sizeof(s_json) - 1u;
}

static void Json_Send(struct netconn *c)
{
  netconn_write(c, s_hdr_json, sizeof(s_hdr_json) - 1u, NETCONN_COPY);
  netconn_write(c, s_json, s_json_len, NETCONN_COPY);
}

/* Query parameter as unsigned number; hex if base 16. Returns def if missing. */
static uint32_t Query_U32(const char *q, const char *key, int base, uint32_t def)
{
  size_t kl = strlen(key);
  const char *p = q;

  while (p != NULL && *p != '\0')
  {
    if (strncmp(p, key, kl) == 0 && p[kl] == '=') return (uint32_t)strtoul(&p[kl + 1u], NULL, base);
    p = strchr(p, '&');
    if (p != NULL) p++;
  }
  return def;
}

/* Query parameter as hex bytes ("0a1b.."); returns the byte count, 0xFF if malformed. */
static uint8_t Query_Hex(const char *q, const char *key, uint8_t *out, uint8_t max)
{
  size_t kl = strlen(key);
  const char *p = q;

  while (p != NULL && *p != '\0')
  {
    if (strncmp(p, key, kl) == 0 && p[kl] == '=')
    {
      uint8_t n = 0u;

      p += kl + 1u;
      while (*p != '\0' && *p != '&')
      {
        char hx[3] = {p[0], p[1], '\0'};
        char *end;
        unsigned long v;

        if (n >= max || p[1] == '\0' || p[1] == '&') return 0xFFu;
        v = strtoul(hx, &end, 16);
        if (*end != '\0') return 0xFFu;
        out[n++] = (uint8_t)v;
        p += 2;
      }
      return n;
    }
    p = strchr(p, '&');
    if (p != NULL) p++;
  }
  return 0u;
}

static uint8_t Req_Parse(WebReq *r)
{
  char *sp1 = strchr(s_hdr, ' ');
  char *sp2;
  char *q;
  char *cl;
  size_t n;

  memset(r, 0, sizeof(*r));
  if (sp1 == NULL || (size_t)(sp1 - s_hdr) >= sizeof(r->method)) return 0u;
  memcpy(r->method, s_hdr, (size_t)(sp1 - s_hdr));
  sp2 = strchr(sp1 + 1, ' ');
  if (sp2 == NULL) return 0u;
  *sp2 = '\0';
  q = strchr(sp1 + 1, '?');
  if (q != NULL)
  {
    *q = '\0';
    strncpy(r->query, q + 1, sizeof(r->query) - 1u);
  }
  n = strlen(sp1 + 1);
  if (n >= sizeof(r->path)) return 0u;
  memcpy(r->path, sp1 + 1, n);

  cl = strstr(sp2 + 1, "Content-Length:");
  if (cl == NULL) cl = strstr(sp2 + 1, "content-length:");
  if (cl != NULL) r->content_length = (uint32_t)strtoul(cl + 15, NULL, 10);
  return 1u;
}

/* ---------- sensor ---------- */

/* newlib-nano printf has no %f: print 0.01-unit fixed point. */
static int PlcWeb_FmtCenti(char *buf, size_t len, float v)
{
  int32_t c = hvac_can_to_centi(v);
  uint32_t a = (uint32_t)((c < 0) ? -c : c);
  return snprintf(buf, len, "%s%lu.%02lu", (c < 0) ? "-" : "",
                  (unsigned long)(a / 100u), (unsigned long)(a % 100u));
}

static void PlcWeb_SendAi(struct netconn *c)
{
  static PlcAiSnapshot s;
  PlcRtcSnapshot rtc;
  char t[16], h[16], p[16];

  PlcCan_GetSnapshot(&s);
  PlcRtc_Get(&rtc);
  PlcWeb_FmtCenti(t, sizeof(t), s.meas.temperature_c);
  PlcWeb_FmtCenti(h, sizeof(h), s.meas.humidity_pct);

  s_json_len = 0u;
  Json_Add("{\"t\":%s,\"h\":%s,\"st\":%u,\"cnt\":%u,\"link\":%u,\"init\":%u,"
           "\"age\":%lu,\"rx_loco\":%lu,\"tx_hub\":%lu,\"tx_err\":%lu,"
           "\"rx_hub\":%lu,\"drop\":%lu,\"boff1\":%u,\"boff2\":%u,\"dsrc\":%u,",
           t, h, s.meas.status, s.meas.counter, s.loco_link, s.init_ok,
           (unsigned long)s.age_ms, (unsigned long)s.rx_loco, (unsigned long)s.tx_hub,
           (unsigned long)s.tx_hub_err, (unsigned long)s.rx_hub, (unsigned long)s.rx_drop,
           s.loco_bus_off, s.hub_bus_off, s.doors_src);
  Json_Add("\"src\":[");
  for (uint8_t i = 0u; i < s.src_n; i++)
  {
    const PlcAiSource *a = &s.src[i];
    PlcWeb_FmtCenti(t, sizeof(t), a->meas.humidity_pct);
    PlcWeb_FmtCenti(h, sizeof(h), a->meas.temperature_c);
    Json_Add("%s{\"r\":%u,\"p\":%u,\"v1\":%s,\"v2\":%s,\"st\":%u,\"age\":%lu}", (i > 0u) ? "," : "",
             a->meas.rail, a->meas.place, t, h, a->meas.status, (unsigned long)a->age_ms);
  }
  PlcWeb_FmtCenti(t, sizeof(t), s.room.temperature_c);
  PlcWeb_FmtCenti(h, sizeof(h), s.room.humidity_pct);
  PlcWeb_FmtCenti(p, sizeof(p), s.room.pressure_pa);
  Json_Add("],\"room\":{\"t\":%s,\"h\":%s,\"p\":%s,\"st\":%u},", t, h, p, s.room.status);
  Json_Add("\"rtc\":{\"ok\":%u,\"valid\":%u,\"t\":\"%04u-%02u-%02uT%02u:%02u:%02uZ\",\"err\":%lu,\"sets\":%lu,"
           "\"i2cErr\":%lu,\"scan\":%u,\"scanFirst\":%u}}",
           rtc.present, rtc.valid, rtc.t.year, rtc.t.month, rtc.t.day, rtc.t.hour, rtc.t.min, rtc.t.sec,
           (unsigned long)rtc.errors, (unsigned long)rtc.sets, (unsigned long)rtc.last_err, rtc.scan_n,
           rtc.scan_first);
  Json_Send(c);
}

static void PlcWeb_FwResult(struct netconn *c, uint8_t err);

/* t=YYYYMMDDhhmmss (UTC). */
static void PlcWeb_RtcSet(struct netconn *c, const WebReq *r)
{
  const char *p = strstr(r->query, "t=");
  char d[15];
  PlcRtcTime t;

  if (p == NULL || (p != r->query && p[-1] != '&') || strlen(p + 2) < 14u) { PlcWeb_FwResult(c, 1u); return; }
  memcpy(d, p + 2, 14u);
  d[14] = '\0';
  for (uint8_t i = 0u; i < 14u; i++) if (d[i] < '0' || d[i] > '9') { PlcWeb_FwResult(c, 1u); return; }
#define D2(i) ((uint8_t)((d[i] - '0') * 10 + (d[(i) + 1] - '0')))
  t.year = (uint16_t)(D2(0) * 100u + D2(2));
  t.month = D2(4);
  t.day = D2(6);
  t.hour = D2(8);
  t.min = D2(10);
  t.sec = D2(12);
#undef D2
  PlcWeb_FwResult(c, PlcRtc_RequestSet(&t) ? 0u : 1u);
}

/* ---------- CAN3 / doors master ---------- */

static long Age_Json(uint32_t ms)
{
  return (ms == 0xFFFFFFFFu) ? -1L : (long)ms;
}

static void PlcWeb_Can3(struct netconn *c)
{
  static PlcCan3Frame fr[PLC_CAN3_LOG_LEN];
  PlcCan3Snapshot s;
  PlcAiSnapshot a;
  uint8_t n = PlcCan_GetCan3(&s, fr, PLC_CAN3_LOG_LEN);
  const char *sep = "";

  PlcCan_GetSnapshot(&a);
  s_json_len = 0u;
  Json_Add("{\"ok\":%u,\"boff\":%u,\"passive\":%u,\"tec\":%u,\"rec\":%u,\"rx\":%lu,\"rxExt\":%lu,"
           "\"tx\":%lu,\"txErr\":%lu,\"doorsSrc\":%u,",
           s.ok, s.bus_off, s.err_passive, s.tec, s.rec, (unsigned long)s.rx, (unsigned long)s.rx_ext,
           (unsigned long)s.tx, (unsigned long)s.tx_err, a.doors_src);
  Json_Add("\"dm\":{\"link\":%u,\"closed\":%u,\"locked\":%u,\"fault\":%u,\"st\":%u,\"cnt\":%u,\"doors\":%u,"
           "\"ver\":%u,\"age\":%ld,\"rx\":%lu,\"txPlc\":%lu,\"cmdSeq\":%u,\"cmd\":%u,",
           s.dm.link, s.dm.closed, s.dm.locked, s.dm.fault, s.dm.status, s.dm.counter, s.dm.doors,
           s.dm.version, Age_Json(s.dm.age_ms), (unsigned long)s.dm.rx_state, (unsigned long)s.dm.tx_plc,
           s.dm.cmd_seq, s.dm.cmd_code);
  Json_Add("\"ack\":{\"valid\":%u,\"seq\":%u,\"cmd\":%u,\"res\":%u,\"age\":%ld}},\"frames\":[",
           s.dm.ack_valid, s.dm.ack_seq, s.dm.ack_cmd, s.dm.ack_res, Age_Json(s.dm.ack_age_ms));
  for (uint8_t i = 0u; i < n; i++)
  {
    Json_Add("%s{\"age\":%lu,\"id\":%u,\"d\":\"", sep, (unsigned long)fr[i].age_ms, fr[i].id);
    for (uint8_t k = 0u; k < fr[i].dlc; k++) Json_Add("%02x", fr[i].d[k]);
    Json_Add("\"}");
    sep = ",";
  }
  Json_Add("]}");
  Json_Send(c);
}

static void PlcWeb_Can3Send(struct netconn *c, const WebReq *r)
{
  uint8_t d[8];
  uint32_t id = Query_U32(r->query, "id", 16, 0xFFFFFFFFu);
  uint8_t n = Query_Hex(r->query, "data", d, sizeof(d));

  if (id > 0x7FFu || n == 0xFFu) { PlcWeb_FwResult(c, 1u); return; }
  PlcWeb_FwResult(c, PlcCan_SendCan3Raw((uint16_t)id, n, d) ? 0u : 2u);
}

static void PlcWeb_DoorsCmd(struct netconn *c, const WebReq *r)
{
  uint32_t cmd = Query_U32(r->query, "cmd", 10, 0xFFFFFFFFu);
  uint8_t mask = (uint8_t)Query_U32(r->query, "mask", 16, 0xFFu);
  uint8_t seq = 0u;

  s_json_len = 0u;
  if (cmd > 0xFFu)                                   Json_Add("{\"ok\":false,\"err\":1}");
  else if (!PlcCan_DoorsCmd((uint8_t)cmd, mask, &seq)) Json_Add("{\"ok\":false,\"err\":2}");
  else                                               Json_Add("{\"ok\":true,\"seq\":%u}", seq);
  Json_Send(c);
}

/* ---------- firmware API ---------- */

static void PlcWeb_FwStatus(struct netconn *c, const WebReq *r)
{
  static PlcFwupdLog log[PLC_FWUPD_LOG_LEN];
  uint32_t after = Query_U32(r->query, "log", 10, 0u);
  uint32_t now = osKernelGetTickCount();
  uint32_t nlog;
  const char *sep = "";

  s_json_len = 0u;
  Json_Add("{\"up\":%lu,\"boot\":%lu,\"store\":%u,\"jedec\":\"%06lx\",\"upload\":%u,",
           (unsigned long)now, (unsigned long)s_boot_key, g_plc_fwupd.store_ok,
           (unsigned long)W25q_JedecId(), FwStore_UploadActive());
  Json_Add("\"run\":{\"active\":%u,\"type\":%u,\"mode\":%u,\"ver\":%u,\"done\":%u,\"failed\":%u,\"rollback\":%u},",
           g_plc_fwupd.run_active, g_plc_fwupd.run_type, g_plc_fwupd.run_mode, g_plc_fwupd.run_version,
           g_plc_fwupd.run_done, g_plc_fwupd.run_failed, g_plc_fwupd.run_rollback);
  Json_Add("\"busy\":%u,\"busyTag\":\"%06lx\",\"step\":%u,\"progress\":%u,",
           g_plc_fwupd.busy, (unsigned long)g_plc_fwupd.busy_tag, g_plc_fwupd.step, g_plc_fwupd.progress);
  Json_Add("\"stats\":{\"ok\":%lu,\"failed\":%lu,\"retries\":%lu,\"rx\":%lu,\"drop\":%lu},",
           (unsigned long)g_plc_fwupd.updates_ok, (unsigned long)g_plc_fwupd.updates_failed,
           (unsigned long)g_plc_fwupd.block_retries, (unsigned long)g_plc_fwupd.rx_frames,
           (unsigned long)g_plc_fwupd.rx_drop);

  Json_Add("\"slots\":[");
  for (uint8_t t = 1u; t < FWSTORE_TYPES; t++)
  {
    for (uint8_t i = 0u; i < 2u; i++)
    {
      FwStoreSlot s;

      FwStore_GetSlot(t, i, &s);
      if (s.role == FWSTORE_ROLE_EMPTY) continue;
      Json_Add("%s{\"type\":%u,\"idx\":%u,\"role\":%u,\"board\":%u,\"ver\":%u,\"size\":%lu,\"crc\":\"%08lx\"}",
               sep, t, i, s.role, s.board_rev, s.version, (unsigned long)s.size, (unsigned long)s.crc);
      sep = ",";
    }
  }

  Json_Add("],\"nodes\":[");
  sep = "";
  for (uint32_t i = 0u; i < PLC_FWUPD_MAX_NODES; i++)
  {
    volatile PlcFwupdNode *n = &g_plc_fwupd.nodes[i];

    if (n->tag == 0u) continue;
    Json_Add("%s{\"tag\":\"%06lx\",\"type\":%u,\"board\":%u,\"state\":%u,\"boot\":%u,\"ver\":%u,\"fails\":%u,"
             "\"link\":%u,\"mismatch\":%u,\"result\":%u,\"attempts\":%u,\"err\":%u,\"step\":%u,\"age\":%lu,\"bus\":%u}",
             sep, (unsigned long)n->tag, n->module_type, n->board_rev, n->state, n->boot_version, n->app_version,
             n->boot_fails, n->link, n->version_mismatch, n->result, n->attempts, n->last_err, n->last_step,
             (unsigned long)(now - n->last_seen), n->bus);
    sep = ",";
  }

  Json_Add("],\"log\":[");
  sep = "";
  nlog = PlcFwupd_GetLog(after, log, PLC_FWUPD_LOG_LEN);
  for (uint32_t i = 0u; i < nlog; i++)
  {
    Json_Add("%s{\"id\":%lu,\"t\":%lu,\"tag\":\"%06lx\",\"type\":%u,\"ev\":%u,\"err\":%u,\"step\":%u,\"from\":%u,\"to\":%u}",
             sep, (unsigned long)log[i].id, (unsigned long)log[i].t_ms, (unsigned long)log[i].tag, log[i].module_type,
             log[i].event, log[i].err, log[i].step, log[i].ver_from, log[i].ver_to);
    sep = ",";
  }
  Json_Add("]}");
  Json_Send(c);
}

static void PlcWeb_FwResult(struct netconn *c, uint8_t err)
{
  s_json_len = 0u;
  if (err == 0u) Json_Add("{\"ok\":true}");
  else           Json_Add("{\"ok\":false,\"err\":%u}", err);
  Json_Send(c);
}

static void PlcWeb_FwRun(struct netconn *c, const WebReq *r)
{
  uint8_t type = (uint8_t)Query_U32(r->query, "type", 10, 0u);
  uint8_t mode = (uint8_t)Query_U32(r->query, "mode", 10, 0u);

  PlcWeb_FwResult(c, PlcFwupd_RequestRun(type, mode));
}

static void PlcWeb_FwUploadDone(struct netconn *c, uint8_t err)
{
  FwStoreSlot s;

  if (err == FWSTORE_OK) err = FwStore_UploadEnd(&s);
  else FwStore_UploadAbort();

  s_json_len = 0u;
  if (err == FWSTORE_OK)
  {
    PlcFwupd_Log(PLC_FWUPD_EV_UPLOAD_OK, 0u, s.module_type, 0u, 0u, 0u, s.version);
    Json_Add("{\"ok\":true,\"type\":%u,\"board\":%u,\"ver\":%u,\"size\":%lu,\"crc\":\"%08lx\"}",
             s.module_type, s.board_rev, s.version, (unsigned long)s.size, (unsigned long)s.crc);
  }
  else
  {
    PlcFwupd_Log(PLC_FWUPD_EV_UPLOAD_FAIL, 0u, 0u, err, 0u, 0u, 0u);
    Json_Add("{\"ok\":false,\"err\":%u}", err);
  }
  Json_Send(c);
}

/* ---------- configuration API ---------- */

static void PlcWeb_CfgStatus(struct netconn *c)
{
  static PlcIdFound found[PLC_ID_MAX_FOUND];
  PlcCfgSummary s;
  PlcIdSummary ids;
  PlcIdFound e;
  uint8_t nfound;
  const char *sep = "";
  uint32_t now = osKernelGetTickCount();

  PlcCfg_GetSummary(&s);
  PlcId_GetSummary(&ids);
  s_json_len = 0u;
  Json_Add("{\"up\":%lu,\"flash\":%u,\"present\":%u,\"gen\":%u,\"state\":%u,\"size\":%lu,\"crc\":\"%08lx\","
           "\"project\":\"%s\",\"modules\":%u,\"channels\":%u,\"applied\":%lu,\"resends\":%lu,"
           "\"extraLoco\":%u,\"extraAi\":%u,\"problems\":%u,\"plcVer\":%u,",
           (unsigned long)now, s.flash_ok, s.present, s.gen, s.state, (unsigned long)s.size,
           (unsigned long)s.crc, s.project, s.module_count, s.channel_count, (unsigned long)s.applied_ms,
           (unsigned long)s.resends, s.extra_loco, s.extra_ai, s.problems, PLC_FW_VERSION);
  Json_Add("\"walk\":{\"busy\":%u,\"walks\":%u,\"count\":%u,\"stray\":%u,\"age\":%lu},\"mods\":[",
           ids.busy, ids.walks, ids.count, ids.stray, (unsigned long)(ids.walks ? (now - ids.done_ms) : 0u));
  for (uint16_t i = 0u; i < s.module_count; i++)
  {
    HvacCfgModule m;
    PlcCfgModState st;

    if (!PlcCfg_GetModule(i, &m, &st)) break;
    Json_Add("%s{\"type\":%u,\"l\":%u,\"r\":%u,\"p\":%u,\"st\":%u,\"err\":%u,\"ok\":%u,\"bad\":%u,\"ver\":%u,"
             "\"fc\":%u,\"tag\":\"%06lx\"}",
             sep, m.type, m.line, m.rail, m.place, st.state, st.err, st.ok_mask, st.bad_mask, st.version,
             st.found_cat, (unsigned long)st.tag);
    sep = ",";
  }
  Json_Add("],\"extra\":[");
  sep = "";
  for (uint8_t i = 0u; i < s.extra_count && PlcCfg_GetExtra(i, &e); i++)
  {
    Json_Add("%s{\"type\":%u,\"l\":%u,\"r\":%u,\"p\":%u,\"tag\":\"%06lx\"}",
             sep, e.cat, e.line, e.rail, e.place, (unsigned long)e.tag);
    sep = ",";
  }
  Json_Add("],\"found\":[");
  sep = "";
  nfound = PlcId_GetFound(found, PLC_ID_MAX_FOUND);
  for (uint8_t i = 0u; i < nfound; i++)
  {
    Json_Add("%s{\"type\":%u,\"l\":%u,\"r\":%u,\"p\":%u,\"tag\":\"%06lx\",\"board\":%u}",
             sep, found[i].cat, found[i].line, found[i].rail, found[i].place, (unsigned long)found[i].tag,
             found[i].board);
    sep = ",";
  }
  Json_Add("]}");
  Json_Send(c);
}

static void PlcWeb_CfgUploadDone(struct netconn *c, uint8_t err)
{
  uint8_t gen = 0u;

  if (err == PLC_CFG_OK) err = PlcCfg_UploadEnd(&gen);
  s_json_len = 0u;
  if (err == PLC_CFG_OK) Json_Add("{\"ok\":true,\"gen\":%u}", gen);
  else                   Json_Add("{\"ok\":false,\"err\":%u}", err);
  Json_Send(c);
}

/* ---------- request handling ---------- */

#define BODY_NONE    0u
#define BODY_UPLOAD  1u
#define BODY_DRAIN   2u
#define BODY_CFG     3u

static void PlcWeb_Serve(struct netconn *c)
{
  struct netbuf *nb = NULL;
  WebReq r;
  uint32_t hlen = 0u;
  uint8_t hdr_done = 0u;
  uint8_t body = BODY_NONE;
  uint8_t up_err = FWSTORE_OK;
  uint32_t got = 0u;

  for (;;)
  {
    if (netconn_recv(c, &nb) != ERR_OK)
    {
      if (body == BODY_UPLOAD) FwStore_UploadAbort();
      return;
    }

    do
    {
      uint8_t *p;
      u16_t dl;

      netbuf_data(nb, (void **)&p, &dl);
      while (dl > 0u)
      {
        if (!hdr_done)
        {
          char *end;

          while (dl > 0u && hlen < PLC_WEB_HDR_MAX)
          {
            s_hdr[hlen++] = (char)*p++;
            dl--;
            if (hlen >= 4u && memcmp(&s_hdr[hlen - 4u], "\r\n\r\n", 4u) == 0) break;
          }
          s_hdr[hlen] = '\0';
          end = strstr(s_hdr, "\r\n\r\n");
          if (end == NULL)
          {
            if (hlen >= PLC_WEB_HDR_MAX) { netbuf_delete(nb); netconn_write(c, s_400, sizeof(s_400) - 1u, NETCONN_COPY); return; }
            continue;
          }
          hdr_done = 1u;
          if (!Req_Parse(&r)) { netbuf_delete(nb); netconn_write(c, s_400, sizeof(s_400) - 1u, NETCONN_COPY); return; }

          if (strcmp(r.method, "POST") == 0 && strcmp(r.path, "/api/fw/upload") == 0)
          {
            uint32_t size = Query_U32(r.query, "size", 10, 0u);

            if (g_plc_fwupd.run_active) up_err = FWSTORE_E_BUSY;
            else if (size != r.content_length) up_err = FWSTORE_E_SIZE;
            else up_err = FwStore_UploadBegin(size, Query_U32(r.query, "crc", 16, 0u));
            body = (up_err == FWSTORE_OK) ? BODY_UPLOAD : BODY_DRAIN;
          }
          else if (strcmp(r.method, "POST") == 0 && strcmp(r.path, "/api/cfg") == 0)
          {
            uint32_t size = Query_U32(r.query, "size", 10, 0u);

            up_err = (size != r.content_length) ? PLC_CFG_E_SIZE
                                                : PlcCfg_UploadBegin(size, Query_U32(r.query, "crc", 16, 0u));
            body = (up_err == PLC_CFG_OK) ? BODY_CFG : BODY_DRAIN;
          }
          else if (r.content_length > 0u)
          {
            body = BODY_DRAIN;
          }
        }
        else
        {
          uint32_t n = r.content_length - got;

          if (n > dl) n = dl;
          if (body == BODY_UPLOAD && up_err == FWSTORE_OK) up_err = FwStore_UploadWrite(p, n);
          if (body == BODY_CFG) PlcCfg_UploadWrite(p, n);
          got += n;
          p += n;
          dl = (u16_t)(dl - n);
          if (got >= r.content_length) dl = 0u;
        }
      }
    } while (netbuf_next(nb) >= 0);
    netbuf_delete(nb);

    if (hdr_done && got >= r.content_length) break;
  }

  if (s_boot_key == 0u) s_boot_key = (HAL_GetUIDw0() ^ (SysTick->VAL << 12) ^ osKernelGetTickCount()) | 1u;

  if (strcmp(r.path, "/api/fw/upload") == 0 && strcmp(r.method, "POST") == 0)
  {
    PlcWeb_FwUploadDone(c, up_err);
  }
  else if (strcmp(r.path, "/api/cfg") == 0 && strcmp(r.method, "POST") == 0)
  {
    PlcWeb_CfgUploadDone(c, up_err);
  }
  else if (strcmp(r.method, "GET") == 0 && strcmp(r.path, "/api/cfg/status") == 0)
  {
    PlcWeb_CfgStatus(c);
  }
  else if (strcmp(r.method, "GET") == 0 && strcmp(r.path, "/api/fw/status") == 0)
  {
    PlcWeb_FwStatus(c, &r);
  }
  else if (strcmp(r.method, "POST") == 0 && strcmp(r.path, "/api/fw/run") == 0)
  {
    PlcWeb_FwRun(c, &r);
  }
  else if (strcmp(r.method, "POST") == 0 && strcmp(r.path, "/api/fw/cancel") == 0)
  {
    PlcFwupd_Cancel();
    PlcWeb_FwResult(c, 0u);
  }
  else if (strcmp(r.method, "POST") == 0 && strcmp(r.path, "/api/fw/rollback") == 0)
  {
    PlcWeb_FwResult(c, PlcFwupd_RequestRollback((uint8_t)Query_U32(r.query, "type", 10, 0u)));
  }
  else if (strcmp(r.method, "POST") == 0 && strcmp(r.path, "/api/id/walk") == 0)
  {
    PlcId_RequestWalk();
    PlcWeb_FwResult(c, 0u);
  }
  else if (strcmp(r.method, "GET") == 0 && strcmp(r.path, "/api/ai") == 0)
  {
    PlcWeb_SendAi(c);
  }
  else if (strcmp(r.method, "POST") == 0 && strcmp(r.path, "/api/rtc/set") == 0)
  {
    PlcWeb_RtcSet(c, &r);
  }
  else if (strcmp(r.method, "GET") == 0 && strcmp(r.path, "/api/can3") == 0)
  {
    PlcWeb_Can3(c);
  }
  else if (strcmp(r.method, "POST") == 0 && strcmp(r.path, "/api/can3/send") == 0)
  {
    PlcWeb_Can3Send(c, &r);
  }
  else if (strcmp(r.method, "POST") == 0 && strcmp(r.path, "/api/doors/cmd") == 0)
  {
    PlcWeb_DoorsCmd(c, &r);
  }
  else if (strcmp(r.method, "GET") == 0 && strcmp(r.path, "/") == 0)
  {
    netconn_write(c, s_hdr_html, sizeof(s_hdr_html) - 1u, NETCONN_COPY);
    netconn_write(c, s_page, sizeof(s_page) - 1u, NETCONN_COPY);
  }
  else
  {
    netconn_write(c, s_404, sizeof(s_404) - 1u, NETCONN_COPY);
  }
}

void PlcWeb_Task(void)
{
  struct netconn *srv;

  for (;;)
  {
    srv = netconn_new(NETCONN_TCP);
    if (srv != NULL)
    {
      ip_set_option(srv->pcb.tcp, SOF_REUSEADDR);
      if (netconn_bind(srv, IP_ADDR_ANY, PLC_WEB_PORT) == ERR_OK && netconn_listen(srv) == ERR_OK)
      {
        for (;;)
        {
          struct netconn *c = NULL;
          err_t e = netconn_accept(srv, &c);

          if (e == ERR_OK)
          {
            netconn_set_recvtimeout(c, PLC_WEB_RX_TMO_MS);
            PlcWeb_Serve(c);
            netconn_close(c);
            netconn_delete(c);
          }
          else if (e != ERR_TIMEOUT)
          {
            break;
          }
        }
      }
      netconn_delete(srv);
    }
    osDelay(1000);
  }
}
