Morfey1974/HVAC_CleanRoom_Project/Firmware_Displays/Display_TFT4.3/Application/Core/Src/logo_ad.c

#include "logo_ad.h"

const uint16_t LogoAd_RGB565[LOGO_AD_WIDTH * LOGO_AD_HEIGHT] = {
  0xCE79U, 0xCE79U, 0xCE79U, 0xCE79U, 0xCE79U, 0xCE79U, 0xCE79U, 0xCE79U, 0xCE79U, 0xCE79U, 0xCE79U, 0xCE79U,
  0xCE79U, 0xCE79U, 0xCE79U, 0xCE79U, 0xCE79U, 0xCE79U, 0xCE79U, 0xCE79U, 0xCE79U, 0xCE79U, 0xCE79U, 0xCE79U,
  0xCE79U, 0xCE79U, 0xCE79U, 0xCE79U, 0xCE79U, 0xCE79U, 0xCE79U, 0xCE79U, 0xCE79U, 0xCE79U, 0xCE79U, 0xCE79U,
  0xCE79U, 0xCE79U, 0xCE79U, 0xCE79U, 0xCE79U, 0xCE79U, 0xCE79U, 0xCE79U, 0xCE79U, 0xCE79U, 0xCE79U, 0xCE79U,
  0xCE79U, 0xCE79U, 0xCE79U, 0xCE79U, 0xCE79U, 0xCE79U, 0xCE79U, 0xCE79U, 0xCE79U, 0xCE79U, 0xCE79U, 0xCE79U,
  0xCE79U, 0xCE79U, 0xCE79U, 0xCE79U, 0xCE79U, 0xCE79U, 0xCE79U, 0xCE79U, 0xCE79U, 0xCE79U, 0xCE79U, 0xCE79U,
  0xCE79U, 0xCE79U, 0xCE79U, 0xCE79U, 0xCE79U, 0xCE79U, 0xCE79U, 0xCE79U, 0xCE79U, 0xCE79U, 0xCE79U, 0xCE79U,
  0xCE79U, 0xCE79U, 0xCE79U, 0xCE79U, 0xCE79U, 0xCE79U, 0xCE79U, 0xCE79U, 0xCE79U, 0xCE79U, 0xCE79U, 0xCE79U,
  0xCE79U, 0xCE79U, 0xCE79U, 0xCE79U, 0xCE79U, 0xCE79U, 0xCE79U, 0xCE79U, 0xCE79U, 0xCE79U, 0xCE79U, 0xCE79U,
  0xCE79U, 0xCE79U, 0xCE79U, 0xCE79U, 0xCE79U, 0xCE79U, 0xCE79U, 0xCE79U, 0xCE79U, 0xCE79U, 0xCE79U, 0xCE79U,
  0xCE79U, 0xCE79U, 0xCE79U, 0xCE79U, 0xCE79U, 0xCE79U, 0xCE79U, 0xCE79U, 0xCE79U, 0xCE79U, 0xCE79U, 0xCE79U,
  0xCE79U, 0xCE79U, 0xCE79U, 0xCE79U, 0xCE79U, 0xCE79U, 0xCE79U, 0xCE79U, 0xCE79U, 0xCE79U, 0xCE79U, 0xCE79U,
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
  0xCE79U, 0xCE79U, 0xCE79U, 0xCE79U, 0xCE79U, 0xCE79U, 0xCE79U, 0xCE79U, 0xCE79U, 0xCE79U, 0xCE79U, 0xCE79U,
  0xCE79U, 0xCE79U, 0xCE79U, 0xCE79U, 0xCE79U, 0xCE79U, 0xCE79U, 0xCE79U, 0xCE79U, 0xCE79U, 0xCE79U, 0xCE79U,
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
};
