Morfey1974/HVAC_CleanRoom_Project/(commit log)

2026-08-01 Initial commit HVAC_CleanRoom_Project
    [EVAL-CN0321-SDPZ Schematics.sch, EVAL-CN0321-SDPZ_BOM_Rev0.xlsx, EVAL-CN0321-SDPZ_Layout_Rev0.pcb, EVAL-CN0321-SDPZ_XY.xlsx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]
2026-08-30 Auto-save HVAC Project
    [2026_08_17_12_07 _20_0242 _ 2026_08_17_12_07_20_0243.dxf, 2026_08_17_12_07 _20_0542 _ 2026_08_17_12_07_20_0542.dxf, PHOENIX_CONTACT_Cart_Export_2026-08-17.xlsx, PhoenixContact_1.stp, PhoenixContact_2.stp, Plata.dxf, Project_Costs.xlsx]
2026-10-01 Pass AI sensor data AI -> Locomotive -> HUB -> display over CAN
    Add Shared_Libs/hvac_can.h with frame 0x301 (humidity, temperature, status, counter). AI reports per-channel 4-20 mA faults and ADC timeouts; Locomotive sends NO_LINK when the AI module is silent; Locomotive and HUB guard TX FIFO writes from the main loop against the RX interrupt; display submodule shows faults.
2026-10-04 MainPLC: CAN gateway, Modbus RTU doors poll, web page; display doors block; firmware update concept; docs and web configurator
    [PhoenixContact_1.stp, Plata.dxf, Project_Costs.xlsx]
2026-10-05 Ethernet firmware update (W25Q store, PLC fw API, web Firmware tab), Locomotive bootloader project, sensor outputs, channel-to-sensor binding, live PLC data and room cards in monitoring
    [Firmware_Locomotive_Bootloader.ioc, boot_core.c, boot_core.h, fwupd_app.c, fwupd_app.h]
2026-10-05 PLC project configuration: HCFG file upload to W25Q, module apply and chain check over CAN (0x330/0x331), AI configurable channels, Loco forwarding, web Upload to PLC page
2026-10-06 Bootloaders for AI, HUB and TFT4.3 (H7), PLC update on both buses, module ID walk with config places and mismatch reports (web + display), firmware rollback, ID input fixes for current boards
    [Analog_Modul_AI_Bootloader.ioc, Firmware_HUB_Displays_Bootloader.ioc, boot_core.c, boot_core.h]
2026-10-06 PLC 1.4: ID line 3 on CAN3, doors master CAN protocol and web check page; firmware log paging, add-from-build button, DCM header logo, API restart script
2026-10-08 Add Analog_Modul_AI_AO firmware projects (AI copy + DAC8760 SPI2 pins, AI_MODE switch); web HMI screens and element library
2026-10-12 PLC RTC and header clock; pressure to displays via room frames; display-to-room binding (config format 2); 'not used' channel option
